supermadboy/boxbert/docs/cad/feather-window/electronics-photo.jpg

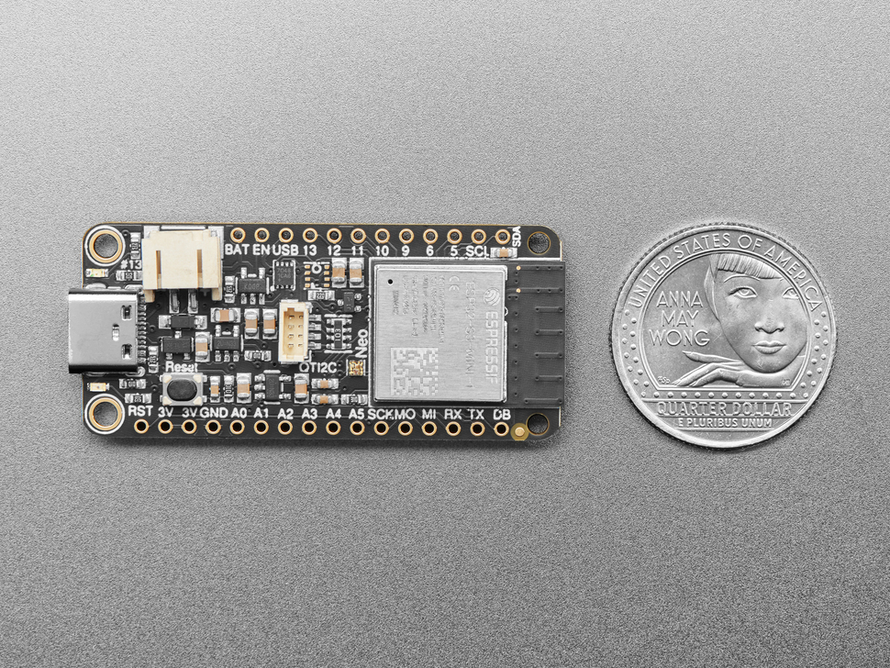
docs/cad/feather-window/electronics-photo.jpg
