supermadboy/boxbert/docs/cad/pn532/photo-correction-2026-11-10/desired-exterior-component-side.jpg

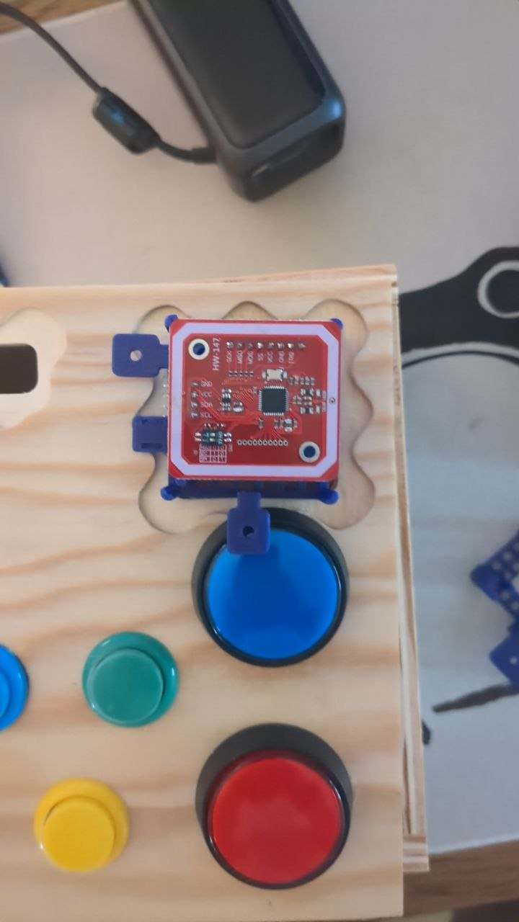
docs/cad/pn532/photo-correction-2026-11-10/desired-exterior-component-side.jpg
