supermadboy/boxbert/ideen/bluetooth-lautsprecher/README.md

# Bluetooth-Lautsprecher-Modus

## Beschreibung

Boxbert als Bluetooth-Lautsprecher für externe Geräte verwenden.

## Bisheriger Stand

BLE und klassische Bluetooth-Audioübertragung nicht gleichsetzen. Board-Kompatibilität noch gezielt zu prüfen.

## Noch zu besprechen / prüfen

Gewünschte Audioquelle und Profil klären; ESP32-S3-Fähigkeiten gegen Herstellerdoku prüfen.

## Entscheidungen und Nachweise

[Bestehende Projektdokumentation](../../hardware/BOM.md). Neue Entscheidungen und echte
Prüfergebnisse hier ergänzen und in die zuständige Fachdatei übernehmen.
