supermadboy/boxbert/hardware/noch-zu-besorgen.md

# Noch zu besorgen — Boxbert

Beschlossene Ergänzungen, nicht als bereits gekauft behandeln. Daddelbert
bestellt selbst. Mengen/Längen und konkrete Produkte sind noch offen.

## Kabel für den Endaufbau

- [ ] **AWG 20**, ca. **0,52 mm²**: Hauptversorgung (zusätzliche Akku–Boost-
  Leitungen und Boost–Verteiler) sowie zugehörige GND-Leitungen.
- [ ] **AWG 22**, ca. **0,33 mm²**: Versorgungsabzweige zu SD-Modul,
  Verstärker und NeoPixel-Stick, jeweils Versorgung und GND.
- [ ] **AWG 26**, ca. **0,13 mm²**: Signalleitungen und Taster.

Flexible **Kupferlitze**, kein starrer Draht und kein CCA. Für Versorgung
rot/schwarz, für Signale weitere Farben zur eindeutigen Zuordnung.
Querschnitte sind praktische Empfehlungen für kurze interne Leitungen,
keine gemessene Gesamtstrom-/Steckerfreigabe. Bestehendes Akkukabel nicht
ersetzen. Strombelastbarkeit der Verbindung Deckel–Boden separat prüfen;
Stromversorgung zunächst mit separaten Litzen statt beliebigem Flachbandkabel
planen. GND der Hauptversorgung trägt den gemeinsamen Rückstrom.
