supermadboy/boxbert/docs/pwa-uebergabe.md

# PWA-Übergabe nach UX-/Effekt-Ausbau

## Aktueller Einstieg

Live-Demo: https://habibi.supermittel.com/boxbert/?stand=ux-effects-4

Quelle ausschließlich `app/` in diesem Boxbert-Repo. In `ai-habibi/sites/boxbert/` liegen Hostingintegration und getracktes Deployment-Artefakt, keine zweite App-Quelle. `app/README.md` erklärt Nutzung, Adaptergrenzen und Bauen. Prüfungen: `app/docs/verification-ux.md` und `app/docs/verification-led-effects.md`.

## Vereinbarter Umfang ist umgesetzt

Drei Reiter Medienbibliothek/Zuordnung/LEDs, fixed Lautstärkebar, Medienkategorien Sounds/Musik (weiterhin nur MP3), System-Dark/Light, zehn grafische Demo-Buttons, umbenennbare RFID-Tags, unabhängiger Stick mit acht Pixeln und Onboard-Einzelpixel. Palette Einfarbig/Regenbogen ist unabhängig von Effekten. Stick: statisch, Atmen, links/rechts laufend, Mitte nach außen, sanfte Party. Onboard: zusätzlich langsamer Farbwechsel und Kerzen-Licht. Kein schnelles Stroboskop. Animation hält bei Reduced Motion an und pausiert im Hintergrund/bei Reiterwechsel.

Altdaten werden migriert; Dateien, Zuordnungen, Tag-Namen, Lautstärke und gültige LED-Einstellungen bleiben erhalten. Demo-Uploads speichern nur Metadaten; Namen, Kategorien, Button- und LED-Einstellungen liegen im Browser, nicht auf echter SD. Demo ist ausdrücklich Simulation.

42 Unit-/Vertrags-/Migration-/Engine-Tests bestanden. Parent hat Unit-Tests, echte HTTPS-Offlineprüfung, HTTPS-UX-Prüfung und HTTPS-Effektprüfung zusätzlich ausgeführt. Mobile/Desktop Hell/Dunkel und Lifecycle geprüft. Hintergrundereignis wurde im Headless-Browser kontrolliert simuliert. Kein echter ESP oder Android-Installationsdialog geprüft.

## Nicht Bestandteil dieser Umsetzung

Unabhängige Codeprüfung ohne blockierende Findings abgeschlossen.
Nichtblockierender UX-Hinweis für mögliche Folgearbeit: Bei Reiterwechsel
während eines Uploads läuft dieser weiter; Fortschritt/Abbrechen liegen derzeit
nur in der Medienbibliothek. Dort zurückwechseln, um den Transfer abzubrechen.
Eine zusätzliche HTTP-Moduswechsel-Regression mit LED-/Kategorie-Entwürfen
wurde angeregt, aber nicht zum Auftrag ergänzt.

Keine Firmware, TFT, BLE oder OTA geändert/geflasht. Etappe-5-HTTP-API bleibt `/files`, `/tags`, `/upload`; Gerätemodus zeigt fehlende Namens-/Kategorie-/Button-/Volume-/LED-APIs statt simulierten Geräteerfolg. Die Namensspeicherung auf SD ist als spätere Anforderung festgehalten. SD-Webhosting und die neuen APIs benötigen Firmwarearbeit und reale Hardwaretests, nicht nur Kopieren des SD-Webbuilds.

Der Release-Link mit Query umgeht online den bisherigen Service-Worker-Navigationscache; Offline ist die kanonische URL `/boxbert/` geprüft. Komfortables Update-Angebot ohne speziellen Link bleibt mögliche Folgearbeit, nicht ungefragt umgesetzt.

## Kurzer Folgeprompt bei Bedarf

> Wir machen bei Boxbert weiter. Lies `AGENTS.md`, `docs/pwa-uebergabe.md`, `app/README.md` und `To-Do.md` in `/home/habibi/projects/boxbert`. Der PWA-UX-/Effekt-Ausbau ist abgeschlossen und nur Demo; bestehende Firmware nicht ungefragt ändern. Meine nächste Aufgabe ist: …

Ein neuer Auftrag bestimmt den nächsten Schritt. Firmwareintegration nicht automatisch starten.
