supermadboy/boxbert/.hermes/plans/2026-10-16_151332-tft-v1-v2.md

# TFT V1/V2 Implementation Plan

**Aktueller Stand 18.10.2026:** V1 abgeschlossen; V2-Software mit optionalen
Boxbert-Frames abgeschlossen und online geprüft. Nachweise: `docs/tft-v2.md`
und `app/docs/verification-tft-v2.md`. Die ursprüngliche Recherche unten
bleibt als Herkunft erhalten; Hardwareintegration ist separat.

**Goal:** Eine verlässlich identische logische 240×135-Pixelanzeige im Browser und
auf dem ESP vorbereiten: zuerst V1 ohne Maskottchen, danach V2 mit optionalem
Boxbert-Sprite. Die Basis bleibt bei jedem Animationsfehler nutzbar.

**Architecture:** Ein kleiner gemeinsamer, deterministischer C++-Pixelrenderer
zeichnet UI und Bitmap-Schrift in RGB565. Auf dem ESP wird der Buffer über den
bestehenden ST7789-Treiber ausgegeben; im Browser läuft derselbe Renderer als
WebAssembly und wird ohne erneutes Textzeichnen auf Canvas dargestellt. V2
kopiert vorberechnete RGB565-Frames in denselben Buffer.

**Tech Stack:** vorhandener Arduino-/Adafruit-ST7789-Ausgabeweg, geplanter
plattformunabhängiger C++-Kern, Emscripten/WASM, React als Bedienhülle,
skriptgesteuertes Blender für optionale Assets. Dies ist ein recherchierter
Entwurf, keine bereits kompilierte oder auf Hardware geprüfte Integration.

## Auftrag und Freigabegrenze

16.10.2026: Daddelbert möchte einen sessionsübergreifenden Plan und Recherche,
noch keinen neuen Flash-/Firmwareauftrag. Aktuelle Vorschau gefällt; Schrift/
Typografie darf noch angepasst werden. Das Erscheinungsbild des Maskottchens
kann für eine zuverlässige Geräteumsetzung vereinfacht werden. Keine zwei
auseinanderlaufenden UI-Implementierungen. Firmware-Referenzen unverändert
lassen, keine neuen Pins/Partitionen/Funkfunktionen als Nebenauftrag.

Empfehlung: **diese Session mit Recherche/Plan abschließen, nächste Session nur
Phase 0/1**. Danach jede größere Phase mit eigenem klaren Startprompt. Dieser Plan
ist die persistente Checkliste; `To-Do.md` verweist darauf. Kein Wissen aus der
alten Chat-Historie als Voraussetzung.

## Umsetzung Phase 0/1 · 17.10.2026

Daddelbert bestätigte DejaVu Sans (Bold 16 px, Regular 12 px) und den Bau.
Gemeinsamer C++-Kern, echtes freistehendes WASM und die Canvas-Integration
sind gebaut. Native-/WASM-Pixelgleichheit, 51 App-Tests, TFT-/Lifecycle-/UX-
Browserprüfungen sowie echtes HTTPS und Offline-Neustart sind bestanden.
Nachweis: [TFT V1](../../app/docs/verification-tft-v1.md), Vertrag/Toolchain:
[TFT-Rendering](../../docs/tft-rendering.md).

Bewusste Toolchain-Konkretisierung: gepinntes LLVM/Clang + `wasm-ld` statt
Emscripten, da der Arduino-freie Kern weder libc noch JS-Glue benötigt.
Dasselbe C++ wird nativ und als WASM kompiliert. Der Browser expandiert nur
die RGB565-Kanäle zu RGBA; keine zweite Typografie-/Layoutimplementierung.
Ein statischer Framebuffer, keine zusätzliche Buffer-/DMA-/Task-Abstraktion.

**Aktueller Auftrag 18.10.2026:** Daddelbert bestätigt V1 als fertig und
beauftragt V2. V1 ist abgeschlossen. Die historische Phase 2 wird als spätere
ESP-Gesamtintegration separat verfolgt und sperrt V2 nicht. Kein neuer ESP-
Build-/Flash-/Hardware-Nachweis wird daraus abgeleitet. Referenzen bleiben
unverändert. Die folgenden Phasen/Startprompts sind die ursprüngliche Planung;
bei Abweichungen gilt diese aktuelle Freigabe.

## Befund aus dem Repo (historische Recherche)

- `firmware/tests/etappe7_gesamtmonitor/etappe7_gesamtmonitor.ino` verwendet
  Adafruit_GFX und Adafruit_ST7789. Initialisierung `init(135,240)` und
  `setRotation(1)`; SD und TFT teilen `SPI`, SD bei 4 MHz. Aktuelle
  Statusanzeige wird im Sketch einmal pro Sekunde erneuert. Diese Werte sind
  Quellbefunde, keine Messung der maximal möglichen Zeichenrate.
- Akkuwerte aus eigener Gauge-Task mit Wire-Mutex, Audio/NFC vorhanden.
  `currentSong` ist ein Name aus `TagMap`, Volume fest 6/21. WLAN wird im
  Referenzsketch nicht als vollständiger späterer UI-Zustandsvertrag geliefert.
- Die neue App-Vorschau ist bisher CSS/SVG/Systemschrift und hat feste Akku-/
  WLAN-/Volume-Beispiele plus simulierte Zeit. **Sie ist noch kein gleicher
  Pixelrenderer.** Quelle `app/src/TftPreview.jsx`, `tft.css` und
  `tft-status-icons.json`. Kein kompletter Geräte-Statusadapter vorhanden.
- `getAudioCurrentTime()` und `getAudioFileDuration()` existieren im dokumentierten
  Audio-Library-Stand 4.0.0.[7] Die Dauer kann dort bei fehlender Bitrate oder
  unbekannter Audio-Datengröße 0 zurückgeben; das muss als unbekannt behandelt
  werden, nicht mit einer Demo-Dauer kaschiert werden.[8]
- Gesamtintegration fehlt weiterhin: `docs/endinbetriebnahme.md`. Ein TFT-Build
  allein integriert nicht automatisch PWA/BLE/Upload/Intro oder Endaufbau.

## Format- und Werkzeugentscheidung (Empfehlung, noch kein Build)

### SVG, GIF und Sprites

- **Statussymbole:** keine SVG-Datei auf dem ESP voraussetzen. Die vorhandenen
  einfachen Symbolkoordinaten in gemeinsame konstante Zeichentabellen übernehmen.
  SVG bleibt optional ein Design-/Exportformat, nicht das Geräte-Laufzeitformat.
- **Schrift:** einmalige Bitmap-Glyphen mit festgelegten Metriken und Lizenz,
  identisch im gemeinsamen Renderer. Adafruit dokumentiert Bitmap-Fonts und
  `fontconvert` zur Konvertierung eigener TrueType-Schriften.[5] Nicht Browser-
  `fillText` gegen eine ähnliche TFT-Schrift testen und dann Gleichheit behaupten.
- **Boxbert:** Empfehlung **Blender-Python → PNG-Einzelbilder → RGB565-Framepaket**.
  Blender kann ohne GUI per Kommandozeile rendern; das ist ein geeigneter Weg
  für einen vollständig skriptbaren Asset-Build.[4] PNGs sind editierbare
  Master-/Zwischenbilder; der ESP bekommt zunächst feste RGB565-Pixeldaten mit
  Framegröße, Reihenfolge und Abspieldauer. Hintergrund zuerst deckend in der
  TFT-Hintergrundfarbe; keine transparente Mischpipeline als Zusatzkomplexität.
- Ein Sprite ist eine kleine Bildfolge, kein zwingend bestimmtes Dateiformat.
  Ein großes Sprite-Sheet muss nicht komplett ins RAM: Framepaket mit direktem
  Index und festen Größen ist der empfohlene erste Geräteentwurf.
- **GIF ist möglich**, aber für unseren ersten belastbaren Weg nicht empfohlen:
  AnimatedGIF kann von SD/Flash lesen; der Autor beschreibt Zusatzaufwand und
  Einschränkungen bei Transparenz, Paletten und Disposal-Modi.[3] Erst wählen,
  wenn ein gemessener Nutzen gegenüber einfachen Frames besteht. Kein GIF-Decoder
  allein für das Designpreview einführen.

### Warum gemeinsamer C++-Kern

Adafruit stellt 16-Bit-Canvasbuffer und RGB-Bitmap-Ausgabe bereit.[1][2]
Emscripten dokumentiert C-/C++-Funktionsaufrufe aus JavaScript und den Zugriff auf
WASM-Speicher.[6] Daraus ergibt sich unser Architekturvorschlag; der konkrete
Toolchain-/Rendererbau ist erst in Phase 1 nachzuweisen.

Nicht die gesamte Arduino-/GFX-Library ungeprüft nach WASM portieren: kleiner
Arduino-freier Kern mit injiziertem Zielbuffer, Bitmap-Schrift und nur benötigten
Primitiven. Bestehender Adafruit-Treiber bleibt Geräteausgabe. Schrift-Glyphen,
Layout, Farben, Spriteframe und Zeitauswahl werden **nicht** separat in JS neu
implementiert. React enthält nur Controls und die Darstellung des fertigen
Buffers.

**Identisch** bedeutet: bei identischem Zustands-Snapshot, Renderzeitpunkt und
Assetstand dieselben RGB565-Pixel. Physische Helligkeit/Farbwirkung des TFT und
des Handybildschirms können abweichen. Bildschirmfoto und Browser-Screenshot
sind kein Bit-für-Bit-Beweis. Upscaling im Browser nur ohne Interpolation.

### Rechenbeispiele, keine verfügbaren Speicherbudgets

Selbst berechnet: ein 240×135-RGB565-Frame benötigt **64.800 Bytes**; zwei
solche Buffer **129.600 Bytes**. Ein beispielhaftes Paket aus 24 Bildern mit
64×64 Pixeln braucht roh **196.608 Bytes (192 KiB)**. Ein solcher Sprite bei
12 Bildern/s erzeugt ohne Zusatzdaten **98.304 Bytes/s** Pixelnutzlast; ein
voller 240×135-Frame bei gleicher Rate **777.600 Bytes/s**. Das sind weder
SPI-Durchsatzmessungen noch Zusagen für Audio-/SD-Parallelbetrieb.

Die Boardangabe 2 MB PSRAM beweist nicht die freie Reserve der Gesamtfirmware.
Audio, Netzwerk, Uploads und BLE konkurrieren um Speicher. Zuerst ein Framebuffer,
keine pauschale Doppelbuffer-/DMA-/Framerateentscheidung. Flashgröße und reale
Heap-/PSRAM-Reserve pro Build/Lastfall protokollieren.

## Sessions und Abnahmetore

### Phase 0 — Anzeigevertrag und Typografie festlegen

- [x] Gegen aktuellen Quellstand und `hardware/pinout.md` prüfen, keine Referenzen ändern.
- [x] Eine Schrift mit guter kleiner Lesbarkeit vorschlagen; Lizenz, Größe,
      Glyphen/Zeichenumfang, Umlaute/ß und Ersatzzeichen dokumentieren.
      Daddelbert bestätigt genau diese noch offene Designentscheidung.
- [x] Snapshotvertrag entwerfen: Titel/Figur, Playbackstatus, verstrichene Zeit,
      bekannte/unbekannte Gesamtdauer, Volume 0–21/Mute, Akku gültig/ungültig/
      Ladezustand, Funk aus/Verbindung läuft/verbunden. Keine realen Endpunkte erfinden.
- [x] Fälle festlegen: langer Titel, UTF-8/Glyphen-Fallback, Boot/kein Tag,
      Pause/Ende, WLAN aus, fehlender Gauge, unbekannte Dauer, Dateifehler.
- [x] V1 (ohne Sprite) und V2 (mit Sprite) nutzen denselben Vertrag; Layoutflächen
      und Priorität lesbarer Information festlegen. V1 ist ein echtes Asset-freies Fallback.

Umgesetzte Dateien: `docs/tft-rendering.md`, `firmware/ui/TftState.h`,
`firmware/ui/fixtures/{states,golden-sha256}.json`, `assets/tft/fonts/`.
Zusätzliche Verhaltensprüfungen stehen unter `tools/tft/tests/`.
Abnahme: klare Zustandsdefinition und Schriftwahl, **keine** Hardware-Erfolgsbehauptung.

### Phase 1 — V1: gemeinsamer Renderer und ehrliche Browser-Vorschau

- [x] Toolchain zuerst klein nachweisen: C++-Framebuffer nativ und als WASM
      bauen, einen identischen Testframe exportieren. Toolversionen pinnen und
      Reproduktion ins Repo schreiben. Keine geratenen Nix-/Hermes-Felder.
- [x] Vertikales TDD: zunächst native/WASM-Pixelvergleich rot, erste primitive
      Funktion minimal umsetzen, Vergleich grün; dann Text/Status/Zeitleiste
      einzeln genauso ergänzen. Kein großer Mock-Renderer als Zwischenerfolg.
- [x] Neue Dateien: `firmware/ui/TftRenderer.{h,cpp}`,
      `tools/tft/build.mjs`, `tools/tft/tests/`, `app/src/TftCanvas.jsx`.
      Exakte Build-/Testbefehle beim Toolchain-Spike dokumentieren, nicht hier raten.
- [x] Font und Icon-Koordinaten aus einer Quelle in native und WASM-Build;
      keine CSS- oder Systemfont-Abhängigkeit innerhalb des TFT mehr.
- [x] Renderzeit explizit übergeben; Scrollen/Animation aus Zeit/Snapshot ableiten,
      nicht aus unkontrolliert getrennten Timern. RGB565-Kanalexpansion im Browser
      definieren; nativen Rohbuffer gegen WASM-Rohbuffer vergleichen.
- [x] `app/src/TftPreview.jsx` behält Control-/Demo-Hülle und klare Kennzeichnung;
      statt HTML-TFT ein pixelgenauer Canvasbuffer. Assetfreier Basic-Modus.
      Alte lokale Daten bleiben erhalten; bestehende Reiter unverändert.
- [x] Fixtures vollständig bytegleich testen; unbekannte Statuswerte sichtbar
      unbekannt, keine Demo-Fallbacks nach Gerätefehlern.
- [x] Regression: `npm test`, `node tests/tft-browser.mjs`,
      `node tests/ux-browser.mjs`, `node tests/tft-hosted-browser.mjs` mit einem
      funktionsfähigen `CHROMIUM_PATH`; Tests an neuen Renderer anpassen,
      bestehende Verhaltensprüfungen nicht entfernen. HTTPS und Offline neu prüfen.

Abnahme: V1 im Browser nutzt tatsächlich den gemeinsam kompilierbaren Kern;
alle Zustände/Tests grün. **Noch keine echte TFT-/Audio-/USB-Abnahme.**

### Separater späterer Integrationsblock — ESP-Geräteanbindung (ursprünglich Phase 2)

- [ ] Separaten TFT-Integrationssketch unter `firmware/tests/tft_ui_v1/` anlegen;
      bewährte Etappen 4/5/7 nicht überschreiben. Gepinnten Board-/Library-Stand
      und identischen getesteten Core verwenden.
- [ ] Bestehenden TFT-Init und Pin-/SPI-Vertrag übernehmen. Bufferzuordnung,
      PSRAM-Zugriff und Byte-Reihenfolge gegen Farbmuster prüfen.
- [ ] Echte Zustandsbeschaffung anbinden: Gauge/WLAN/Player/Lautstärke.
      Dauer-/Zeit-API mit realen MP3 inklusive VBR testen; 0/ungültig ≠ gültige Dauer.
- [ ] Anzeige bounded/nonblocking aktualisieren, Audio-Loop nicht mit Rendering
      verhungern lassen. SPI/SD-Zugriff nach tatsächlicher Taskstruktur schützen;
      keine neue konkurrierende SPI-Task ungeprüft hinzufügen.
- [ ] Erst real kompilieren, Flash-/RAM-Werte protokollieren. USB-Flash nur nach
      konkreter Freigabe und auf Daddelberts erreichbarem Rechner, nicht vom
      Hetzner-Server behaupten. `docs/dev-setup.md` beachten; genau getestetes
      Buildartefakt flashen. Kein aktueller Auftrag zum Flashen.
- [ ] Rohbuffer-Export/Fixturevergleich und Farbmuster, danach reale Bedienung:
      Tagwechsel, MP3-Ende, lange Titel, Pause, WLAN-Verlust, Gauge-Ausfall.
      Audio hören und Last/Frametimes/Restheap messen, Neustart prüfen.

Ziel dieses späteren Integrationsblocks: echte Geräte-/Lastprüfung.
V1 ist bereits abgeschlossen (Nutzerbestätigung 18.10.2026); dieser Block
ist keine noch offene V1-Abschlussbedingung.

### Phase 3 — Boxbert als reproduzierbares Asset bauen

- [x] `assets/tft/boxbert/scene.py` modelliert Box mit großen Augen und dezenter
      Persönlichkeit. Skriptgesteuerte Kamera/Licht/Bewegung, keine Handarbeit
      oder externen Designkonten nötig. Form darf dem Pixelraster angepasst werden.
- [x] Blender-Version und Rendereinstellungen pinnen; Quelldatei, Palette,
      Auflösung und Timing versionieren. PNG-Masterfolge rendern.
- [x] `tools/tft/convert-frames.py` erzeugt aus Masterframes ein definiertes
      RGB565-Paket plus Manifest: Größe, Byteorder, Frameanzahl/-dauer,
      Formatversion und Integritätsprüfung. Fehlerhafte/abweichende Maße ablehnen.
- [x] Erst kleine, langsame Loop erstellen. Assetgröße tatsächlich messen;
      nicht aus Beispielrechnung als fertige Dateigröße übernehmen.
- [x] Tests für Farbquantisierung, Byteorder, korrekte Framegrenzen, Timing und
      Loop-Naht. Browser muss die **fertigen Geräteframes** zeigen, nicht das
      Blender-Video oder ein separates CSS-Modell.

Abnahme: reproduzierbares Asset mit gemessener Größe und Pixelvorschau.
Hardware-Eignung/Framerate noch nicht daraus ableiten.

### Phase 4 — V2 optional integrieren, V1 niemals gefährden

Softwareumfang am 18.10.2026 abgeschlossen, siehe V2-Prüfbericht.
Die unten verbleibenden Budget-/Geräteprüfungen sind der separate spätere
ESP-Integrationsblock, keine offene Browser-/Software-V2-Aufgabe.

- [x] Spriteframe-Auswahl und Blit im gemeinsamen Renderer ergänzen; dieselben
      Native-/WASM-Golden-Vergleiche zu festen Zeitpunkten.
- [ ] Zunächst RAM-/Flashbudget messen; Speicherung kleiner Assets/SD-Streaming
      erst anhand echter Reserve und Audiolast entscheiden. Keine ganze Bildfolge
      blind ins RAM. Keinen separaten GIF-/PNG-/SVG-Decoder ohne neue Begründung.
- [x] Anzeige bleibt ohne Asset gültig. Fehlende/kaputte Datei, Formatfehler,
      SD-Lesefehler, geringer Speicher oder ausgelassene Frames dürfen weder Titel/
      Status noch Audio blockieren; klar auf V1 zurückfallen. Fehler nicht verstecken.
- [ ] Nur notwendige Displaybereiche übertragen, wenn Messungen dies erfordern;
      keine Performance-Optimierungen vor der funktionierenden Basis.
- [ ] Hardwarevergleich unter Audio/NFC/WLAN/Upload-Last; Frametimes, Aussetzer,
      SPI-Zugriffe, Heap-/PSRAM-Minimum und Boot/Sleep/Neustart prüfen.
      Animation muss aussetzbar sein; aktuelle Sleep-Entscheidungen nicht ändern.

Abnahme: V2 wirkt auf dem echten TFT gut, Daten/Audio bleiben stabil, V1-Fallback
getestet. Erst danach in die spätere Gesamtfirmware einplanen.

## Weiterarbeit in neuen Sessions

V1 ist abgeschlossen. V2-Software ist der aktuelle Auftrag vom 18.10.2026;
aktuelle Dateien und Prüfgrenzen stehen in [tft-v2.md](../../docs/tft-v2.md)
und im [V2-Prüfbericht](../../app/docs/verification-tft-v2.md).

Die alten V1-Phase-2-/V2-Startprompts sind aufgehoben. Späterer eigener Auftrag:

> Boxbert ESP-Gesamtintegration: Lies `docs/endinbetriebnahme.md` sowie die
> TFT-V1-/V2-Verträge. Bereite die gemeinsame Geräteanbindung samt realem Build
> und Speicherwerten vor; behalte V1 ohne Asset als Fallback. Referenz-Sketches
> unverändert lassen. Kein Flash ohne gesonderte Freigabe.

## Abschluss jeder Phase

- TDD-/Build-/Browser-/Hardwareprüfungen getrennt mit realen Ausgaben protokollieren.
- Diese Checkliste, `To-Do.md`, Ideenstatus und `docs/endinbetriebnahme.md` nur
  für den tatsächlich erledigten Umfang aktualisieren; letzte Tests nicht als
  vorweggenommene Gesamtprüfung ausgeben.
- Eigene Pfade explizit stagen, deutsch committen und fertig pushen.
- Quellen unterhalb sind Recherchequellen vom 16.10.2026. Beim Implementieren
  passende Versionen pinnen und gegen aktuelle Projektabhängigkeiten prüfen;
  Upstream `master/main` ist kein projektspezifischer Buildnachweis.

## Sources

[1] https://raw.githubusercontent.com/adafruit/Adafruit-GFX-Library/master/Adafruit_GFX.h — Adafruit GFX Header
[2] https://raw.githubusercontent.com/adafruit/Adafruit-GFX-Library/master/Adafruit_GFX.cpp — Adafruit RGB565
[3] https://raw.githubusercontent.com/bitbank2/AnimatedGIF/master/README.md — AnimatedGIF
[4] https://docs.blender.org/manual/en/latest/advanced/command_line/render.html — Blender CLI
[5] https://learn.adafruit.com/adafruit-gfx-graphics-library/using-fonts — Adafruit Bitmap Fonts
[6] https://raw.githubusercontent.com/emscripten-core/emscripten/main/site/source/docs/porting/connecting_cpp_and_javascript/Interacting-with-code.rst — Emscripten C++ und JavaScript
[7] https://raw.githubusercontent.com/schreibfaul1/ESP32-audioI2S/4.0.0/src/Audio.h — ESP32-audioI2S 4.0.0 Audio API
[8] https://raw.githubusercontent.com/schreibfaul1/ESP32-audioI2S/4.0.0/src/Audio.cpp — ESP32-audioI2S 4.0.0 Zeitanzeigen
