supermadboy/boxbert/docs/datenblaetter/EN2424-6T20.md

# EN2424-6T20 — Inkrementalgeber 24 Rastungen/Impulse, mit Taster, 6 x 20 mm

Quelle: BerryBase-Produktseite https://www.berrybase.de/inkrementalgeber-24-rastungen-24-impulse-taster-stehend-6-x-20mm-achse-printmontage
Stand: 27.09.2026 — Berry Base stellt zu diesem Produkt KEIN Datenblatt-PDF bereit,
nur die folgende Technische-Daten-Tabelle (Übernahme aus der Produktbeschreibung):

Encoder-Typ: inkremental
Montage: THT
Auflösung: 24 Impulse/Umdrehung
Anzahl Positionen: 24
Ausgangssignal: zwei Signale A und B
Mechanische Haltbarkeit: 30000 Zyklen
Betriebsspannung: 5 V DC
Betriebsstrom max.: 10 mA
Betriebstemperatur: -30...70 °C
Achsoberfläche: D-Schnitt
Achslänge: 20 mm
Achsendurchmesser: 6 mm
Kerben tiefe / Kerbentiefe: 1.5 mm
Tastenhub: 0.5 mm
Encodereigenschaften: mit Druckknopf
Gewicht Brutto: 0.002 kg
