supermadboy/boxbert/app/README.md

# Boxbert-Verwaltung · React-PWA

## Online: Upload-Verbesserung · 13.11.2026

Aktueller Link: **https://habibi.supermittel.com/boxbert/?stand=upload-wach-14**.
Nach expliziter Aktivierungsfreigabe veröffentlicht, öffentliche Artefakthashes
und HTTPS-/Offline-Browser geprüft. Echter Android-Wachhalte-/Introabschluss
noch offen. Alte Boxbert-Tabs schließen und neuen Link öffnen; keine Browserdaten
löschen, damit lokale Aufnahmen erhalten bleiben.

Prozentfortschritt und Abbrechen sind jetzt
auch beim Intro sichtbar. Echte Uploads fragen zusätzlich einen Screen Wake Lock
an, damit das Display nicht automatisch ausgeht. Nicht in der Demo oder bei
normalen Lese-/Steuerbefehlen. Freigabe bei Abschluss, Fehler, Abbruch und Verlassen
der App; erneute Anfrage bei Rückkehr zur sichtbaren Seite.

Das ist **best effort**, keine Hintergrund-BLE-Garantie: Browser/Energiesparmodus
können ablehnen oder die Sperre freigeben. Dann erscheint ein Hinweis. Chrome
weiter im Vordergrund lassen, nicht manuell sperren; gegebenenfalls Bildschirm-
Timeout verlängern. Unverschlüsseltes Geräte-HTTP hat normalerweise keine
Screen-Wake-Lock-API, der Upload bleibt mit manuellem Hinweis nutzbar. Keine
Upload-Wiederholung und keine verlängerten Firmware-/RPC-Timeouts eingebaut.

81 App-Tests, HTTP-Gerätefixture mit gemocktem Wake Lock, Demo- und HTTPS/offline-
Browserfälle sowie beide Builds bestanden. Echter Android-Display-/Uploadtest
bleibt offen. Details: [Protokoll](../docs/testprotokoll-app-funktionen-2026-11-13.md).
API-Grundlage: [MDN Screen Wake Lock](https://developer.mozilla.org/en-US/docs/Web/API/Screen_Wake_Lock_API).

## Gesamtfirmware V1 · 19.10.2026

Historischer Release vor Wachhalte-Ergänzung: **https://habibi.supermittel.com/boxbert/?stand=gesamtfirmware-13**.
Die Oberfläche besitzt jetzt echte **WLAN- und BLE-Geräteadapter** für
`firmware/boxbert/`. Demo-Daten bleiben separat im Browser; Verbindungsfehler
wechseln niemals still in eine Simulation. Keine Hardware-/Flashabnahme daraus.

- **HTTPS-PWA → BLE:** „Box über BLE“, Passwort eingeben und „BLE-Gerät
  auswählen und verbinden“. Ziel Android Chrome. Browser-Geräteauswahl muss
  aktiv bestätigt werden. HMAC-Zugriffsschutz ist keine zugesagte
  Verschlüsselung der BLE-Nutzdaten. Zugangsdaten werden nicht persistiert.
- **SD-Weboberfläche → HTTP:** relativen `dist-sd/`-Inhalt nach `/www/` auf
  SD übernehmen und direkt von der Box öffnen. Same Origin, HTTP Basic im
  vertrauten lokalen WLAN; die externe HTTPS-PWA spricht nicht beliebiges
  Geräte-HTTP an. Keine Service-Worker-Zusage für ungesichertes Geräte-HTTP.
- **Gerätefunktionen:** reale Medienliste/Kategorien, Player/Stop/Pause/Resume,
  Tag-Namen und Liedzuordnungen, zehn Button-Belegungen, Lautstärke und beide
  NeoPixel-Kanäle. Bestätigung erfolgt über die Firmware, nicht LocalStorage.
- **Intro:** weiter direkt pro Tag aufnehmen. Explizites „Intro auf Gerät
  übertragen“ konvertiert die erhaltene Browseraufnahme lokal zu MP3 und
  ordnet sie erst nach bestätigtem SD-Upload zu. Kein Konvertierungsserver,
  kein Löschen der Browseraufnahme bei Fehlern; Entfernen der Gerätezuordnung
  löscht keine Musik. Aufnahme verlangt Secure Context, daher auf Android die
  HTTPS-/BLE-Oberfläche nutzen. Kein nahtloser Audioübergang versprochen.
- Fehlende SD-Dateien bleiben als gespeicherte Zuordnungen korrigierbar;
  beschädigte Gerätekonfiguration wird ausdrücklich angezeigt. Chunk-Offsets,
  Commit, Abbruch und BLE-Trennung haben eigene Fehlerpfade.

[API](../docs/firmware-api-v1.md),
[Build und USB-Passworterholung](../docs/gesamtfirmware-build.md),
[noch auszuführende Geräteabnahme](../docs/gesamtgeraet-abnahme.md),
[Drittanbieter für MP3](../docs/third-party-mp3.md).
Aktuelle Tests: `npm test`, `tests/device-browser.mjs` (explizite
HTTP-Vertragsfixture mit nativem synthetischem Testmikrofon),
`../tools/firmware/verify-hosted.mjs` (echtes HTTPS/offline, kein Funkversuch).
Die älteren Etappe-5-HTTP-Browserfälle sind historische Übergabetests;
`HttpAdapter` bleibt separat als Legacy-Referenz, die neue Geräte-UI verwendet
`DeviceAdapter` und den V1-RPC-Vertrag.

**Die folgenden datierten Abschnitte dokumentieren frühere Zwischenstände.**
Damals fehlende Gerätefunktionen sind keine aktuelle Aufgabenliste; laufender
Abschluss-/Nachweisstand steht in `../To-Do.md`.

Live: **https://habibi.supermittel.com/boxbert/**
Aktueller Online-Release-Link: **https://habibi.supermittel.com/boxbert/?stand=tft-v2-cachefix-12**

### TFT V2 · optionaler animierter Boxbert

V1 ist abgeschlossen. V2 verwendet zwölf vorberechnete 64×64-Geräteframes
mit 160 ms pro Bild im selben C++-/WASM-Pixelrenderer. Boxbert wippt und
blinzelt bei Wiedergabe, Pause und Reduced Motion zeigen ein Standbild.
**Boxbert-Animation** lässt sich abschalten; dann bleibt die unveränderte
V1-Anzeige. Fehlende oder kaputte Frames melden einen Hinweis und lassen
V1 weiterlaufen. Derselbe Pixelstand wird mit der PWA offline gespeichert.

[Vertrag/Reproduktion](../docs/tft-v2.md),
[Prüfbericht](docs/verification-tft-v2.md). Spätere ESP-Gesamtintegration
bleibt separat; kein neuer Flash und keine Hardware-Lastabnahme.

### TFT V1 · gemeinsamer Pixelrenderer

Der TFT-Reiter verwendet jetzt den gleichen Arduino-freien C++-Kern wie die
native Gerätevorbereitung: RGB565, 240×135, DejaVu Sans Bold 16 px und Regular
12 px. Im Browser läuft dieser Kern als WebAssembly; Canvas zeigt ausschließlich
seine fertigen Pixel. Keine CSS-/SVG-/Systemschrift-Nachbildung im Display.
**V1 ist ohne Maskottchen abgeschlossen** (Nutzerbestätigung 18.10.2026).
V2 mit vorberechneten Boxbert-Frames ist ebenfalls als Software abgeschlossen. Die spätere
ESP-Gesamtintegration und deren reale Prüfungen bleiben separat.

Play/Pause, Titelwahl, Zeitleiste und manuelle Titelverschiebung bleiben reine
Beispiele. Zusätzliche Fälle zeigen Start, keine Figur, Dateifehler, unbekannte
Messwerte sowie Umlaute/ß und Ersatzzeichen. Reduced Motion hält die Laufschrift
an; alle Knöpfe und der vollständige Anzeigetext bleiben zugänglich. Der WASM-
Renderer wird mit der PWA offline gespeichert. Geräteadapter und gespeicherte
Demo-Konfiguration bleiben unabhängig.

Reproduktion und Anzeigevertrag: [TFT-Rendering](../docs/tft-rendering.md).
Abnahme und Grenzen: [TFT-V1-Prüfbericht](docs/verification-tft-v1.md).
Keine Gerätefirmware kompiliert/geflasht, kein echter TFT-/Audio-/Lasttest.

### Historischer Stand: Smartphone-Statusleiste

Akku, Lautstärke und WLAN erscheinen jetzt als kompakte Symbole oben rechts
im TFT, ohne ausgeschriebene Werte. Zugängliche Beschriftungen erhalten die
Beispielwerte. Die einfachen Symbolkoordinaten sind in `src/tft-status-icons.json`
für eine spätere C/C++-Übertragung gebündelt; keine Firmwareänderung.
48 Tests und echte HTTPS-/Offline-/UX-Prüfungen bestanden:
[aktueller Statusleisten-Prüfbericht](docs/verification-tft-statusbar.md).

## TFT-Vorschau · 16.10.2026

Neuer Reiter **TFT-Vorschau**: vollständige dunkle 240×135-Anzeige mit
3D-Boxbert, großen Augen, sanften Bewegungen, Akku, WLAN, Lautstärke, Figur,
Titel-Laufschrift und Fortschritt mit Spielzeit/Gesamtdauer. Play/Pause,
Zeitleiste und zwei Titel zum Ausprobieren. Alles ausdrücklich Beispieldaten,
kein Audio und keine ESP-/Firmware-Änderung. Bestehende Browserdaten bleiben
unverändert. Reduced Motion stoppt dekorative Animationen; Titel manuell scrollbar.

47 Tests und echte HTTPS-/Offline-/UX-Prüfungen bestanden;
[aktueller Prüfbericht und Screenshots](docs/verification-tft.md).

## Intro direkt je RFID aufnehmen · 11.10.2026

Unter **Zuordnung** direkt bei der Figur **Aufnehmen** drücken, Mikrofon
freigeben und **Stoppen und speichern** wählen. Keine Dateiauswahl aus der
Bibliothek. **Aufnahme löschen** entfernt nach Bestätigung nur die Aufnahme
dieser UID, nicht Tag oder Song. **Aufnahme abbrechen** und Reiterwechsel
verwerfen eine laufende Aufnahme; eine frühere gespeicherte Aufnahme bleibt
bis zum erfolgreichen Speichern der Neuaufnahme erhalten.
Die Sprachaufnahme-Karte zeigt Mikrofon-, Stop-, Abbruch- und Löschen-Icons.
Während der Aufnahme läuft ein Zähler in **mm:ss**; die gespeicherte Dauer
bleibt nach Reload und Offline-Neustart sichtbar. Neue Aufnahmen speichern
die gemessene Aufnahmezeit zusammen mit dem Blob. Ältere Aufnahmen bleiben
erhalten; ihre Audiodauer wird lokal dekodiert, soweit der Browser das Format
unterstützt. Sonst steht ausdrücklich **Dauer unbekannt**. Der Aufnahmeindikator
zeigt den Zustand, keine gemessene Wellenform; weiterhin kein Abspielen.
[Aktueller UI-Prüfbericht](docs/verification-recording-ux.md).

Audiodaten bleiben lokal in **IndexedDB**, übrige Demo-Einstellungen in
`localStorage`; keine Server-Speicherung, Synchronisierung oder Übertragung
auf SD. Browserdatenverlust verliert auch Aufnahmen.

Der Browser bestimmt das Aufnahmeformat; keine MP3-Konvertierung implementiert.
Aktuelle Firmware unterstützt diesen Intro-Weg noch nicht. HTTP-Modus bleibt
deaktiviert; Mikrofonzugriff verlangt HTTPS (bzw. localhost beim Entwickeln).
Eine normale lokale HTTP-WebUI auf dem ESP kann ihn nicht einfach übernehmen.
Kein automatisches Abspielen und keine Garantie für einen
nahtlosen Übergang am ESP. Der frühere Zuordnungs-Mock ist ein
[historischer Zwischenstand](docs/verification-intro.md).
Aktuelles Aufnahme-Prüfverfahren und Grenzen:
[Aufnahme-Prüfprotokoll](docs/verification-recording.md).

## UX-Erweiterung · drei Bereiche (11.10.2026)

- **Medienbibliothek**: ausschließlich eigene **MP3**, Kategorien **Sounds / Musik**
  beim Demo-Upload wählen, filtern und später pro Datei ändern. Kategorieänderungen
  speichern sofort. Altdaten erhalten **Musik**, Dateien bleiben am bisherigen Pfad.
  Kategorien sind Browser-Metadaten, **keine echte SD-Kategorisierung**.
- **Zuordnung**: zehn grafische Demo-Buttons sowie die zwei RFID-Tags mit frei
  umbenennbaren Namen und MP3-Zuordnung. Bestehende IDs/UIDs bleiben erhalten.
- **LEDs**: NeoPixel-Stick mit **8 Pixeln** (`pixel`, bisheriger kompatibler Zustand)
  und **ESP Onboard mit 1 NeoPixel** (`boardPixel`) getrennt steuern und speichern:
  **Palette Einfarbig / Regenbogen** unabhängig vom **Effekt** wählen; Farbe bleibt
  erhalten und ist bei Regenbogen deaktiviert. Stick: Aus, Statisch, Atmen,
  Lauflicht links → rechts / rechts → links, Mitte → außen, sanftes Party-Funkeln.
  Onboard: Aus, Statisch, Atmen, Party, langsamer Farbwechsel, Kerze.
  Beide Vorschauen verwenden dieselbe deterministische Effekt-Engine (8 + 1 Pixel).
  Onboard startet bei alten Daten ausgeschaltet. Reduced Motion hält eine feste
  Momentaufnahme; Hintergrund/Reiterwechsel stoppen die Animationsschleifen.
  Vorschau zeigt den Entwurf; erst der jeweilige Speichern-Knopf persistiert ihn.
  Speichern des anderen Kanals oder der Lautstärke verwirft keinen LED-Entwurf.
  Reiterwechsel und Reset verwerfen Entwürfe bewusst. Kein echtes Hardware-Licht.
- **Lautstärke**: auf allen Reitern eine wirklich **fixed** Bar am unteren Fensterrand,
  explizit **Lautstärke speichern**, Demo-Skala 0–21 ohne Sicherheitsfreigabe.
  Safe-Area und zusätzlicher Seitenabstand verhindern Überdeckung am Seitenende.
- **Systemtheme**: folgt automatisch `prefers-color-scheme`, kein Theme-Schalter.
  Dauerhafte Nutzerpräferenz für diese App: Daddelbert verwendet ein dunkles
  Systemtheme; Boxbert soll dessen Dark/Light-Einstellung übernehmen.
- Reiter sind per Tab sowie Pfeil links/rechts und Home/End bedienbar. Nur der
  aktive Inhalt ist gerendert, keine für Tests versteckten Vollseiten. Gespeicherte
  Daten bleiben erhalten; ungespeicherte LED-/Namens-/Upload-/Zuordnungsentwürfe
  werden beim Reiterwechsel ausdrücklich verworfen. Lautstärkeentwurf bleibt stehen.
- **Verbindung & Demo-Werkzeuge** bündelt die bisherigen Details, Fehlersimulation
  und Reset. Demo-Badge, Speichergrenzen und Online-/Offline-Status bleiben sichtbar.
  Im HTTP-Modus öffnen sich Verbindung/Zugang automatisch. Kategorie, beide LEDs,
  Lautstärke, Buttonbelegung und Namensänderung sind dort deaktiviert: APIs fehlen.

Nachweise und Cache-Hilfe: [UX-Prüfprotokoll](docs/verification-ux.md),
aktuelle Effekt-Integration: [LED-Prüfprotokoll](docs/verification-led-effects.md).

Eine schlichte gemeinsame Oberfläche für **eigene MP3** und taggebundene
**Browser-Introaufnahmen** (separat, browserabhängiges Audioformat).
Kein Online-Soundkatalog, keine Downloads, kein Backend, keine Firmware-,
TFT- oder OTA-Änderungen. Ohne ESP als **sichtbare Gerätesimulation**
bedienbar; Introaufnahmen sind echte lokale Mikrofonaufnahmen. Der Quellcode liegt nur hier in `boxbert/app/`.

## Jetzt benutzen — Demo

1. HTTPS-Link öffnen. Oben steht immer **Demo · Simulation**.
2. Eigene `.mp3` auswählen → **MP3 hochladen**. In der Demo werden **nur
   Dateinamen** gespeichert; keine Audiodaten kopiert oder abgespielt.
3. Für einen der zwei bekannten Tags eine Datei wählen → Zuordnung speichern.
4. Unten Lautstärke wählen → **Lautstärke speichern**; unter **LEDs** jeden Kanal separat einstellen und speichern.
   Das ist nur Browser-Vorschau, keine echte Box-Steuerung und kein Sicherheitslimit.
5. Optional Musik aktiv / SD-Fehler / Verbindung verloren simulieren. Während
   des simulierten Transfers kann abgebrochen werden. Fehler erzeugen keinen
   erfolgreichen Eintrag. **Demo zurücksetzen** mit Bestätigung stellt alle
   Ausgangsdaten wieder her; reale SD-Dateien bleiben unberührt.

Demo-Modus, Dateimetadaten, Zuordnungen und Einstellungen bleiben in diesem
Browser (localStorage); eigene Introaufnahmen separat in IndexedDB.
Browserdaten können gelöscht werden; kein Backup und
keine Synchronisierung. Fehler bei beschädigtem/vollem Speicher werden sichtbar.
Reset löscht nach Bestätigung auch die lokalen Introaufnahmen. Scheitert der
Metadatenreset, bleiben Aufnahmen erhalten; ist nur der Aufnahmespeicher nicht
verfügbar, wird der Metadatenreset ausdrücklich als Teilreset gemeldet.
Es gibt keinen heimlichen Demo-Fallback
nach einer gescheiterten Geräteanfrage.

## Grafische Demo-Button-Belegung & Regenbogen (11.10.2026)

- In **Demo-Soundbelegung** einen der zehn nummerierten Buttons anklicken:
  **1–4 links (30 mm), 5–8 in der Mitte (24 mm), 9–10 rechts (44 mm)**.
  Die Darstellung ist schematisch; kleine Displays stapeln die vier linken
  und mittleren Buttons jeweils senkrecht. Kein maßhaltiges Bohrbild.
- Die Auswahl zeigt die gespeicherte MP3. Vorhandene Demo-Datei oder
  **Unbelegt** wählen → **Button-Belegung speichern**. Auswahl allein
  speichert nichts. Beim Wechsel des Buttons werden ungespeicherte Entwürfe
  verworfen. Die Belegungen bleiben nach Reload; Demo-Reset leert alle zehn.
- Alle zehn sind ausdrücklich **nur in der Demo** belegbar. Das entscheidet
  weder Verkabelung noch echte Hardwarefunktionen. Eigenständige Soundbelegung,
  kein Ersatz für Play/Pause/Lautstärke. **RFID-Soundboard-Aktivierung ist
  weiterhin nicht gebaut**, ebenso wenig echtes Demo-Audio/Playback.
- **Regenbogen** ist jetzt eine separate Palette, kombinierbar mit jedem Effekt.
  Statisch zeigt am Stick acht feste Farben; der einzelne Onboard-Pixel zeigt
  eine Farbe, **Farbwechsel** durchläuft die Palette langsam. Einfarbiges Grau
  bleibt bei Farbwechsel grau; Kerze moduliert die Helligkeit der gewählten Farbe.
  0 % bleibt dunkel. Legacy `effect: regenbogen` ohne Palette migriert verlustfrei
  zu `palette: rainbow, effect: statisch`, sonst ergänzt fehlende Palette `solid`.
  Migration überschreibt keine ungültigen Rohdaten, sondern zeigt die Speicherwarnung;
  gültige Daten werden beim nächsten erfolgreichen Demo-Write kanonisch persistiert.
  `DemoAdapter.settings` akzeptiert auch den alten Schema-Eingang. Keine Hardware-API.
- Im lokalen HTTP-Gerätemodus sind Button-Auswahl, MP3-Belegung und Speichern
  ausgegraut: **Button-API fehlt**. Es gibt keinen erfundenen `/buttons`-Request,
  keinen Speichererfolg und keine Übernahme der Demo-Belegung als Gerätedaten.
- Vorhandene gültige `boxbert-demo-v1`-Daten werden beim Lesen um zehn leere
  Buttons ergänzt; Dateien, Tags, Lautstärke und Pixel bleiben erhalten. Die
  nächste erfolgreiche Demo-Änderung persistiert den ergänzten Zustand.
  Beschädigte Daten melden weiterhin eine sichtbare Warnung statt stiller Migration.

Nachweise: [Prüfprotokoll Button-/Regenbogen-Erweiterung](docs/verification-buttons-rainbow.md).

## Tags umbenennen

In der RFID-Zuordnung einen Namen eingeben und **Name speichern** wählen.
Namen wie **Schleichstegosaurus** oder **Dino 🦕** bleiben nach Reload erhalten;
UID und MP3-Zuordnung ändern sich dabei nicht. Leer stellt Tag 1/2 wieder her.
Unicode ist erlaubt, UI-Grenze 80 Codepoints. Alte Demodaten erhalten Defaultnamen,
Dateien und bisherige Einstellungen bleiben erhalten.

**Aktuell nur Browser-Demo**, keine Speicherung auf SD. Im HTTP-Gerätemodus
sind Namensfelder deaktiviert, da der Firmware die Namens-/SD-API fehlt.
SD-Speicherung ist als spätere Anforderung im
[Erweiterungsprotokoll](docs/verification-buttons-rainbow.md) dokumentiert.

## Installation & Offline

HTTPS-PWA mit Manifest, eigenen 192/512-PNG-Icons und Service Worker. Nach
**Offline-Cache bereit** und erfolgreichem ersten Laden funktioniert die Demo
auch ohne Host/Internet. Browsermenü „App installieren“ / „Zum Startbildschirm“;
ein eigener Installieren-Knopf erscheint, wenn Chrome den Installationsdialog
anbietet. Browser-/Android-Menüinstallation nicht automatisiert auf einem echten
Handy getestet. Cache-Verlust/Erstbesuch erfordern Internet.

Nur statische Shell-Dateien werden gecacht, niemals Geräte-API, MP3-Uploads oder
Passwörter. Cache-Version aus Buildinhalten; ein neuer Worker wartet regulär auf
das Schließen alter App-Fenster, aktiviert danach den neuen Shell-Cache und
entfernt alte **Boxbert**-Shell-Caches. Andere Apps bleiben unberührt. Vor einem
Update Transfers beenden und alle Boxbert-Fenster schließen; neu online öffnen.
Normales lokales **HTTP auf dem ESP ist keine zugesagte Offline-PWA**.

## Bauen / testen

Node aus dem ai-habibi-Flake (`--no-update-lock-file`), vorhandener Node funktioniert.
Für TFT V1 zusätzlich Nix: `build.mjs` baut vor Vite den gepinnten C++-/WASM-Kern
und kopiert das WASM nach `public/` (generiert/ignoriert). Nach frischem Checkout
vor einem Vite-Entwicklungsserver einmal `npm run build` ausführen.
Fontquellen und generierte Glyphen sind versioniert; kein Fontdownload zur Laufzeit.

```sh
cd /home/habibi/projects/boxbert/app
npm ci --no-audit --no-fund
npm test                     # Unit + API-Adapter + beide Build-Verträge
npm run build                # gemeinsamer TFT-Kern, dist/ und dist-sd/
(cd .. && node tools/tft/tests/fixtures.mjs && tools/tft/build/tft-native --selftest) # 80 Pixelvergleiche + UTF-8-Grenzen
CHROMIUM_PATH=/pfad/zu/chromium node tests/tft-browser.mjs
CHROMIUM_PATH=/pfad/zu/chromium node tests/tft-lifecycle-browser.mjs
CHROMIUM_PATH=/pfad/zu/chromium node tests/tft-hosted-browser.mjs
npx playwright install chromium
npm run test:browser          # Browser-Demo
node tests/local-browser.mjs # SD-Build gegen lokalen HTTP-Contract-Server
node tests/tag-names-browser.mjs # Namens-/80-Codepoint-Regression
node tests/ux-browser.mjs    # 3 Reiter, Kategorien, 2 LEDs, fixed Bar, Systemtheme
node tests/led-browser.mjs   # Animation/Richtungen, Palette+Effekt, RAF-Cleanup/Reduced Motion
BOXBERT_URL='https://habibi.supermittel.com/boxbert/?stand=ux-effects-4' node tests/ux-browser.mjs # echte HTTPS-UX + Offline
npm run test:https            # echte HTTPS-URL, PWA/Offline/Interaktionen
```

Tests verwenden Playwright. Bei vorhandenem System-/Nix-Browser:
`CHROMIUM_PATH=/absoluter/pfad/zu/chrome npm run test:browser` (auch `test:https`).
Dieser Testserver lauscht nur an 127.0.0.1 mit temporärem Port und wird geschlossen;
kein dauerhaft laufender Dienst. Der HTTP-Contract-Server ist ausdrücklich eine
**Testfixture**, kein ESP-Nachweis. Alle Ergebnisse: [Prüfprotokoll](docs/verification.md).

- `dist/`: Hosted Build mit Basis **/boxbert/**, PWA/SW.
- `dist-sd/`: SD-ready Build, **relative Assets**, vorgesehen unter **/**,
  ohne Manifest/SW. Initial **Lokale Box · HTTP / Nicht verbunden**;
  Demo wird nur ausdrücklich gewählt, und diese Wahl bleibt im Browser.
- `dist*` sind hier generierte/ignorierte Dateien. Das getrackte HTTPS-Artefakt
  liegt ausschließlich in `ai-habibi/sites/boxbert/dist`.
- Deployment: `/srv/ai-habibi/build.sh boxbert` baut diese Quelle und kopiert
  nur das Hostingartefakt. Kein zweiter App-Quellbaum.

## SD später integrieren — noch nicht auf dem ESP implementiert

Inhalt von `dist-sd/` später unter `/www/` auf die **gemountete** SD kopieren;
nicht `dist-sd` als zusätzlicher Pfad und nicht die Node-/React-Quellen kopieren.
Firmware muss `/` auf `/www/index.html` abbilden, Webassets mit richtigen MIME-
Typen aus dem Webordner streamen, `/files`, `/tags`, `/upload` getrennt bedienen
und beliebige SD-Pfade/Secrets/Traversal sperren. Musikdateien bleiben im
Kartenwurzelverzeichnis. Kein root-/SD-Mount wurde hier durchgeführt.

Die aktuelle Etappe-5-Firmware liefert ihr eingebettetes altes HTML und **nicht**
diesen SD-Webbuild. Einfach auf SD kopieren reicht daher noch nicht. Relative
Assets ermöglichen dieselbe Oberfläche unter der Box-Herkunft; API-Anfragen
bleiben absolut same-origin (`/files` etc.). Nach Firmware-Integration dort
öffnen, **Lokale Box (HTTP)** wählen, Box-Passwort eingeben und verbinden.

## API-Anbindung / ehrliche Grenzen

Quelle des existierenden Vertrags:
`firmware/tests/etappe5_web_upload/etappe5_web_upload.ino` (unverändert).

| Funktion | HTTP Etappe 5 | Demo |
|---|---|---|
| Dateiübersicht | `GET /files` → String-Pfade[] (keine Größen, max. 128 im Sketch) | simulierte Pfade |
| Zuordnung lesen | `GET /tags` → `{uid,path}[]`, zwei bekannte UIDs | dieselben zwei UIDs |
| Zuordnung ändern | `POST /tags`, URLSearchParams `uid,path` → `{ok:true}` | Browser-Persistenz |
| Upload | `POST /upload`, Multipart Feld `file` → `{ok:true}` | zeitgesteuerter Metadaten-Transfer |
| Tag umbenennen | **nicht verfügbar**, Namens-/SD-API fehlt | wiederholt änderbare Namen, UID stabil, Browser-Persistenz |
| Intro aufnehmen/löschen | **nicht verfügbar**, Intro-/Format-/SD-Weg fehlt | echter Mikrofonzugriff mit Berechtigung, UID-Blob in IndexedDB, kein ESP |
| Button-Soundbelegung | **nicht verfügbar**, kein Request/kein Erfolg | zehn stabile IDs, MP3 oder leer, Browser-Persistenz |
| Lautstärke/NeoPixel | **nicht verfügbar**, kein Request/kein Erfolg | persistente Simulation |
| Funk-/SD-/Audio-Status | **unbekannt**, keine Status-API | sichtbar simuliert |
| Löschen / Play / neue UID / Playlist / BLE | **nicht verfügbar** | nicht als Gerätefeature erfunden |

`HttpAdapter` in `src/adapters.mjs` validiert Antwortschemas, erwartet bestätigtes
`ok:true` bei Writes, kennt nur diese Routen. Spätere Adapter müssen denselben
Vertrag erfüllen (`read`, `assign`, `upload`, `settings`) und Fähigkeiten/Versionen
mit der künftigen Firmware abstimmen; **keine BLE-UUIDs erfunden**.

HTTP Basic: Benutzer **boxbert**, Passwort nur im App-Arbeitsspeicher für die
aktuelle Verbindung (nie localStorage, Cache, Repo). **Trennen** oder Reload
entfernt es aus der App. HTTP Basic über HTTP ist unverschlüsselt: nur im
vertrauten lokalen WLAN, keine Internetfreigabe. Firmware-Writes verlangen
exaktes `Origin: http://<Host>`; der Browser setzt Origin bei same-origin POST.
Keine externe Zieladresse eintragbar, kein CORS-/HTTPS→HTTP-Umgehungsversuch.
Extern zunächst Demo, BLE klar noch nicht implementiert.

Uploadgrenzen entsprechen dem Sketch: **max. 16 MiB**, nicht leer, Name 5–64
ASCII-Zeichen (A–Z/a–z/0–9/`-_.`), nicht mit Punkt beginnend, flach, **`.mp3`
kleingeschrieben**, kein Überschreiben. Name/Größe beweisen keine MP3-Decodierbarkeit.
Bei Musik aktiv, bestehender Datei oder blockierendem Temp-Upload kann **409**
kommen. Musik vorher an der echten Box stoppen (keine Stop-API vorhanden).
Fetch liefert keinen bestätigten Zwischenfortschritt; reales HTTP zeigt daher
unbestimmten Fortschritt bis Firmware-Bestätigung statt erfundener Prozentwerte.
Demo-Prozentwerte ausdrücklich simuliert.

401/403/409/413/500, Netzwerk, falsches JSON/Schema, Abbruch und 30-s-Zeitlimit
werden angezeigt. Nach einem echten Schreibabbruch/-fehler kann die Box schon
Daten geschrieben haben: **Gerätestand unklar**, Liste neu laden und SD/Temp-Datei
prüfen, nicht blind erneut senden. Keine Wiederaufnahme-/Rollback-/Integritäts-
oder Hardware-Erfolgsgarantie. Stale Daten nach Fehler sind keine aktuelle
Statusbestätigung; Verbindungsbadge wechselt auf Nicht verbunden.

Noch separat erforderlich: Firmware-SD-Hosting/MIME/Recovery, Fähigkeits-/Status-
und Lautstärke/NeoPixel-APIs samt Firmware-Limits, neue Tag-Erfassung/Playlists,
BLE-Protokoll/Autorisierung/Transferabbruch, Android-/ESP-Speicher-/Audio-/Last-
und Sicherheitsprüfung. Keine Firmware geflasht, kein TFT oder OTA gebaut.
