supermadboy/boxbert/ideen/hoer-memory/README.md

# Hör-Memory mit RFID-Karten

## Beschreibung

Zwei unterschiedliche RFID-Karten spielen dasselbe Geräusch. Das Kind legt
Karten nacheinander auf, hört zu und findet die zusammengehörenden Paare.

## Bisheriger Stand

Daddelbert hat am 10.10.2026 die Aufnahme in die Ideendatenbank freigegeben.
Die konkrete Spielgestaltung und Umsetzung sind noch offen; kein Bauauftrag.
Vorbild: [TonUINO-TNG](https://github.com/tonuino/TonUINO-TNG), das bereits
einen Memory-Modus enthält. Keine ungeprüfte Übernahme auf unsere Firmware.

## Noch zu besprechen / prüfen

- Anzahl der Paare, Geräusche und Rückmeldung bei richtigen/falschen Paaren.
- Zwei verschiedene Karten pro Paar; dieselbe Karte zweimal zählt nicht als Paar.
- Spielstart, Spielende und Rückkehr zur normalen Wiedergabe.
- Vorhandene Tags prüfen; zusätzliche Tags bei Bedarf separat einplanen.
- Große, robuste Karten statt verschluckbarer kleiner Spielsteine.

## Entscheidungen und Nachweise

Nur die Aufnahme als offene Idee ist freigegeben. Keine Implementierung oder
Hardwareprüfung erfolgt.
