supermadboy/boxbert/ideen/soundboard/README.md

# Soundboard für die Arcade-Knöpfe

## Beschreibung

Eine „Krachmacher“-RFID-Figur schaltet die funktionalen Arcade-Knöpfe
vorübergehend auf kurze Geräusche um, etwa Bagger, Hupe, Hund, Trommel oder
selbst aufgenommene Quatschsätze. Eine andere Figur bringt die normale
Musikbedienung zurück.

## Bisheriger Stand

Daddelbert hat am 10.10.2026 die Aufnahme in die Ideendatenbank freigegeben.
Eigener Ergänzungsvorschlag zum Busyboard-Charakter von Boxbert.
Konkrete Gestaltung und Umsetzung sind offen; kein Bauauftrag.

## Noch zu besprechen / prüfen

- Welche bereits funktional angeschlossenen Knöpfe welche Geräusche auslösen.
- Unterbrechen, nacheinander abspielen oder ignorieren bei schnellen Tastendrücken.
- Verhalten laufender Musik beim Wechsel in den Soundboard-Modus.
- Aufnahme-/Uploadweg für eigene Geräusche und Zuordnung in der App.
- Rückkehr zur normalen Bedienung und Verhalten nach Neustart.
- Deko-Knöpfe müssen dafür nicht alle elektrisch angeschlossen werden.
- Lautstärkebegrenzung und akustische Bewertung weiterhin berücksichtigen.

## Entscheidungen und Nachweise

Nur die Aufnahme als offene Idee ist freigegeben. Keine Implementierung oder
Hardwareprüfung erfolgt. Dieser Modus ist nicht das bestehende
[Intro je RFID](../rfid-intro/README.md).
