supermadboy/boxbert/ideen/autoplay/README.md

# Auto-Play-Modus

## Beschreibung

Musik automatisch starten lassen.

## Bisheriger Stand

Keine konkreten Startbedingungen beschlossen.

## Noch zu besprechen / prüfen

Start beim Einschalten, ohne Tag oder nach Trackende; Auswahl und Unterbrechung klären.

## Entscheidungen und Nachweise

[Bestehende Projektdokumentation](../../To-Do.md). Neue Entscheidungen und echte
Prüfergebnisse hier ergänzen und in die zuständige Fachdatei übernehmen.
