supermadboy/boxbert/ideen/bilderbibliothek/README.md

# Bilderbibliothek in der App

## Beschreibung

Bilder für die Gestaltung auswählen und zuordnen können.

## Bisheriger Stand

Anzeigeort noch nicht festgelegt.

## Noch zu besprechen / prüfen

App, TFT oder beides; Upload/Quelle, Bildzuordnung und Speicherbedarf klären.

## Entscheidungen und Nachweise

[Bestehende Projektdokumentation](../../app/). Neue Entscheidungen und echte
Prüfergebnisse hier ergänzen und in die zuständige Fachdatei übernehmen.
