supermadboy/boxbert/ideen/deep-sleep/README.md

# Deep Sleep und Wiederaufnahme

## Beschreibung

Beschlossenen Schlafplan umsetzen und am vollständigen Aufbau prüfen.

## Bisheriger Stand

Prinzip besprochen: Display/Audio/Licht aus, Boost abschalten, Amp-Shutdown; PN532 bleibt laut früherer Entscheidung versorgt. Kein gemessener Gesamtsleep-Strom.

## Noch zu besprechen / prüfen

Abschaltung, Rückspeisung, Ruhestrom, Wake-Taster und Wiederaufnahme prüfen; RFID-Wake ist eine spätere ungeprüfte Erweiterung.

## Entscheidungen und Nachweise

[Bestehende Projektdokumentation](../../docs/power-plan.md). Neue Entscheidungen und echte
Prüfergebnisse hier ergänzen und in die zuständige Fachdatei übernehmen.
