supermadboy/boxbert/ideen/kabellaengen/README.md

# Kabellängen und Einkaufsmengen

## Beschreibung

Nach der Anordnung benötigte Kabellängen und Mengen bestimmen.

## Bisheriger Stand

AWG 20/22/26 als Kupferlitze stehen bereits auf der Einkaufsliste. Kabelführung und Verdrillen sind dokumentiert.

## Noch zu besprechen / prüfen

Konkrete Wege messen, Deckelspiel vorsehen und Einkaufsmengen ergänzen.

## Entscheidungen und Nachweise

[Bestehende Projektdokumentation](../../hardware/noch-zu-besorgen.md). Neue Entscheidungen und echte
Prüfergebnisse hier ergänzen und in die zuständige Fachdatei übernehmen.
