supermadboy/boxbert/ideen/lautsprecher-einbau/README.md

# Lautsprecher-Einbau konkretisieren

## Beschreibung

Beschlossene rückseitige Montage mit 2-mm-Lochraster und innerer Ausfräsung ausarbeiten.

## Bisheriger Stand

Grundprinzip vom Nutzer akzeptiert und im Gehäusekonzept dokumentiert. Keine physische Abnahme.

## Noch zu besprechen / prüfen

Raster, Restwandstärke, Befestigung und Hörvergleich am Reststück festlegen.

## Entscheidungen und Nachweise

[Bestehende Projektdokumentation](../../hardware/gehaeuse-konzept.md). Neue Entscheidungen und echte
Prüfergebnisse hier ergänzen und in die zuständige Fachdatei übernehmen.
