supermadboy/boxbert/ideen/mini-heisskleber/README.md

# Mini-Heißklebepistole

## Beschreibung

Kleine temperaturgeregelte Heißklebepistole als Montagehilfe.

## Bisheriger Stand

Empfehlung besprochen und positiv aufgenommen; noch nicht gekauft oder auf die Einkaufsliste übernommen.

## Noch zu besprechen / prüfen

Nur ergänzende Kabel-/Teilefixierung. Keine alleinige Akku-/Platinen-/Lautsprecherbefestigung; elektrische Isolation mit Schrumpfschlauch. Einkauf bei Bedarf separat freigeben.

## Entscheidungen und Nachweise

[Bestehende Projektdokumentation](../../hardware/noch-zu-besorgen.md). Neue Entscheidungen und echte
Prüfergebnisse hier ergänzen und in die zuständige Fachdatei übernehmen.
