supermadboy/boxbert/ideen/spotify/README.md

# Spotify-Verbindung

## Beschreibung

Boxbert mit Spotify verbinden.

## Bisheriger Stand

Noch keine technische Machbarkeitsprüfung oder Implementierungszusage.

## Noch zu besprechen / prüfen

Steuerung vs. direkte Wiedergabe, Konto, Internetbedarf und Plattformgrenzen prüfen.

## Entscheidungen und Nachweise

[Bestehende Projektdokumentation](../../docs/entscheidungen.md). Neue Entscheidungen und echte
Prüfergebnisse hier ergänzen und in die zuständige Fachdatei übernehmen.
