supermadboy/boxbert/ideen/tft-knopfbelegung/README.md

# Belegung der kleinen TFT-Knöpfe

## Beschreibung

Praktische Funktionen für die mit einem Zahnstocher erreichbaren Onboard-Knöpfe bestimmen.

## Bisheriger Stand

Mögliche Betriebsmodi stehen als separate Ideen in der Übersicht. Keine Belegung beschlossen.

## Noch zu besprechen / prüfen

Kurzer/langer Druck, Elternfunktionen, versehentliche Betätigung und Boot-Taster berücksichtigen.

## Entscheidungen und Nachweise

[Bestehende Projektdokumentation](../../hardware/pinout.md). Neue Entscheidungen und echte
Prüfergebnisse hier ergänzen und in die zuständige Fachdatei übernehmen.
