supermadboy/boxbert/firmware/archive/etappe4_tag_music/README.md

# Verworfener kombinierter Sketch

Am 04.10.2026 auf Nutzerwunsch aus den aktiven Tests entfernt. Die Datei
`etappe4_tag_music.ino.txt` dient ausschliesslich als historische Ablage,
nicht als Vorlage oder flashbarer Test.

Der Nutzer bestaetigt nur funktionierendes Tag-Lesen ueber I2C. Arbeiten
und vermeintliche Testergebnisse des vorherigen Agenten am kombinierten
Sketch sind nicht vom Nutzer bestaetigt und werden nicht als
Hardware-Nachweis uebernommen.

Neuer Einstieg: `firmware/tests/etappe4_inventory/` — ohne Audio, nur
SD-Dateiliste und getrennte Erfassung der beiden Tag-UIDs. Eine neue
Musik-Firmware entsteht erst anhand tatsaechlich gelesener Dateipfade und
UIDs.
