supermadboy/boxbert/3d-print/concepts/feather-window/concept.png

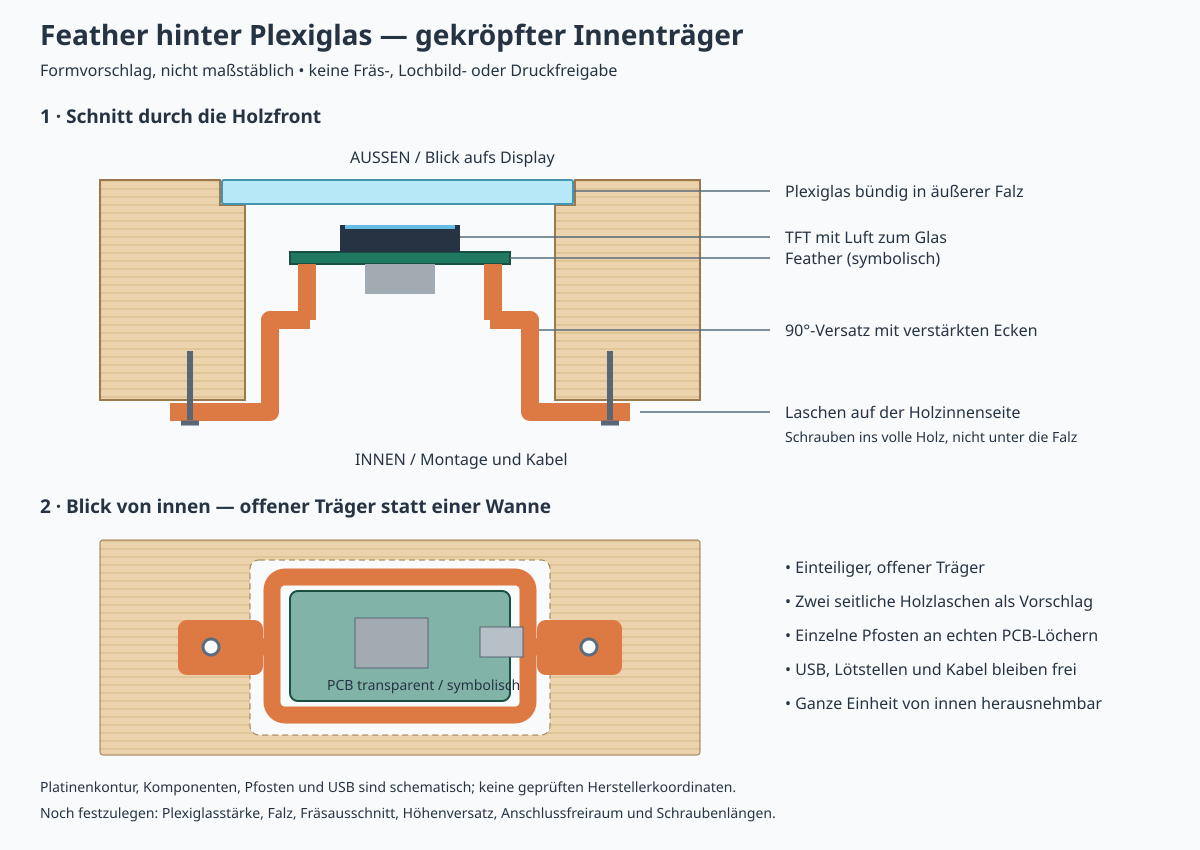
3d-print/concepts/feather-window/concept.png
