supermadboy/boxbert/3d-print/mounts/neopixel-stick-mount/overview.png

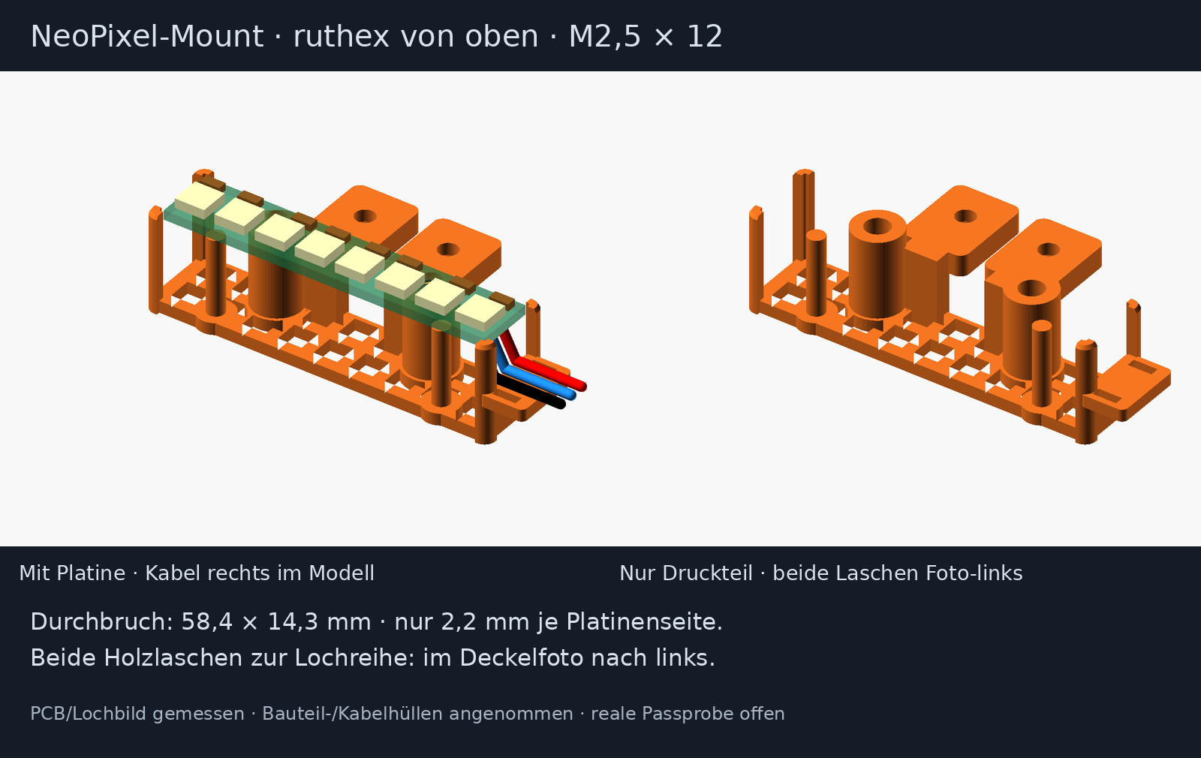
3d-print/mounts/neopixel-stick-mount/overview.png
