supermadboy/boxbert/3d-print/mounts/pn532-mount/overview.png

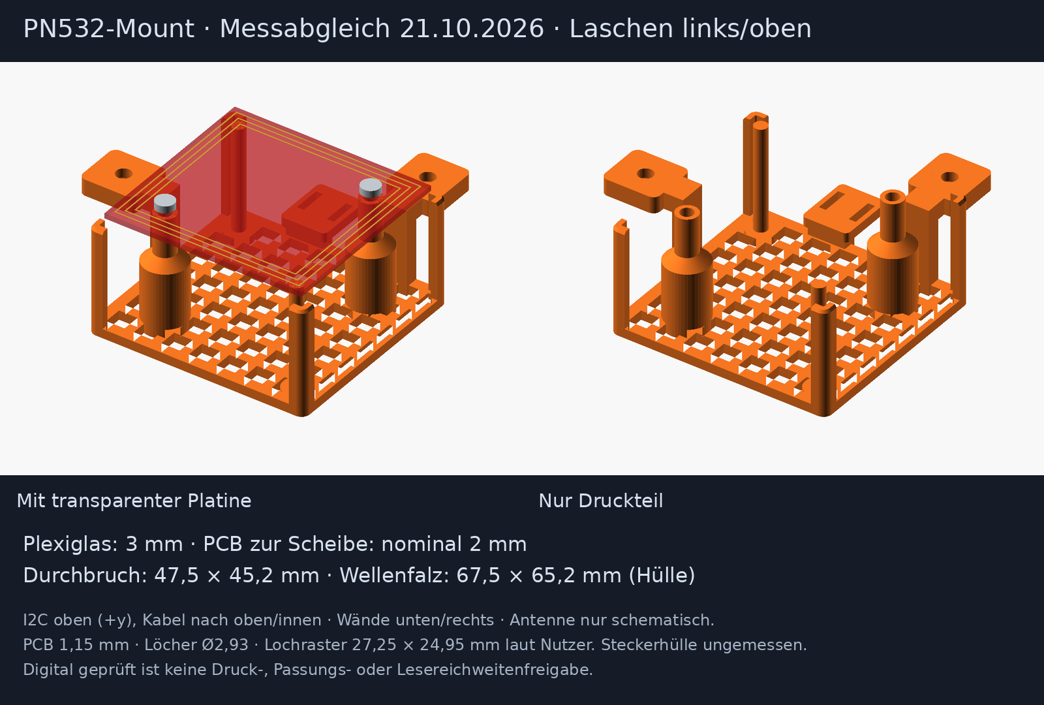
3d-print/mounts/pn532-mount/overview.png
