supermadboy/boxbert/3d-print/mounts/sd-mount/overview.png

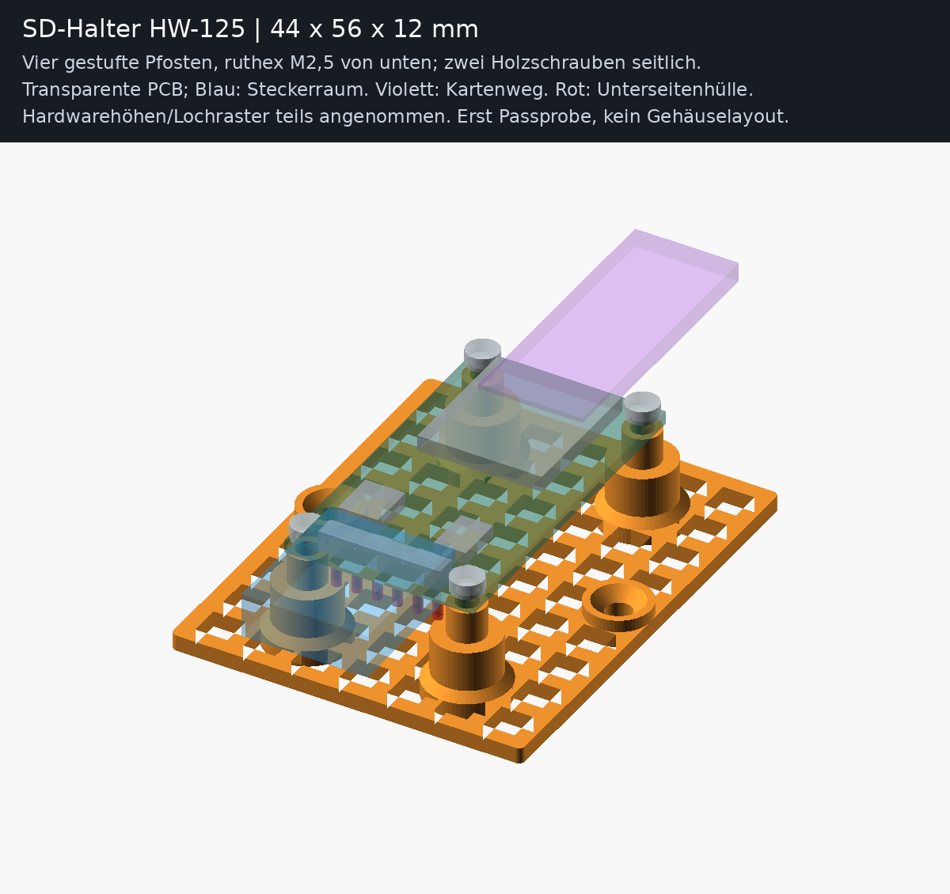
3d-print/mounts/sd-mount/overview.png
