supermadboy/boxbert/app/docs/recording-ui/recording-mobile.png

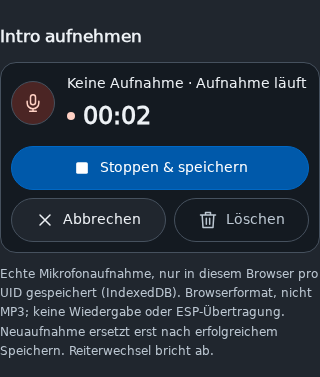
app/docs/recording-ui/recording-mobile.png
