supermadboy/boxbert/app/docs/recording-ui/saved-mobile.png

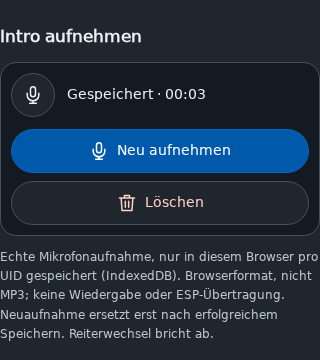
app/docs/recording-ui/saved-mobile.png
