supermadboy/boxbert/app/docs/tft-v2-ui/display-dark.png

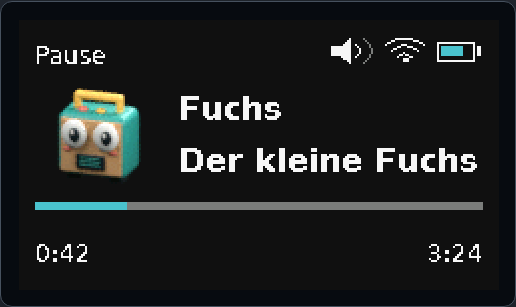
app/docs/tft-v2-ui/display-dark.png
