supermadboy/boxbert/app/docs/tft-v2-ui/display-umlauts.png

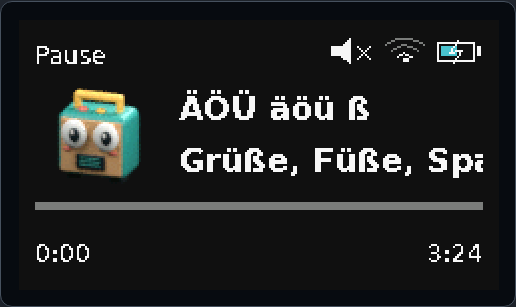
app/docs/tft-v2-ui/display-umlauts.png
