supermadboy/boxbert/app/docs/tft-v2-ui/display-unknown.png

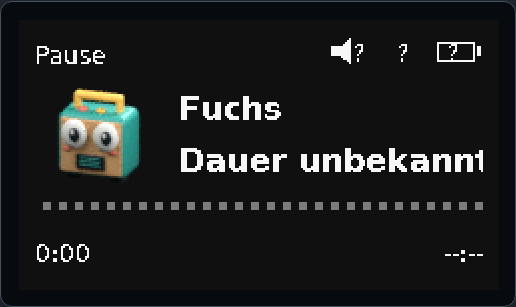
app/docs/tft-v2-ui/display-unknown.png
