supermadboy/boxbert/app/docs/tft-v2-ui/preview-desktop-dark.png

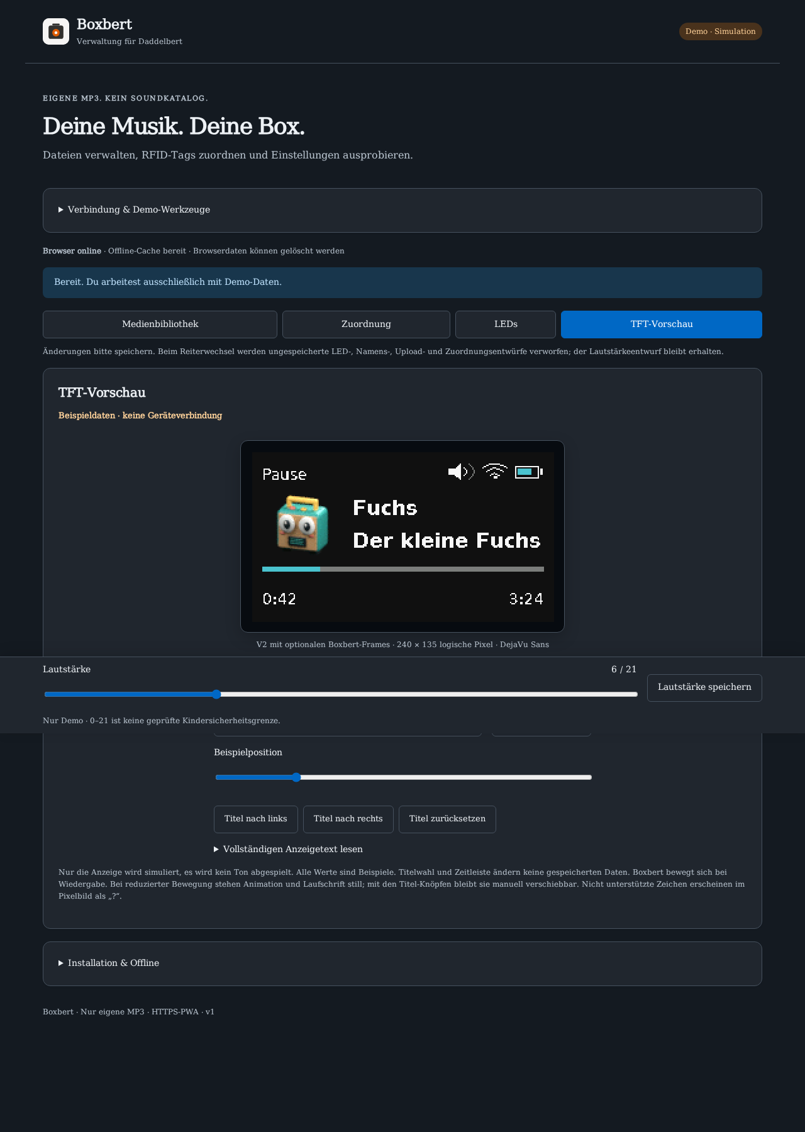
app/docs/tft-v2-ui/preview-desktop-dark.png
