supermadboy/boxbert/app/docs/tft-v2-ui/preview-mobile-dark.png

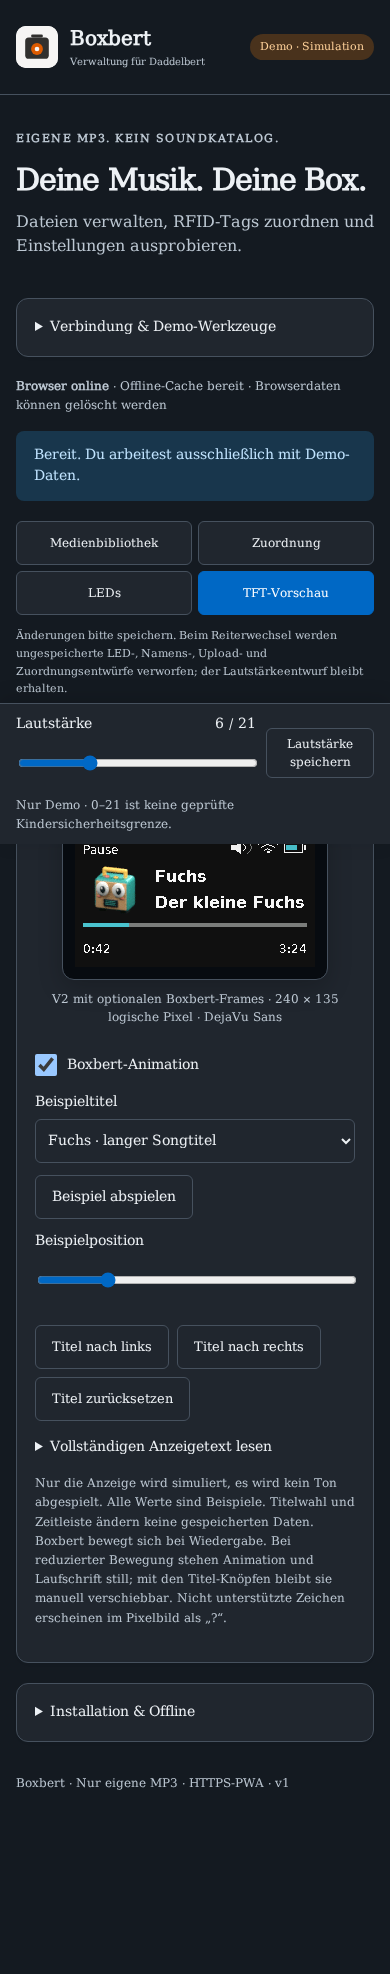
app/docs/tft-v2-ui/preview-mobile-dark.png
