supermadboy/boxbert/app/docs/tft-v2-ui/preview-mobile.png

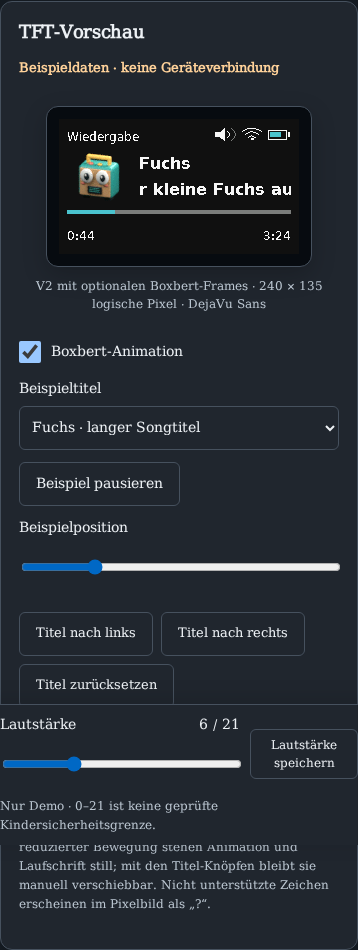
app/docs/tft-v2-ui/preview-mobile.png
