supermadboy/boxbert/assets/tft/boxbert/contact-sheet.png

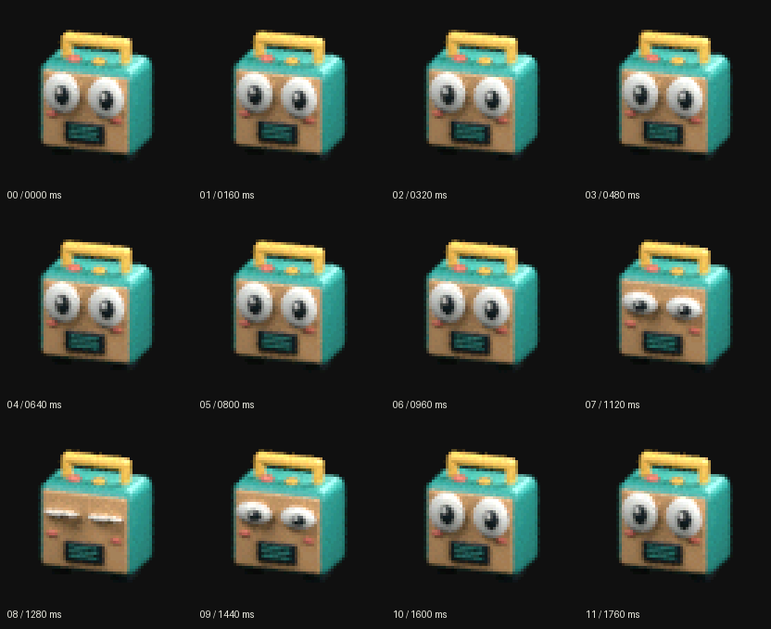
assets/tft/boxbert/contact-sheet.png
