supermadboy/boxbert/docs/cad/2026-10-09-aw9523-redesign/sources/4886-underside.jpg

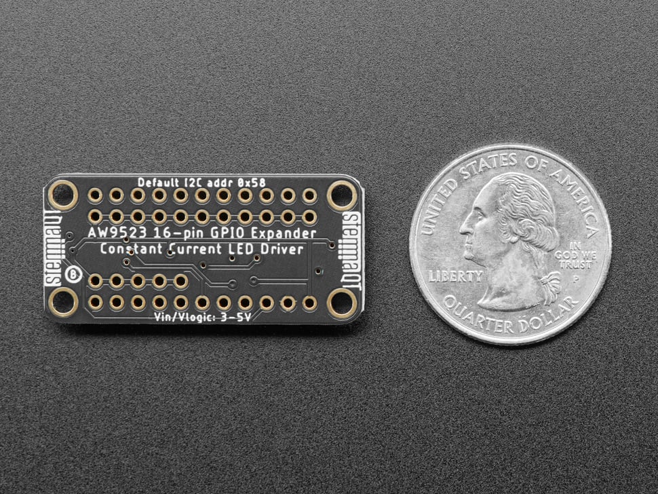
docs/cad/2026-10-09-aw9523-redesign/sources/4886-underside.jpg
