supermadboy/boxbert/docs/cad/2026-10-09-max98357-mount/sources/user-bottom.jpg

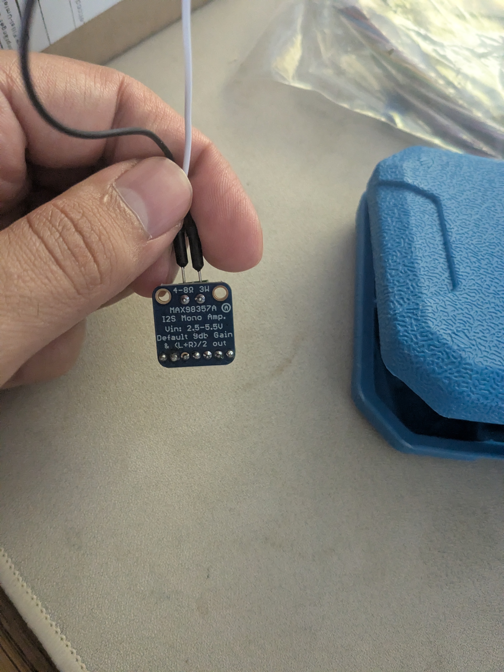
docs/cad/2026-10-09-max98357-mount/sources/user-bottom.jpg
