supermadboy/boxbert/docs/cad/2026-10-09-max98357-mount/sources/user-top.jpg

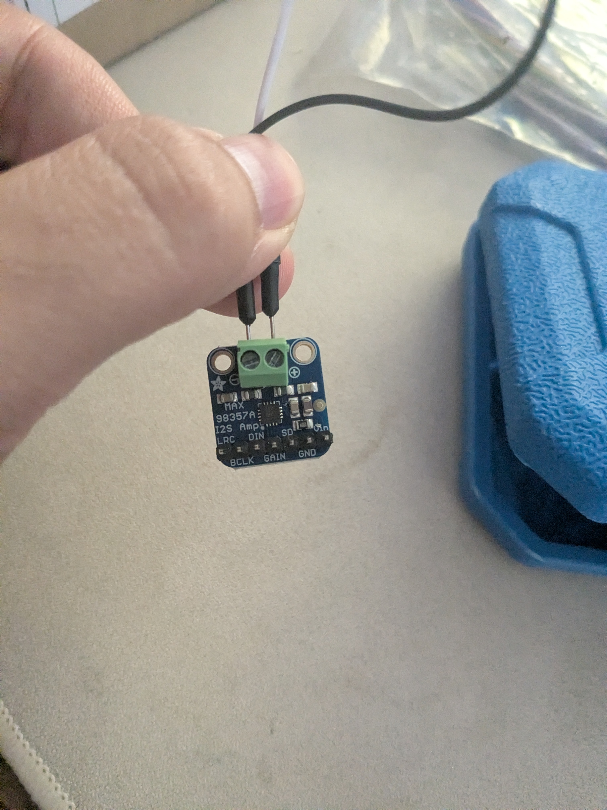
docs/cad/2026-10-09-max98357-mount/sources/user-top.jpg
