supermadboy/boxbert/docs/cad/2026-10-09-sd/user-sd-top.jpg

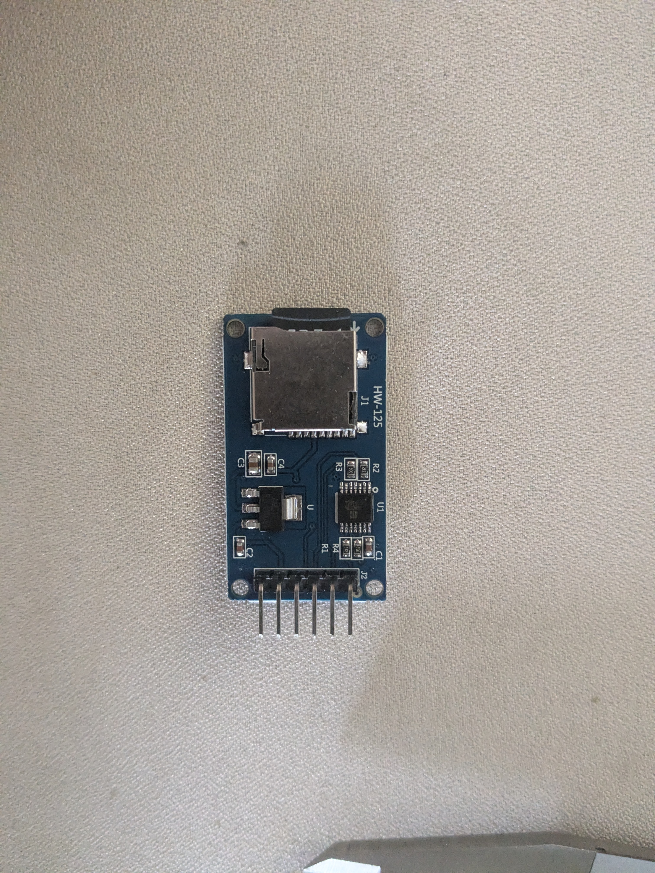
docs/cad/2026-10-09-sd/user-sd-top.jpg
