supermadboy/boxbert/docs/cad/neopixel-stick/shop-back.webp

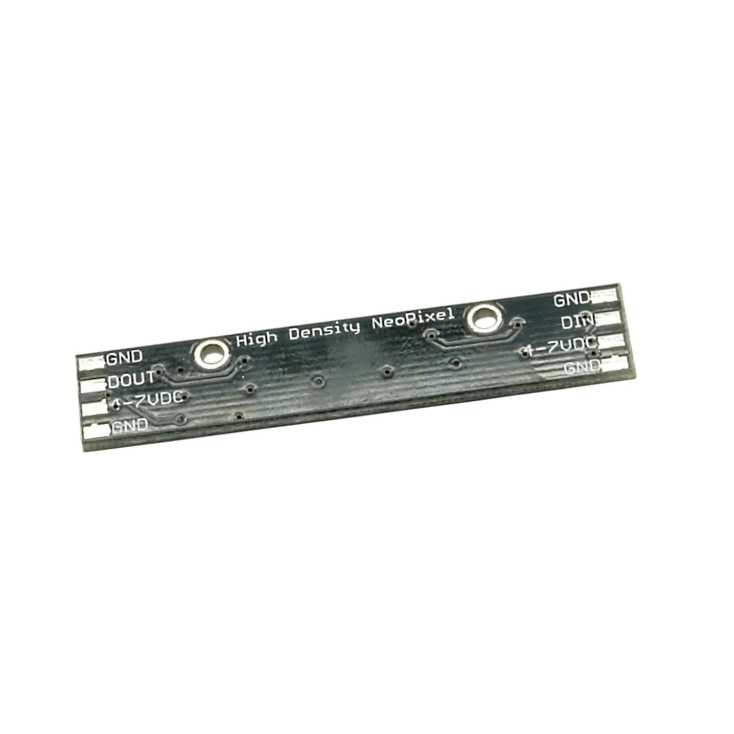
docs/cad/neopixel-stick/shop-back.webp
