supermadboy/boxbert/docs/cad/neopixel-stick/shop-lit.webp

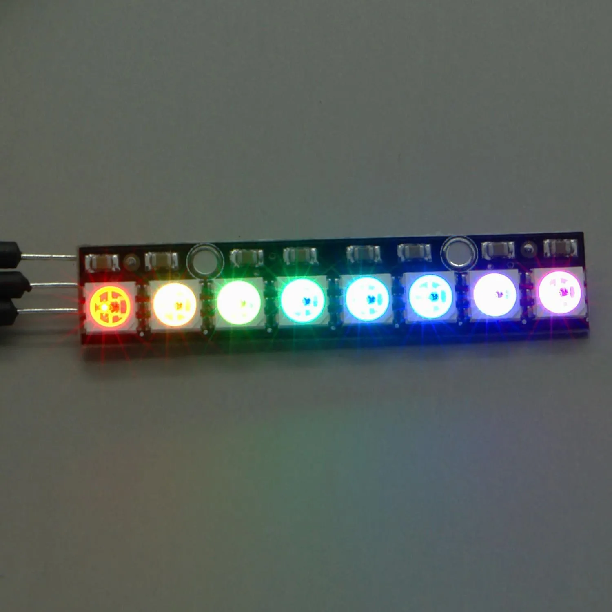
docs/cad/neopixel-stick/shop-lit.webp
