supermadboy/boxbert/docs/cad/pn532/drawing-page2.png

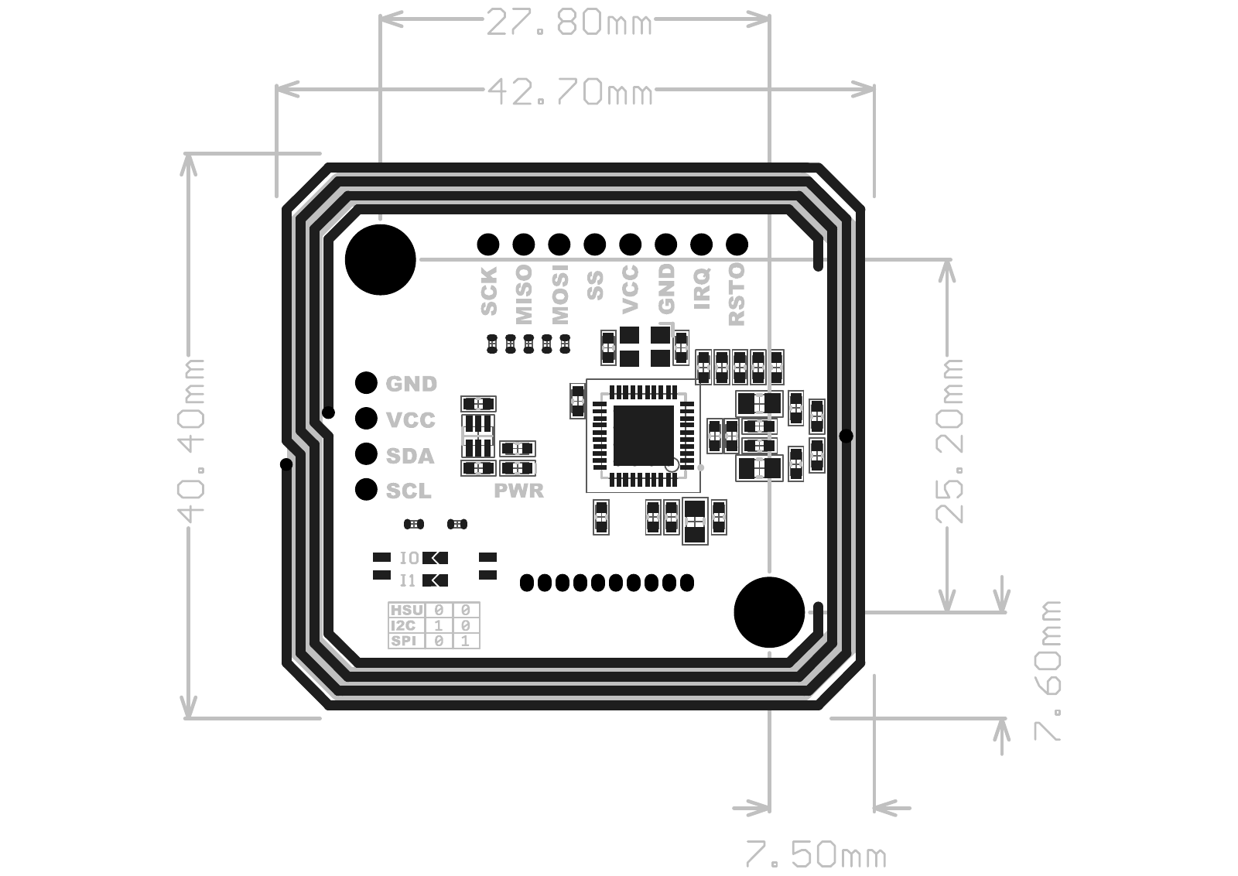
docs/cad/pn532/drawing-page2.png
