supermadboy/boxbert/docs/cad/pn532/photo-correction-2026-11-10/wrong-pcb-orientation.jpg

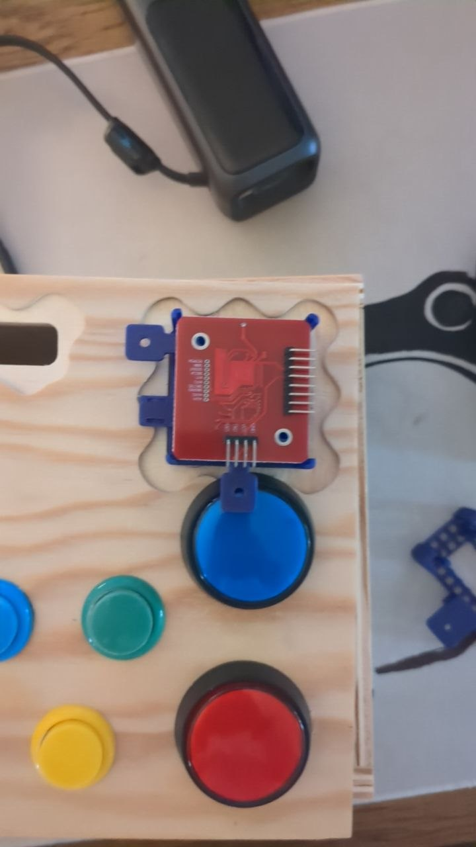
docs/cad/pn532/photo-correction-2026-11-10/wrong-pcb-orientation.jpg
