supermadboy/boxbert/3d-print/mounts/pn532-mount/logs/photo-exterior/collision_assembly.stl

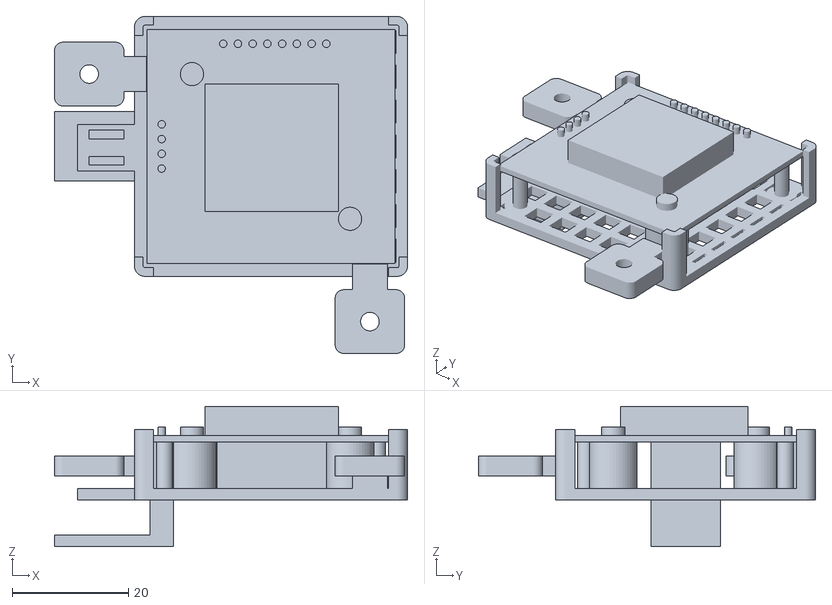
[picture p24: CAD file, 2026-11-10]
3d-print/mounts/pn532-mount/logs/photo-exterior/collision_assembly.stl
60.9 x 58.1 x 24.1
