supermadboy/boxbert/3d-print/mounts/akku-mount/akku_base.stl

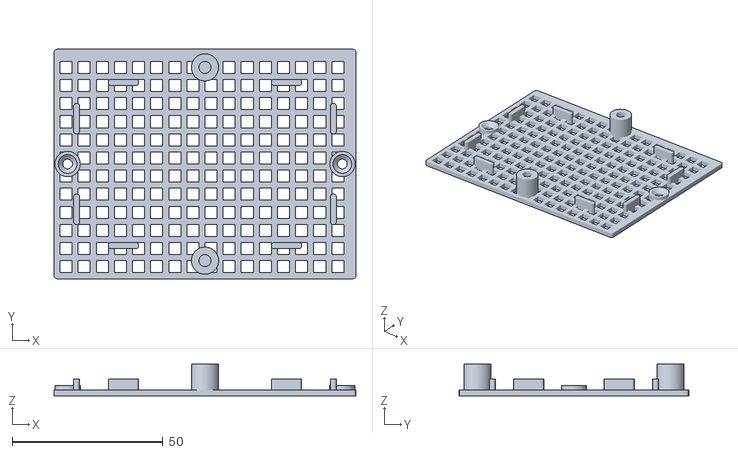
[picture p25: CAD file, 2026-10-10]
3d-print/mounts/akku-mount/akku_base.stl
100.0 x 76.0 x 10.5
