supermadboy/boxbert/3d-print/mounts/aw9523-mount/aw9523_mount.stl

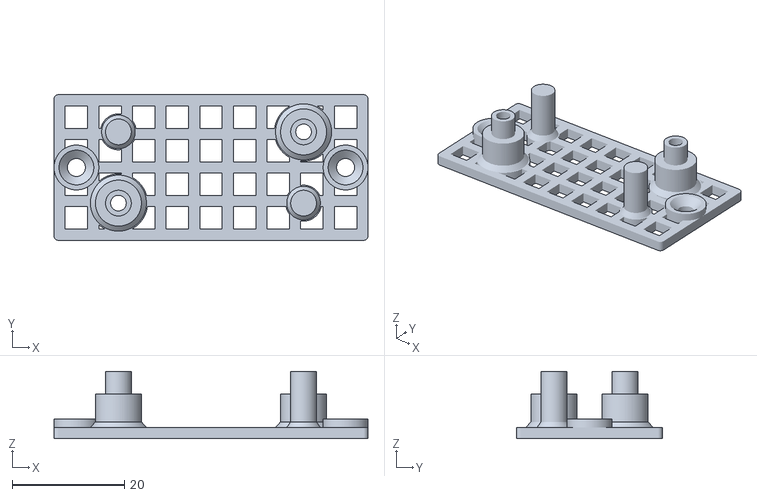
[picture p26: CAD file, 2026-10-10]
3d-print/mounts/aw9523-mount/aw9523_mount.stl
56.0 x 26.0 x 12.0
