supermadboy/boxbert/3d-print/mounts/feather-window-mount/front_cnc.stl

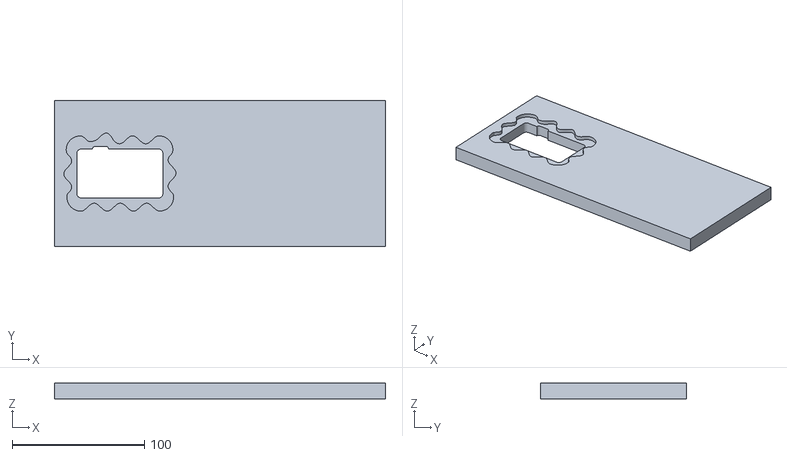
[picture p27: CAD file, 2026-10-21]
3d-print/mounts/feather-window-mount/front_cnc.stl
250.0 x 110.0 x 12.0
