supermadboy/boxbert/3d-print/mounts/neopixel-stick-mount/neopixel_mount.stl

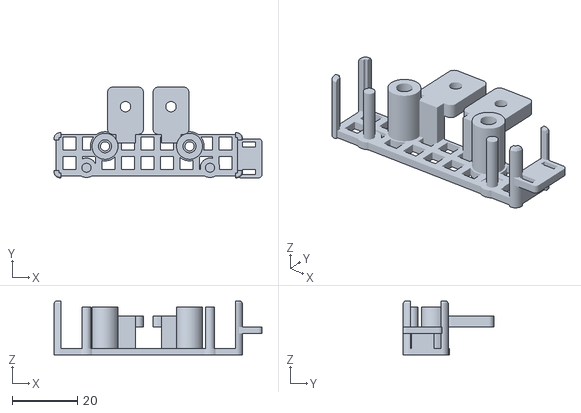
[picture p28: CAD file, 2026-11-07]
3d-print/mounts/neopixel-stick-mount/neopixel_mount.stl
64.0 x 27.9 x 16.5
