supermadboy/boxbert/3d-print/mounts/pn532-mount/logs/photo-exterior/heads_components_control.stl

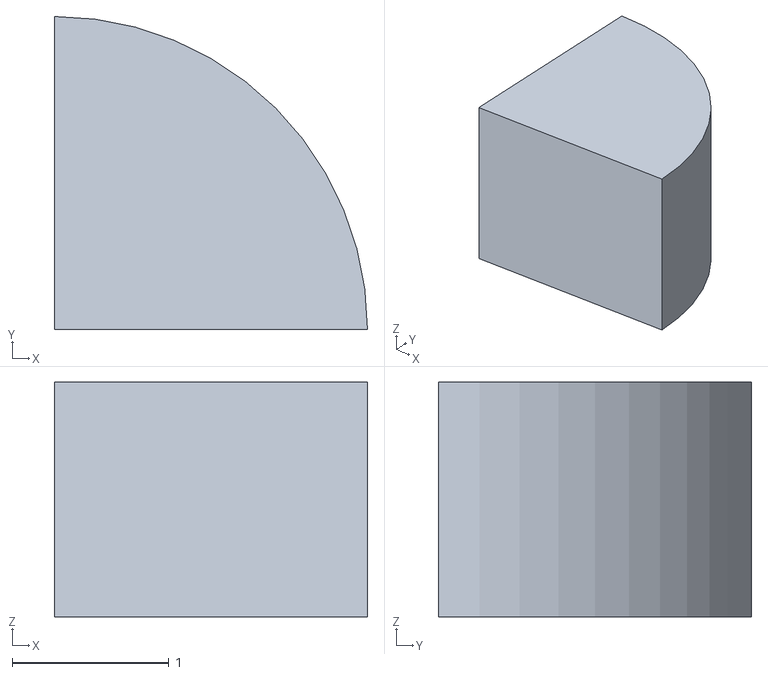
[picture p29: CAD file, 2026-11-10]
3d-print/mounts/pn532-mount/logs/photo-exterior/heads_components_control.stl
2.00 x 2.00 x 1.50
