supermadboy/boxbert/3d-print/mounts/pn532-mount/pn532_mount.stl

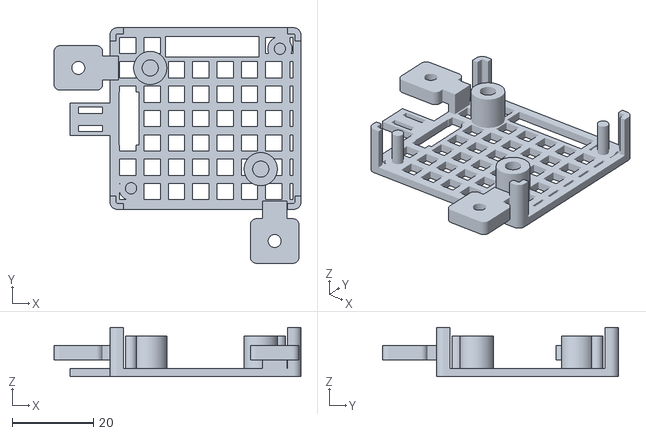
[picture p30: CAD file, 2026-11-10]
3d-print/mounts/pn532-mount/pn532_mount.stl
60.9 x 58.1 x 12.1
