supermadboy/boxbert/3d-print/mounts/sd-mount/sd_mount.stl

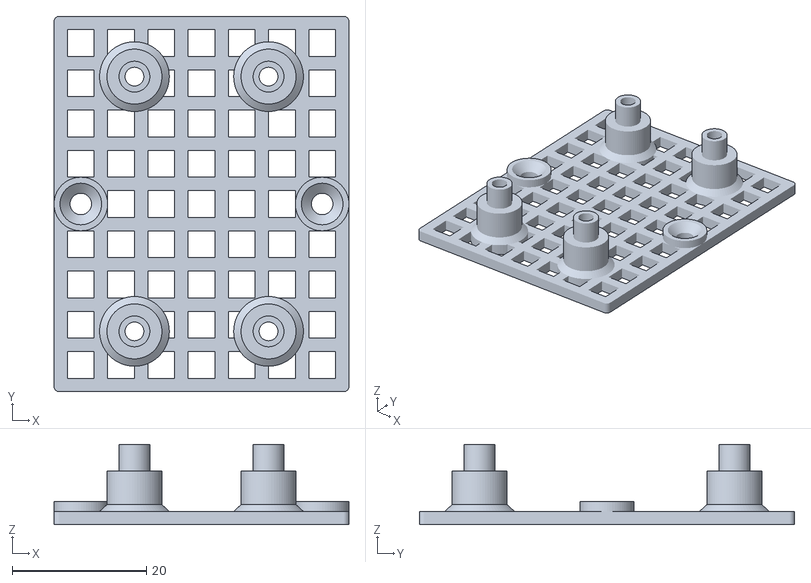
[picture p31: CAD file, 2026-10-16]
3d-print/mounts/sd-mount/sd_mount.stl
44.0 x 56.0 x 12.0
