supermadboy/boxbert/3d-print/mounts/stepup-mount/stepup_mount.stl

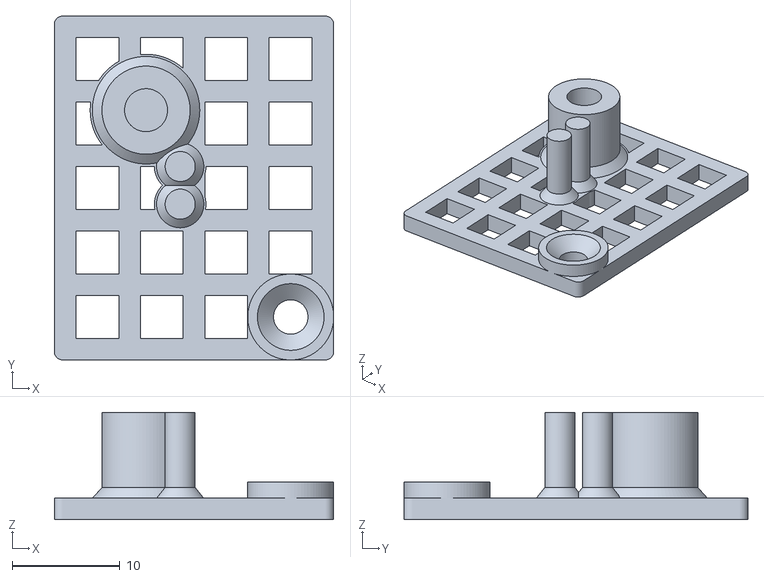
[picture p32: CAD file, 2026-10-10]
3d-print/mounts/stepup-mount/stepup_mount.stl
26.0 x 32.0 x 10.0
