supermadboy/boxbert/3d-print/mounts/akku-mount/akku_bridge.stl

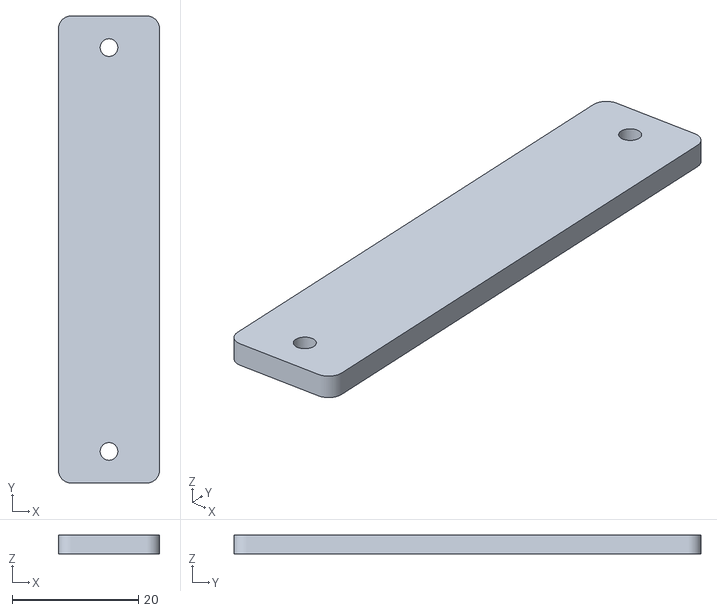
[picture p33: CAD file, 2026-10-10]
3d-print/mounts/akku-mount/akku_bridge.stl
16.0 x 74.0 x 3.00
