supermadboy/boxbert/3d-print/mounts/feather-window-mount/cnc-glass.dxf

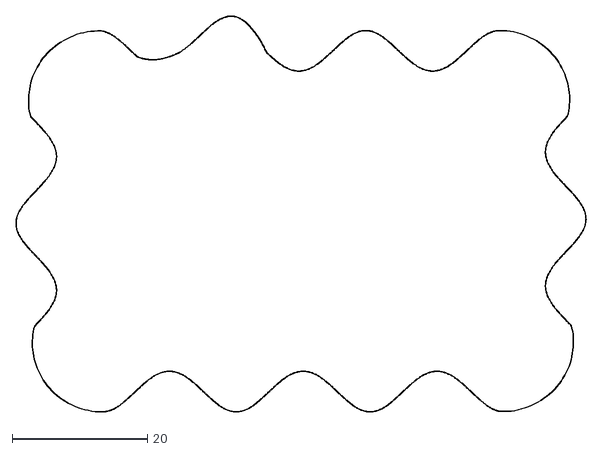
[picture p34: CAD file, 2026-10-21]
3d-print/mounts/feather-window-mount/cnc-glass.dxf
84.4 x 58.6
