supermadboy/boxbert/3d-print/mounts/neopixel-stick-mount/cnc-rebate.dxf

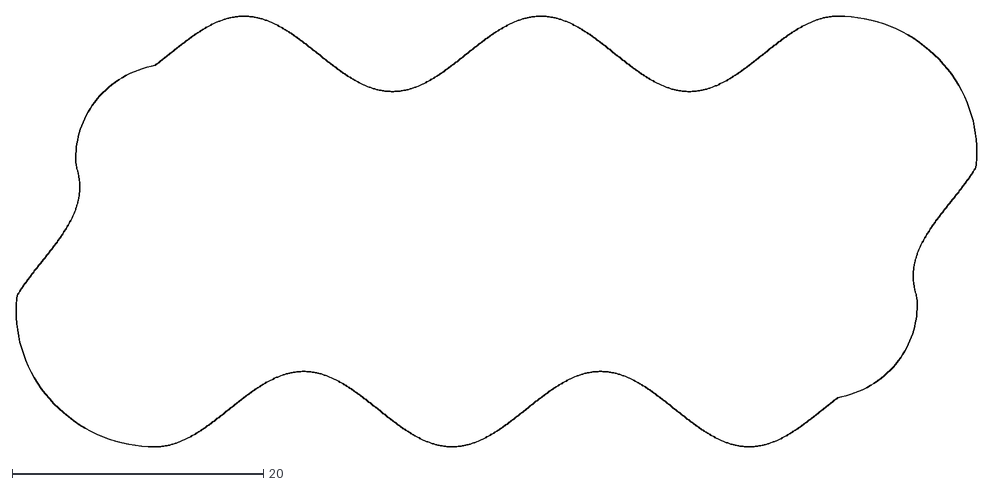
[picture p35: CAD file, 2026-10-21]
3d-print/mounts/neopixel-stick-mount/cnc-rebate.dxf
76.5 x 34.3
