supermadboy/boxbert/3d-print/mounts/pn532-mount/cnc-glass.dxf

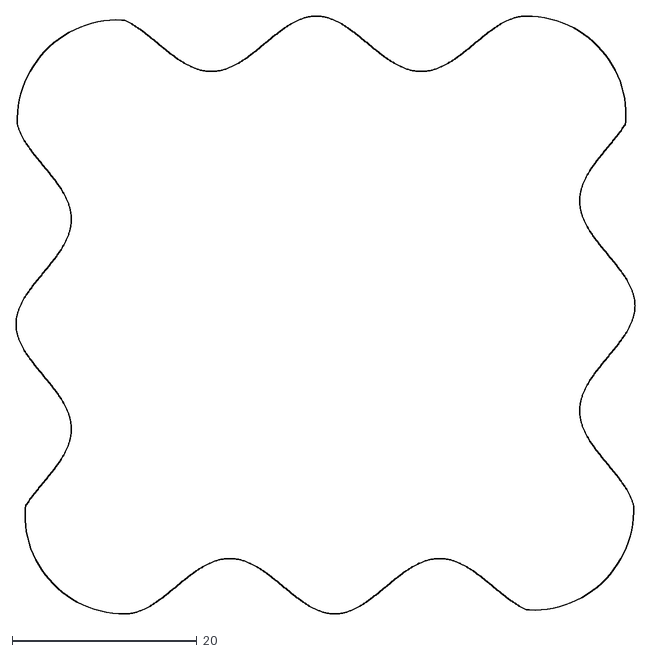
[picture p36: CAD file, 2026-10-21]
3d-print/mounts/pn532-mount/cnc-glass.dxf
67.1 x 64.8
