supermadboy/boxbert/3d-print/mounts/pn532-mount/logs/photo-exterior/bottom_control.stl

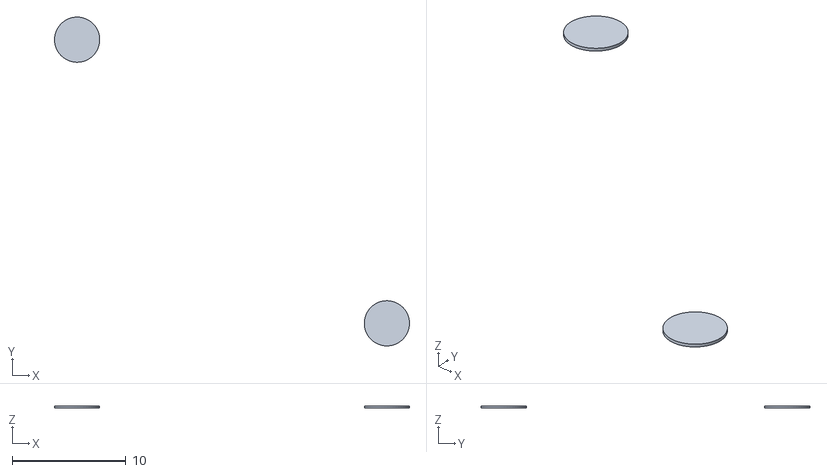
[picture p37: CAD file, 2026-11-10]
3d-print/mounts/pn532-mount/logs/photo-exterior/bottom_control.stl
31.2 x 28.9 x 0.2
