supermadboy/boxbert/3d-print/mounts/sd-mount/hole_template.stl

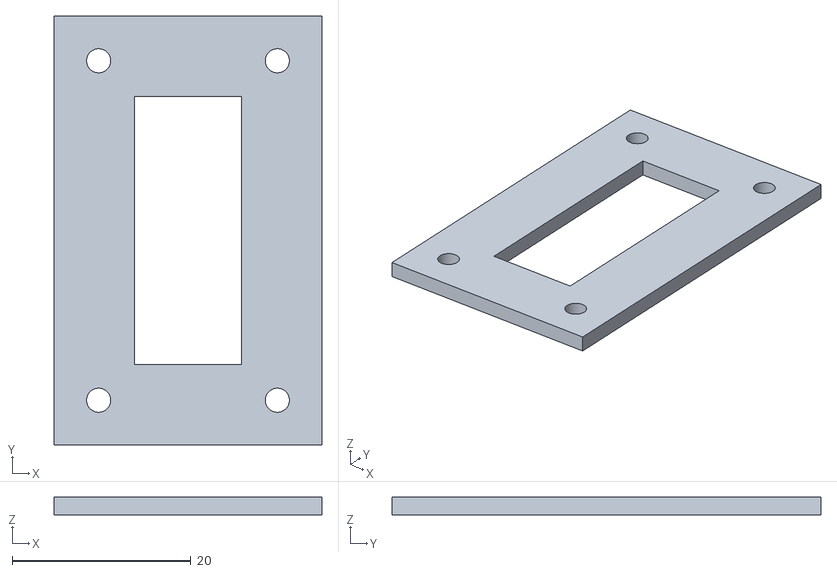
[picture p38: CAD file, 2026-10-10]
3d-print/mounts/sd-mount/hole_template.stl
30.0 x 48.0 x 2.00
