supermadboy/boxbert/3d-print/mounts/feather-window-mount/cnc-rebate.dxf

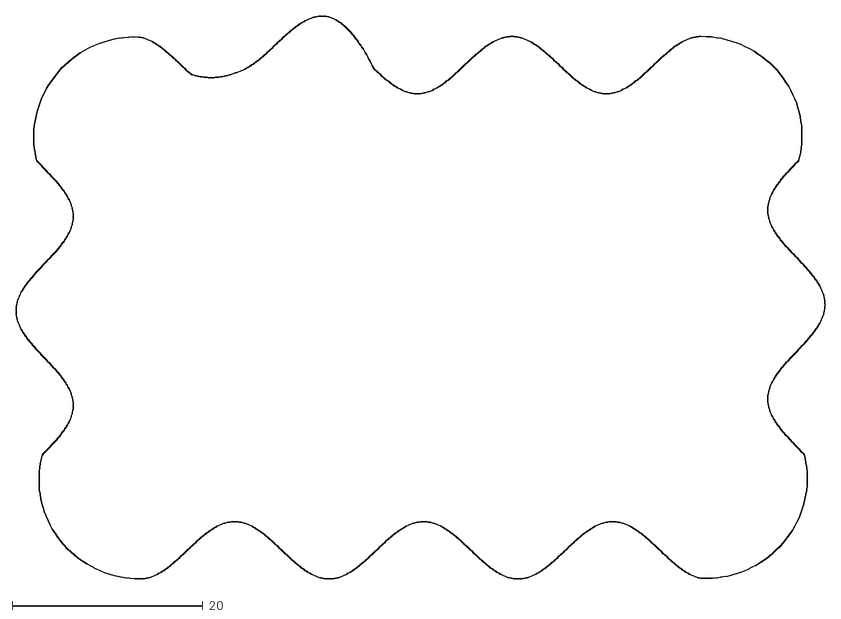
[picture p39: CAD file, 2026-10-21]
3d-print/mounts/feather-window-mount/cnc-rebate.dxf
84.8 x 59.0
