supermadboy/boxbert/3d-print/mounts/neopixel-stick-mount/panel_cnc.stl

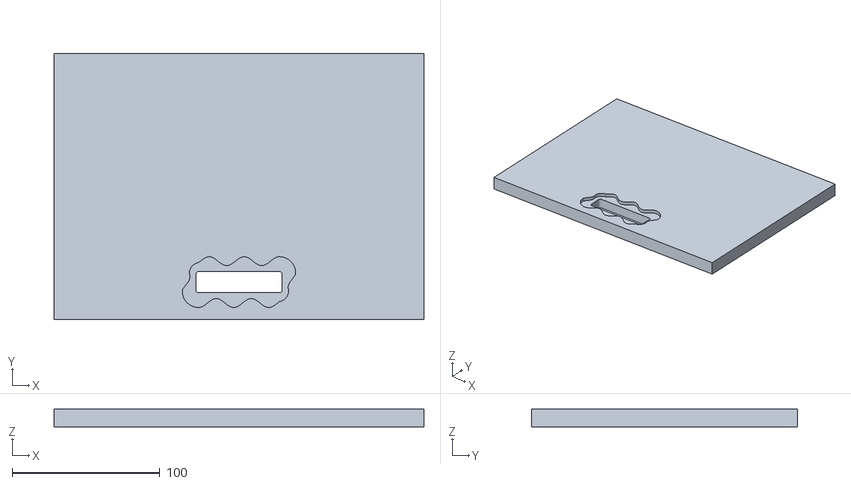
[picture p40: CAD file, 2026-10-21]
3d-print/mounts/neopixel-stick-mount/panel_cnc.stl
250.0 x 180.0 x 12.0
