supermadboy/boxbert/3d-print/mounts/pn532-mount/logs/photo-exterior/electronics_control.stl

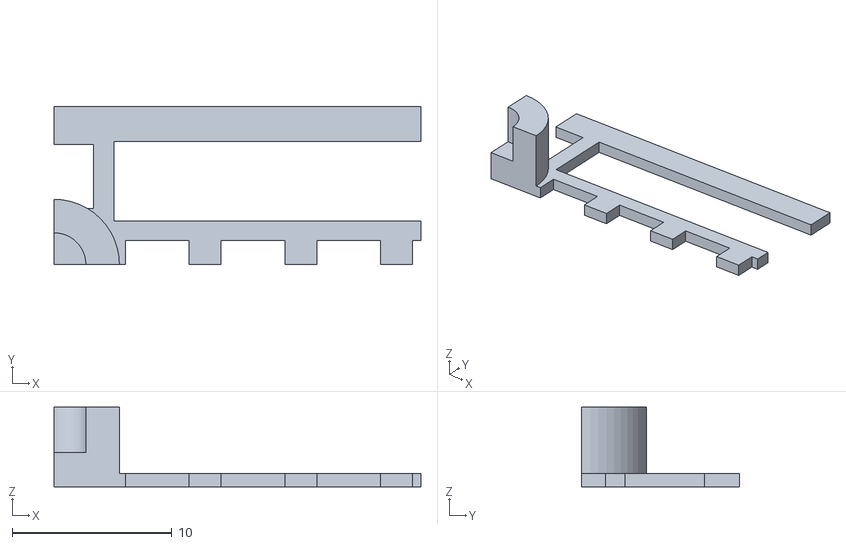
[picture p41: CAD file, 2026-11-10]
3d-print/mounts/pn532-mount/logs/photo-exterior/electronics_control.stl
23.0 x 9.92 x 5.00
