supermadboy/boxbert/3d-print/mounts/pn532-mount/panel_cnc.stl

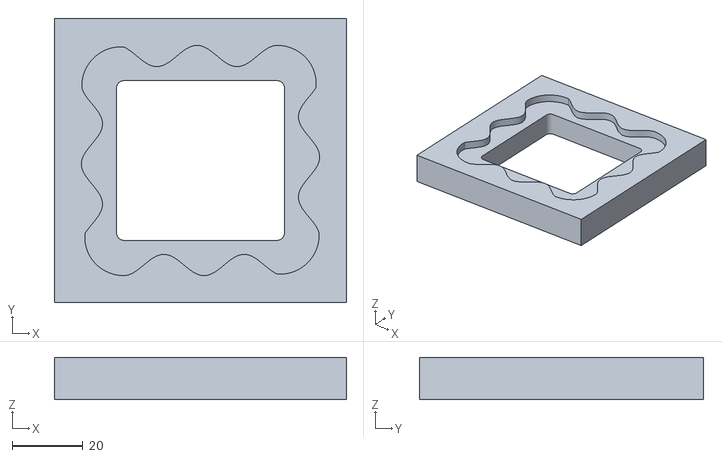
[picture p42: CAD file, 2026-10-21]
3d-print/mounts/pn532-mount/panel_cnc.stl
82.7 x 80.4 x 12.0
