supermadboy/boxbert/3d-print/mounts/feather-window-mount/cnc-opening.dxf

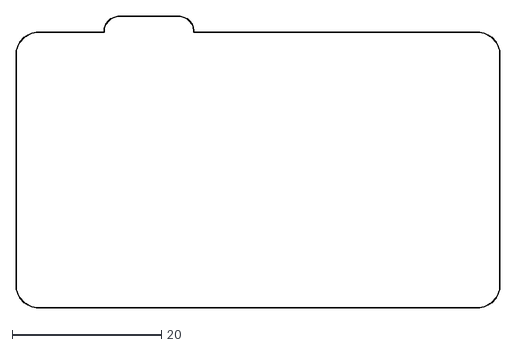
[picture p43: CAD file, 2026-10-15]
3d-print/mounts/feather-window-mount/cnc-opening.dxf
64.8 x 39.0
