supermadboy/boxbert/3d-print/mounts/neopixel-stick-mount/cnc-glass.dxf

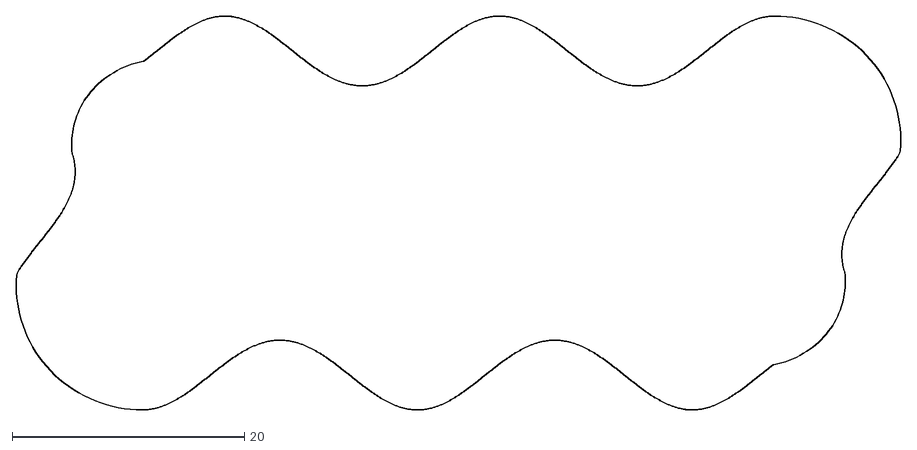
[picture p44: CAD file, 2026-10-21]
3d-print/mounts/neopixel-stick-mount/cnc-glass.dxf
76.1 x 33.9
