supermadboy/boxbert/3d-print/mounts/pn532-mount/cnc-rebate.dxf

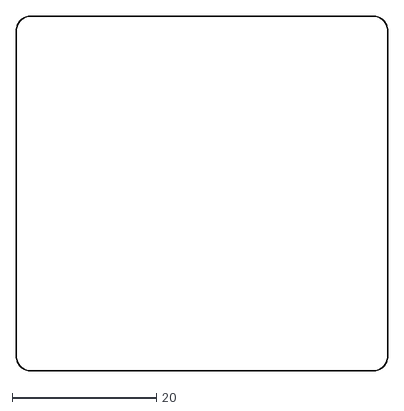
[picture p45: CAD file, 2026-10-15]
3d-print/mounts/pn532-mount/cnc-rebate.dxf
51.5 x 49.2
