supermadboy/boxbert/3d-print/mounts/pn532-mount/logs/photo-exterior/front_occlusion_control.stl

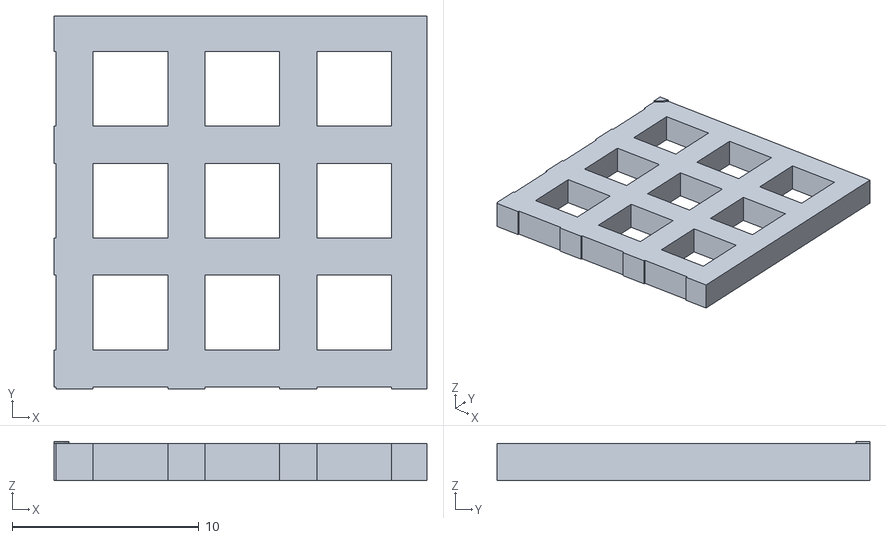
[picture p46: CAD file, 2026-11-10]
3d-print/mounts/pn532-mount/logs/photo-exterior/front_occlusion_control.stl
20.0 x 20.0 x 2.10
