supermadboy/boxbert/3d-print/mounts/feather-window-mount/feather_window_mount.stl

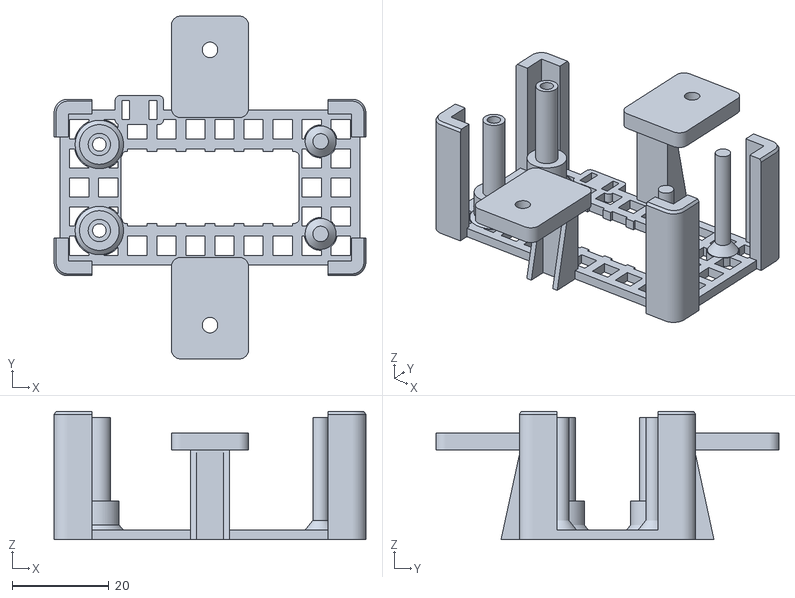
[picture p47: CAD file, 2026-10-15]
3d-print/mounts/feather-window-mount/feather_window_mount.stl
64.4 x 70.9 x 26.5
