supermadboy/boxbert/3d-print/mounts/neopixel-stick-mount/cnc-opening.dxf

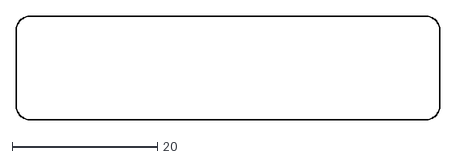
[picture p48: CAD file, 2026-10-21]
3d-print/mounts/neopixel-stick-mount/cnc-opening.dxf
58.4 x 14.3
