supermadboy/boxbert/3d-print/mounts/pn532-mount/logs/photo-exterior/collision_panel.stl

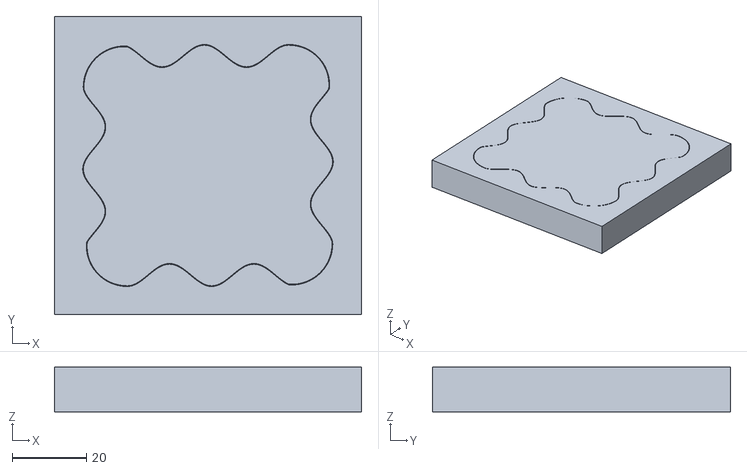
[picture p49: CAD file, 2026-11-10]
3d-print/mounts/pn532-mount/logs/photo-exterior/collision_panel.stl
82.7 x 80.4 x 12.0
