supermadboy/boxbert/3d-print/mounts/pn532-mount/logs/photo-exterior/cnc-opening.dxf

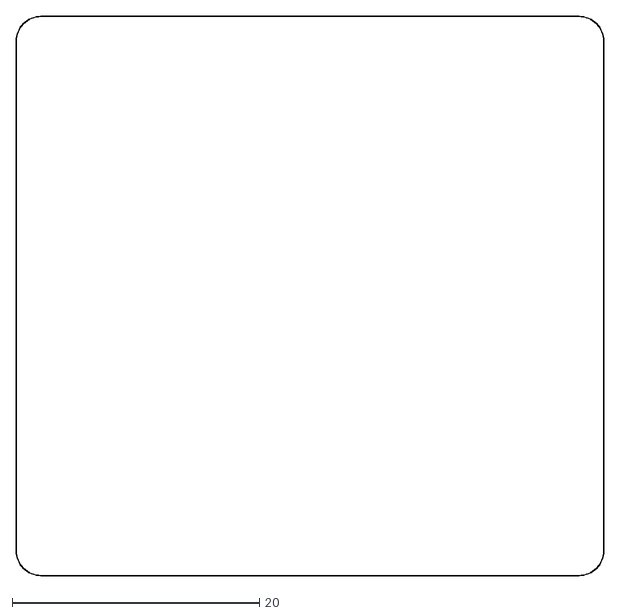
[picture p50: CAD file, 2026-11-10]
3d-print/mounts/pn532-mount/logs/photo-exterior/cnc-opening.dxf
47.5 x 45.2
