supermadboy/boxbert/3d-print/mounts/pn532-mount/logs/photo-exterior/original_gap_control.stl

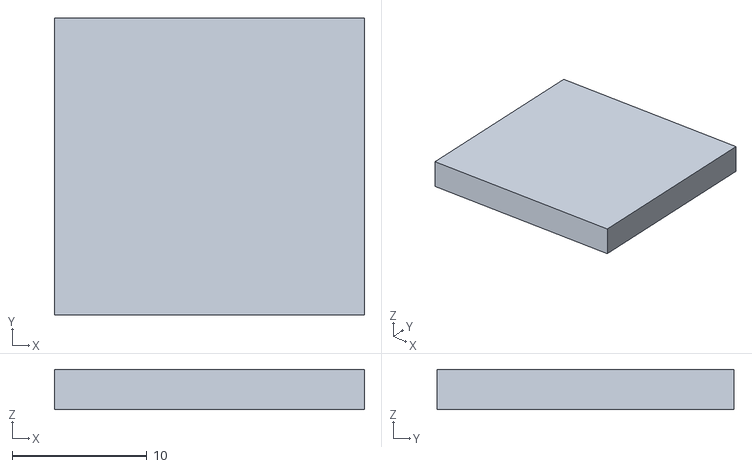
[picture p51: CAD file, 2026-11-10]
3d-print/mounts/pn532-mount/logs/photo-exterior/original_gap_control.stl
23.0 x 22.0 x 3.00
