supermadboy/boxbert/3d-print/mounts/pn532-mount/logs/photo-exterior/cnc-rebate.dxf

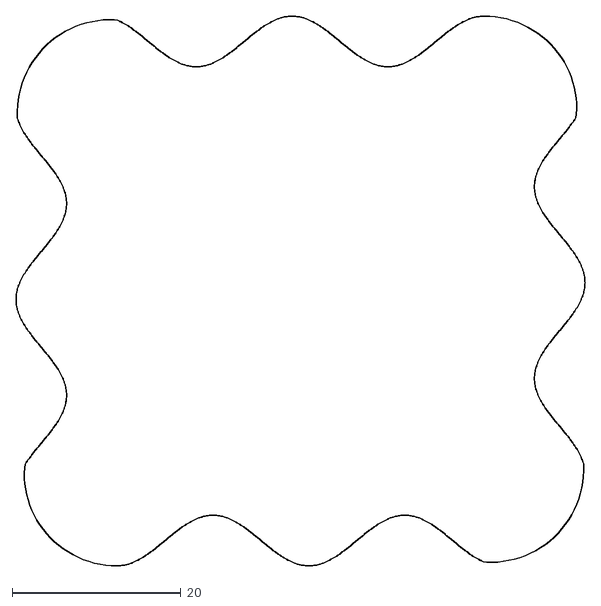
[picture p52: CAD file, 2026-11-10]
3d-print/mounts/pn532-mount/logs/photo-exterior/cnc-rebate.dxf
67.5 x 65.2
