supermadboy/boxbert/3d-print/mounts/pn532-mount/logs/photo-exterior/shift_control.stl

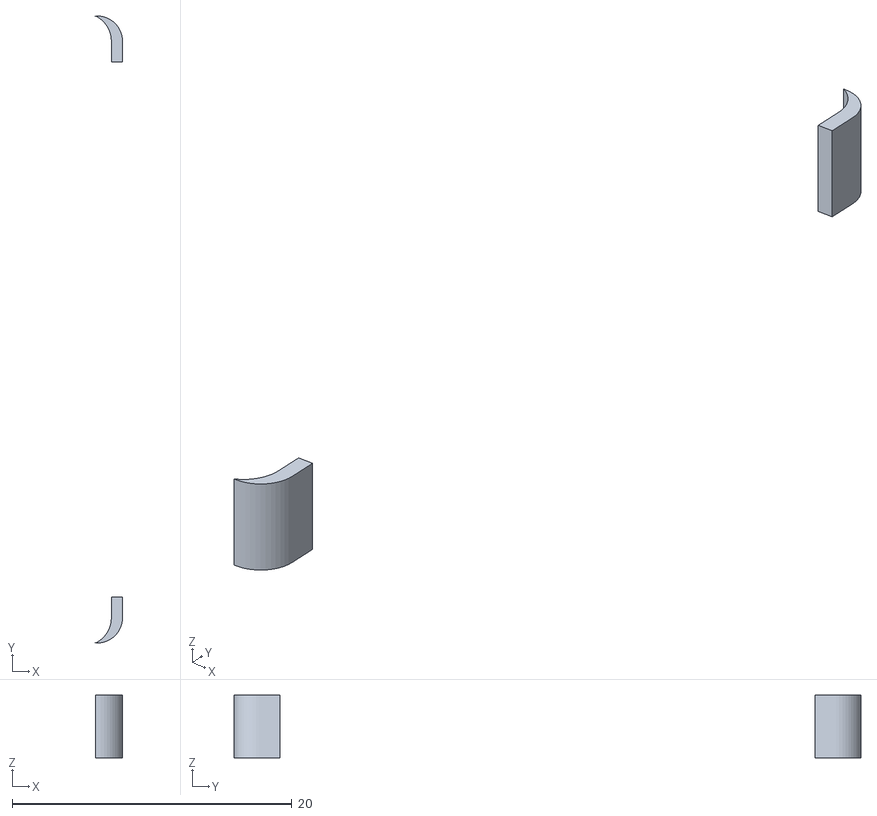
[picture p53: CAD file, 2026-11-10]
3d-print/mounts/pn532-mount/logs/photo-exterior/shift_control.stl
1.93 x 44.8 x 4.50
