supermadboy/boxbert/3d-print/mounts/pn532-mount/logs/photo-exterior/depth_control.stl

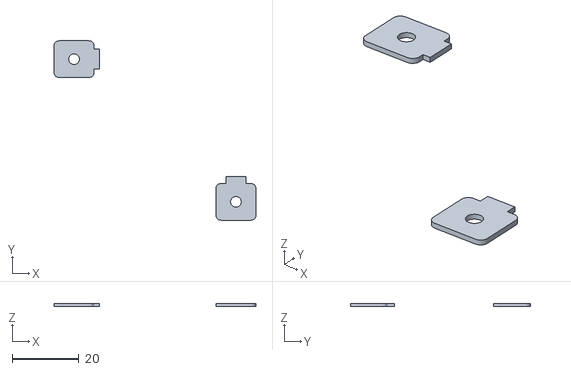
[picture p54: CAD file, 2026-11-10]
3d-print/mounts/pn532-mount/logs/photo-exterior/depth_control.stl
60.4 x 53.7 x 0.999
