supermadboy/boxbert/3d-print/mounts/pn532-mount/logs/photo-exterior/heads_tolerance.stl

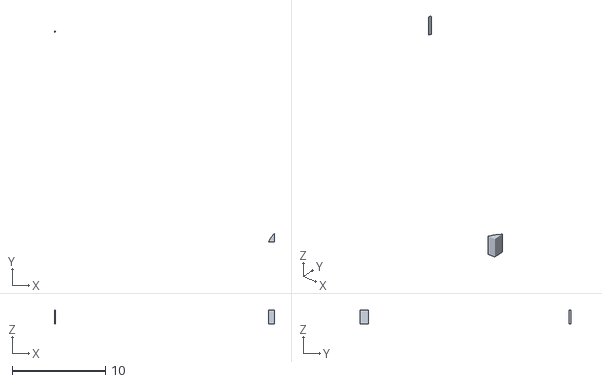
[picture p55: CAD file, 2026-11-10]
3d-print/mounts/pn532-mount/logs/photo-exterior/heads_tolerance.stl
23.6 x 22.6 x 1.50
