supermadboy/boxbert/3d-print/mounts/pn532-mount/logs/photo-exterior/wall_control.stl

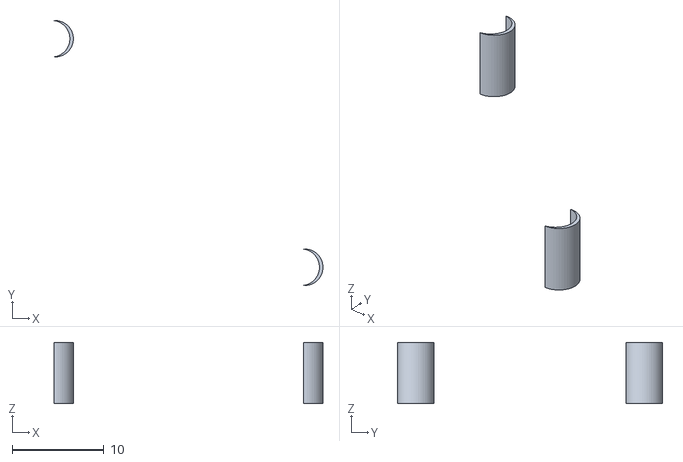
[picture p56: CAD file, 2026-11-10]
3d-print/mounts/pn532-mount/logs/photo-exterior/wall_control.stl
29.4 x 28.9 x 6.69
