supermadboy/boxbert/3d-print/mounts/pn532-mount/logs/photo-exterior/connector_wood_control.stl

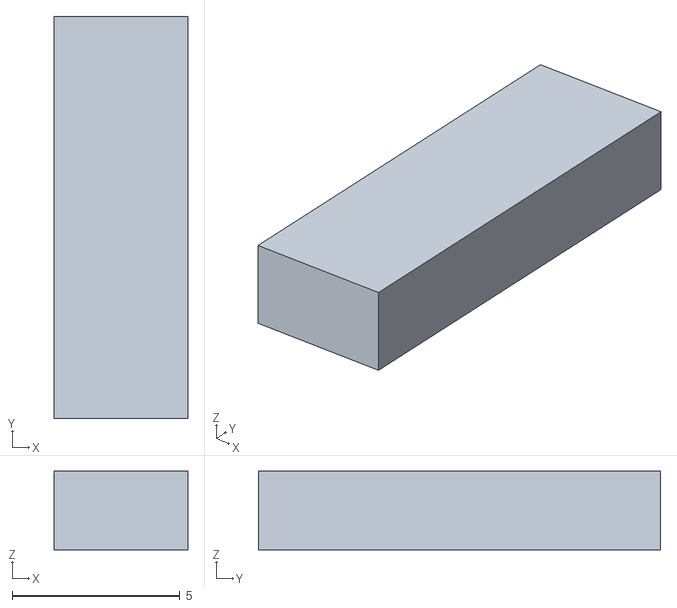
[picture p57: CAD file, 2026-11-10]
3d-print/mounts/pn532-mount/logs/photo-exterior/connector_wood_control.stl
4.00 x 12.0 x 2.35
