supermadboy/boxbert/3d-print/mounts/neopixel-stick-mount/neopixel_mount.scad

include <geometry.scad>
$fn=64;
eps=0.02;
show_board=true;
module grid(){
    linear_extrude(base_h) difference(){
        profile([-1.4,-1.4,pcb_w+2.8,pcb_d+2.8],1.0);
        for(i=[0:8],j=[0:1]) translate([0.8+6*i,0.6+6*j]) square([4,4]); // avoid tangent cell/post edges
    }
}
module guides(){
    intersection(){
        difference(){
            union(){
                linear_extrude(wood_z+guide_h-lead_h) opening_profile(fit);
                hull(){
                    translate([0,0,wood_z+guide_h-lead_h-eps]) linear_extrude(eps) opening_profile(fit);
                    translate([0,0,wood_z+guide_h-eps]) linear_extrude(eps) opening_profile(fit+lead_in);
                }
            }
            translate([0,0,-eps]) linear_extrude(wood_z+guide_h+2*eps) opening_profile(fit+guide_wall);
        }
        for(x=[opening[0],opening[0]+opening[2]-guide_clip])
            for(y=[opening[1],opening[1]+opening[3]-guide_clip]) translate([x,y,0]) cube([guide_clip,guide_clip,wood_z+guide_h]);
    }
}
module screw_post(){
    cylinder(d=9,h=base_h);
    // Full wall up to unchanged PCB underside, required for top-installed inserts.
    cylinder(d=post_d,h=board_z);
}
module support_post(){
    cylinder(d=6,h=base_h);
    cylinder(d=2.8,h=board_z);
}
module mount(){
    difference(){
        union(){
            grid(); guides();
            for(h=board_holes) translate(h) screw_post();
            for(x=[8,46]) translate([x,1.1,0]) support_post();
            for(w=wood_points){
                translate([w[0]-3,pcb_d-1.2,0]) cube([6,3,wood_z]);
                translate([0,0,wood_z-tab_h]) profile_tab(w[0]);
            }
            // User correction: tie pad at opposite short end, local +x.
            translate([pcb_w+0.4,0.5,0]) cube([1,7,8.5]);
            translate([0,0,6.5]) linear_extrude(2) profile([pcb_w+0.4,-2,7.6,12],1);
        }
        for(h=board_holes) translate(h){
            translate([0,0,-eps]) cylinder(d=screw_clear,h=board_z+2*eps);
            // Insert from +z BEFORE PCB mounting, flush at PCB underside.
            translate([0,0,board_z-insert_depth]) cylinder(d=insert_d,h=insert_depth+eps);
        }
        for(w=wood_points) translate([w[0],w[1],wood_z-tab_h-eps]){
            cylinder(d=wood_d,h=tab_h+2*eps);
            cylinder(d1=head_d+2*eps,d2=wood_d,h=(head_d-wood_d)/2+eps);
        }
        for(y=[-1,7.5]) translate([pcb_w+2,y,6.5-eps]) cube([4,1.5,2+2*eps]);
    }
}
module profile_tab(x){linear_extrude(tab_h) profile([x-5.5,pcb_d+1.5,11,14.5],1.5);}
module pcb(){
    translate([0,0,board_z]) linear_extrude(pcb_t) difference(){
        square([pcb_w,pcb_d]);
        for(h=board_holes) translate(h) circle(d=board_hole_d);
    }
}
module leds(){for(p=led_xy) translate([p[0]-2.5,p[1]-2.5,board_z+pcb_t]) cube([5,5,led_h]);}
module caps(){for(p=cap_xy) translate([p[0]-1.65,p[1]-0.8,board_z+pcb_t]) cube([3.3,1.6,1.2]);}
// Head dimensions unmeasured; real user pass test accepted, no fictitious heads.
module screw_heads(){}
module insert_visual(){
    for(h=board_holes) translate([h[0],h[1],board_z-insert_l])
        color([0.85,0.65,0.2]) difference(){
            // Installed knurl envelope: heat displaces plastic, not a cold-fit solid test.
            cylinder(d=insert_max_d,h=insert_l);
            translate([0,0,-eps]) cylinder(d=2.5,h=insert_l+2*eps);
        }
}
module wire_path(y,r=0.95,box=false){
    // Mechanical envelope only: user requests opposite short end (+x).
    // No verified pad/net ordering; check actual DIN and supply labels before soldering.
    // Short outward/down transition, then under wood; actual bend/lot remain unmeasured.
    points=[[pcb_w-1.397,y,board_z-0.85],[pcb_w+0.9,y,9.5],[pcb_w+12,y,9.5]];
    for(i=[0:1]) hull(){
        translate(points[i]) if(box) cube([2*r,2*r,2*r],center=true); else sphere(r=r,$fn=24);
        translate(points[i+1]) if(box) cube([2*r,2*r,2*r],center=true); else sphere(r=r,$fn=24);
    }
}
// Conservative square swept envelopes enclose the visual round wires and are
// dramatically cheaper for CGAL insertion unions; no collision test is skipped.
module cables(){for(y=[1.27,3.81,6.35]) wire_path(y,0.95,true);}
module cable_visual(){
    for(y=[1.27,3.81,6.35]) color(y<2?"black":y<5?"dodgerblue":"red") wire_path(y,0.75);
}
module visible_pcb(){
    color([0.1,0.5,0.3,0.45]) translate([0,0,0.03]) pcb();
    color([1,1,0.75]) leds();
    color([0.55,0.35,0.12]) caps();
    insert_visual();
    cable_visual();
}
color([0.96,0.46,0.13]) mount();
if($preview && show_board) visible_pcb();
echo("Measured PCB/hole geometry 21.10.2026; component XY and cable envelopes assumed; top-entry RX-M2.5x5.7, M2.5x12; PCB bottom",board_z,"LED/glass gap",optical_gap);
