supermadboy/boxbert/3d-print/mounts/pn532-mount/wave-preview/wave-points.scad

// Generated by generate.py; dimensions in mm.
wave_points=[
[-0.400000,-12.400000],
[-0.286271,-12.398520],
[-0.172542,-12.394080],
[-0.058813,-12.386686],
[0.054916,-12.376344],
[0.168645,-12.363065],
[0.282374,-12.346862],
[0.396103,-12.327750],
[0.509832,-12.305749],
[0.623561,-12.280881],
[0.737290,-12.253170],
[0.851019,-12.222642],
[0.964748,-12.189329],
[1.078477,-12.153264],
[1.192206,-12.114481],
[1.305935,-12.073020],
[1.419664,-12.028920],
[1.533393,-11.982226],
[1.647122,-11.932984],
[1.760851,-11.881242],
[1.874580,-11.827051],
[1.988309,-11.770465],
[2.102038,-11.711540],
[2.215767,-11.650333],
[2.329496,-11.586906],
[2.443225,-11.521320],
[2.556954,-11.453641],
[2.670683,-11.383936],
[2.784411,-11.312272],
[2.898140,-11.238721],
[3.011869,-11.163356],
[3.125598,-11.086250],
[3.239327,-11.007480],
[3.353056,-10.927124],
[3.466785,-10.845261],
[3.580514,-10.761971],
[3.694243,-10.677338],
[3.807972,-10.591444],
[3.921701,-10.504374],
[4.035430,-10.416214],
[4.149159,-10.327051],
[4.262888,-10.236973],
[4.376617,-10.146070],
[4.490346,-10.054430],
[4.604075,-9.962144],
[4.717804,-9.869303],
[4.831533,-9.776000],
[4.945262,-9.682325],
[5.058991,-9.588372],
[5.172720,-9.494232],
[5.286449,-9.400000],
[5.400178,-9.305768],
[5.513907,-9.211628],
[5.627636,-9.117675],
[5.741365,-9.024000],
[5.855094,-8.930697],
[5.968823,-8.837856],
[6.082552,-8.745570],
[6.196281,-8.653930],
[6.310010,-8.563027],
[6.423739,-8.472949],
[6.537468,-8.383786],
[6.651197,-8.295626],
[6.764926,-8.208556],
[6.878655,-8.122662],
[6.992384,-8.038029],
[7.106113,-7.954739],
[7.219842,-7.872876],
[7.333571,-7.792520],
[7.447300,-7.713750],
[7.561029,-7.636644],
[7.674758,-7.561279],
[7.788487,-7.487728],
[7.902216,-7.416064],
[8.015945,-7.346359],
[8.129674,-7.278680],
[8.243403,-7.213094],
[8.357132,-7.149667],
[8.470861,-7.088460],
[8.584590,-7.029535],
[8.698319,-6.972949],
[8.812048,-6.918758],
[8.925776,-6.867016],
[9.039505,-6.817774],
[9.153234,-6.771080],
[9.266963,-6.726980],
[9.380692,-6.685519],
[9.494421,-6.646736],
[9.608150,-6.610671],
[9.721879,-6.577358],
[9.835608,-6.546830],
[9.949337,-6.519119],
[10.063066,-6.494251],
[10.176795,-6.472250],
[10.290524,-6.453138],
[10.404253,-6.436935],
[10.517982,-6.423656],
[10.631711,-6.413314],
[10.745440,-6.405920],
[10.859169,-6.401480],
[10.972898,-6.400000],
[11.086627,-6.401480],
[11.200356,-6.405920],
[11.314085,-6.413314],
[11.427814,-6.423656],
[11.541543,-6.436935],
[11.655272,-6.453138],
[11.769001,-6.472250],
[11.882730,-6.494251],
[11.996459,-6.519119],
[12.110188,-6.546830],
[12.223917,-6.577358],
[12.337646,-6.610671],
[12.451375,-6.646736],
[12.565104,-6.685519],
[12.678833,-6.726980],
[12.792562,-6.771080],
[12.906291,-6.817774],
[13.020020,-6.867016],
[13.133749,-6.918758],
[13.247478,-6.972949],
[13.361207,-7.029535],
[13.474936,-7.088460],
[13.588665,-7.149667],
[13.702394,-7.213094],
[13.816123,-7.278680],
[13.929852,-7.346359],
[14.043581,-7.416064],
[14.157310,-7.487728],
[14.271039,-7.561279],
[14.384768,-7.636644],
[14.498497,-7.713750],
[14.612226,-7.792520],
[14.725955,-7.872876],
[14.839684,-7.954739],
[14.953413,-8.038029],
[15.067142,-8.122662],
[15.180870,-8.208556],
[15.294599,-8.295626],
[15.408328,-8.383786],
[15.522057,-8.472949],
[15.635786,-8.563027],
[15.749515,-8.653930],
[15.863244,-8.745570],
[15.976973,-8.837856],
[16.090702,-8.930697],
[16.204431,-9.024000],
[16.318160,-9.117675],
[16.431889,-9.211628],
[16.545618,-9.305768],
[16.659347,-9.400000],
[16.773076,-9.494232],
[16.886805,-9.588372],
[17.000534,-9.682325],
[17.114263,-9.776000],
[17.227992,-9.869303],
[17.341721,-9.962144],
[17.455450,-10.054430],
[17.569179,-10.146070],
[17.682908,-10.236973],
[17.796637,-10.327051],
[17.910366,-10.416214],
[18.024095,-10.504374],
[18.137824,-10.591444],
[18.251553,-10.677338],
[18.365282,-10.761971],
[18.479011,-10.845261],
[18.592740,-10.927124],
[18.706469,-11.007480],
[18.820198,-11.086250],
[18.933927,-11.163356],
[19.047656,-11.238721],
[19.161385,-11.312272],
[19.275114,-11.383936],
[19.388843,-11.453641],
[19.502572,-11.521320],
[19.616301,-11.586906],
[19.730030,-11.650333],
[19.843759,-11.711540],
[19.957488,-11.770465],
[20.071217,-11.827051],
[20.184946,-11.881242],
[20.298675,-11.932984],
[20.412404,-11.982226],
[20.526133,-12.028920],
[20.639862,-12.073020],
[20.753591,-12.114481],
[20.867320,-12.153264],
[20.981049,-12.189329],
[21.094778,-12.222642],
[21.208507,-12.253170],
[21.322235,-12.280881],
[21.435964,-12.305749],
[21.549693,-12.327750],
[21.663422,-12.346862],
[21.777151,-12.363065],
[21.890880,-12.376344],
[22.004609,-12.386686],
[22.118338,-12.394080],
[22.232067,-12.398520],
[22.345796,-12.400000],
[22.459525,-12.398520],
[22.573254,-12.394080],
[22.686983,-12.386686],
[22.800712,-12.376344],
[22.914441,-12.363065],
[23.028170,-12.346862],
[23.141899,-12.327750],
[23.255628,-12.305749],
[23.369357,-12.280881],
[23.483086,-12.253170],
[23.596815,-12.222642],
[23.710544,-12.189329],
[23.824273,-12.153264],
[23.938002,-12.114481],
[24.051731,-12.073020],
[24.165460,-12.028920],
[24.279189,-11.982226],
[24.392918,-11.932984],
[24.506647,-11.881242],
[24.620376,-11.827051],
[24.734105,-11.770465],
[24.847834,-11.711540],
[24.961563,-11.650333],
[25.075292,-11.586906],
[25.189021,-11.521320],
[25.302750,-11.453641],
[25.416479,-11.383936],
[25.530208,-11.312272],
[25.643937,-11.238721],
[25.757666,-11.163356],
[25.871395,-11.086250],
[25.985124,-11.007480],
[26.098853,-10.927124],
[26.212582,-10.845261],
[26.326311,-10.761971],
[26.440040,-10.677338],
[26.553769,-10.591444],
[26.667498,-10.504374],
[26.781227,-10.416214],
[26.894956,-10.327051],
[27.008685,-10.236973],
[27.122414,-10.146070],
[27.236143,-10.054430],
[27.349872,-9.962144],
[27.463601,-9.869303],
[27.577329,-9.776000],
[27.691058,-9.682325],
[27.804787,-9.588372],
[27.918516,-9.494232],
[28.032245,-9.400000],
[28.145974,-9.305768],
[28.259703,-9.211628],
[28.373432,-9.117675],
[28.487161,-9.024000],
[28.600890,-8.930697],
[28.714619,-8.837856],
[28.828348,-8.745570],
[28.942077,-8.653930],
[29.055806,-8.563027],
[29.169535,-8.472949],
[29.283264,-8.383786],
[29.396993,-8.295626],
[29.510722,-8.208556],
[29.624451,-8.122662],
[29.738180,-8.038029],
[29.851909,-7.954739],
[29.965638,-7.872876],
[30.079367,-7.792520],
[30.193096,-7.713750],
[30.306825,-7.636644],
[30.420554,-7.561279],
[30.534283,-7.487728],
[30.648012,-7.416064],
[30.761741,-7.346359],
[30.875470,-7.278680],
[30.989199,-7.213094],
[31.102928,-7.149667],
[31.216657,-7.088460],
[31.330386,-7.029535],
[31.444115,-6.972949],
[31.557844,-6.918758],
[31.671573,-6.867016],
[31.785302,-6.817774],
[31.899031,-6.771080],
[32.012760,-6.726980],
[32.126489,-6.685519],
[32.240218,-6.646736],
[32.353947,-6.610671],
[32.467676,-6.577358],
[32.581405,-6.546830],
[32.695134,-6.519119],
[32.808863,-6.494251],
[32.922592,-6.472250],
[33.036321,-6.453138],
[33.150050,-6.436935],
[33.263779,-6.423656],
[33.377508,-6.413314],
[33.491237,-6.405920],
[33.604966,-6.401480],
[33.718694,-6.400000],
[33.832423,-6.401480],
[33.946152,-6.405920],
[34.059881,-6.413314],
[34.173610,-6.423656],
[34.287339,-6.436935],
[34.401068,-6.453138],
[34.514797,-6.472250],
[34.628526,-6.494251],
[34.742255,-6.519119],
[34.855984,-6.546830],
[34.969713,-6.577358],
[35.083442,-6.610671],
[35.197171,-6.646736],
[35.310900,-6.685519],
[35.424629,-6.726980],
[35.538358,-6.771080],
[35.652087,-6.817774],
[35.765816,-6.867016],
[35.879545,-6.918758],
[35.993274,-6.972949],
[36.107003,-7.029535],
[36.220732,-7.088460],
[36.334461,-7.149667],
[36.448190,-7.213094],
[36.561919,-7.278680],
[36.675648,-7.346359],
[36.789377,-7.416064],
[36.903106,-7.487728],
[37.016835,-7.561279],
[37.130564,-7.636644],
[37.244293,-7.713750],
[37.358022,-7.792520],
[37.471751,-7.872876],
[37.585480,-7.954739],
[37.699209,-8.038029],
[37.812938,-8.122662],
[37.926667,-8.208556],
[38.040396,-8.295626],
[38.154125,-8.383786],
[38.267854,-8.472949],
[38.381583,-8.563027],
[38.495312,-8.653930],
[38.609041,-8.745570],
[38.722770,-8.837856],
[38.836499,-8.930697],
[38.950228,-9.024000],
[39.063957,-9.117675],
[39.177686,-9.211628],
[39.291415,-9.305768],
[39.405144,-9.400000],
[39.518873,-9.494232],
[39.632602,-9.588372],
[39.746331,-9.682325],
[39.860059,-9.776000],
[39.973788,-9.869303],
[40.087517,-9.962144],
[40.201246,-10.054430],
[40.314975,-10.146070],
[40.428704,-10.236973],
[40.542433,-10.327051],
[40.656162,-10.416214],
[40.769891,-10.504374],
[40.883620,-10.591444],
[40.997349,-10.677338],
[41.111078,-10.761971],
[41.224807,-10.845261],
[41.338536,-10.927124],
[41.452265,-11.007480],
[41.565994,-11.086250],
[41.679723,-11.163356],
[41.793452,-11.238721],
[41.907181,-11.312272],
[42.020910,-11.383936],
[42.134639,-11.453641],
[42.248368,-11.521320],
[42.362097,-11.586906],
[42.475826,-11.650333],
[42.589555,-11.711540],
[42.703284,-11.770465],
[42.817013,-11.827051],
[42.930742,-11.881242],
[43.044471,-11.932984],
[43.436995,-11.977322],
[44.098443,-11.985978],
[44.761582,-11.954156],
[45.423789,-11.881684],
[46.082422,-11.768569],
[46.734841,-11.615000],
[47.378412,-11.421346],
[48.010529,-11.188157],
[48.628620,-10.916164],
[49.230162,-10.606272],
[49.812697,-10.259560],
[50.373840,-9.877276],
[50.911293,-9.460829],
[51.422857,-9.011787],
[51.906443,-8.531863],
[52.360083,-8.022914],
[52.781937,-7.486929],
[53.170308,-6.926017],
[53.523643,-6.342402],
[53.840549,-5.738405],
[54.119793,-5.116440],
[54.360311,-4.478997],
[54.561213,-3.828631],
[54.721788,-3.167950],
[54.841503,-2.499601],
[54.920011,-1.826257],
[54.957147,-1.150604],
[54.952930,-0.475327],
[54.922642,-0.298981],
[54.889329,-0.185252],
[54.853264,-0.071523],
[54.814481,0.042206],
[54.773020,0.155935],
[54.728920,0.269664],
[54.682226,0.383393],
[54.632984,0.497122],
[54.581242,0.610851],
[54.527051,0.724580],
[54.470465,0.838309],
[54.411540,0.952038],
[54.350333,1.065767],
[54.286906,1.179496],
[54.221320,1.293225],
[54.153641,1.406954],
[54.083936,1.520683],
[54.012272,1.634411],
[53.938721,1.748140],
[53.863356,1.861869],
[53.786250,1.975598],
[53.707480,2.089327],
[53.627124,2.203056],
[53.545261,2.316785],
[53.461971,2.430514],
[53.377338,2.544243],
[53.291444,2.657972],
[53.204374,2.771701],
[53.116214,2.885430],
[53.027051,2.999159],
[52.936973,3.112888],
[52.846070,3.226617],
[52.754430,3.340346],
[52.662144,3.454075],
[52.569303,3.567804],
[52.476000,3.681533],
[52.382325,3.795262],
[52.288372,3.908991],
[52.194232,4.022720],
[52.100000,4.136449],
[52.005768,4.250178],
[51.911628,4.363907],
[51.817675,4.477636],
[51.724000,4.591365],
[51.630697,4.705094],
[51.537856,4.818823],
[51.445570,4.932552],
[51.353930,5.046281],
[51.263027,5.160010],
[51.172949,5.273739],
[51.083786,5.387468],
[50.995626,5.501197],
[50.908556,5.614926],
[50.822662,5.728655],
[50.738029,5.842384],
[50.654739,5.956113],
[50.572876,6.069842],
[50.492520,6.183571],
[50.413750,6.297300],
[50.336644,6.411029],
[50.261279,6.524758],
[50.187728,6.638487],
[50.116064,6.752216],
[50.046359,6.865945],
[49.978680,6.979674],
[49.913094,7.093403],
[49.849667,7.207132],
[49.788460,7.320861],
[49.729535,7.434590],
[49.672949,7.548319],
[49.618758,7.662048],
[49.567016,7.775776],
[49.517774,7.889505],
[49.471080,8.003234],
[49.426980,8.116963],
[49.385519,8.230692],
[49.346736,8.344421],
[49.310671,8.458150],
[49.277358,8.571879],
[49.246830,8.685608],
[49.219119,8.799337],
[49.194251,8.913066],
[49.172250,9.026795],
[49.153138,9.140524],
[49.136935,9.254253],
[49.123656,9.367982],
[49.113314,9.481711],
[49.105920,9.595440],
[49.101480,9.709169],
[49.100000,9.822898],
[49.101480,9.936627],
[49.105920,10.050356],
[49.113314,10.164085],
[49.123656,10.277814],
[49.136935,10.391543],
[49.153138,10.505272],
[49.172250,10.619001],
[49.194251,10.732730],
[49.219119,10.846459],
[49.246830,10.960188],
[49.277358,11.073917],
[49.310671,11.187646],
[49.346736,11.301375],
[49.385519,11.415104],
[49.426980,11.528833],
[49.471080,11.642562],
[49.517774,11.756291],
[49.567016,11.870020],
[49.618758,11.983749],
[49.672949,12.097478],
[49.729535,12.211207],
[49.788460,12.324936],
[49.849667,12.438665],
[49.913094,12.552394],
[49.978680,12.666123],
[50.046359,12.779852],
[50.116064,12.893581],
[50.187728,13.007310],
[50.261279,13.121039],
[50.336644,13.234768],
[50.413750,13.348497],
[50.492520,13.462226],
[50.572876,13.575955],
[50.654739,13.689684],
[50.738029,13.803413],
[50.822662,13.917142],
[50.908556,14.030870],
[50.995626,14.144599],
[51.083786,14.258328],
[51.172949,14.372057],
[51.263027,14.485786],
[51.353930,14.599515],
[51.445570,14.713244],
[51.537856,14.826973],
[51.630697,14.940702],
[51.724000,15.054431],
[51.817675,15.168160],
[51.911628,15.281889],
[52.005768,15.395618],
[52.100000,15.509347],
[52.194232,15.623076],
[52.288372,15.736805],
[52.382325,15.850534],
[52.476000,15.964263],
[52.569303,16.077992],
[52.662144,16.191721],
[52.754430,16.305450],
[52.846070,16.419179],
[52.936973,16.532908],
[53.027051,16.646637],
[53.116214,16.760366],
[53.204374,16.874095],
[53.291444,16.987824],
[53.377338,17.101553],
[53.461971,17.215282],
[53.545261,17.329011],
[53.627124,17.442740],
[53.707480,17.556469],
[53.786250,17.670198],
[53.863356,17.783927],
[53.938721,17.897656],
[54.012272,18.011385],
[54.083936,18.125114],
[54.153641,18.238843],
[54.221320,18.352572],
[54.286906,18.466301],
[54.350333,18.580030],
[54.411540,18.693759],
[54.470465,18.807488],
[54.527051,18.921217],
[54.581242,19.034946],
[54.632984,19.148675],
[54.682226,19.262404],
[54.728920,19.376133],
[54.773020,19.489862],
[54.814481,19.603591],
[54.853264,19.717320],
[54.889329,19.831049],
[54.922642,19.944778],
[54.953170,20.058507],
[54.980881,20.172235],
[55.005749,20.285964],
[55.027750,20.399693],
[55.046862,20.513422],
[55.063065,20.627151],
[55.076344,20.740880],
[55.086686,20.854609],
[55.094080,20.968338],
[55.098520,21.082067],
[55.100000,21.195796],
[55.098520,21.309525],
[55.094080,21.423254],
[55.086686,21.536983],
[55.076344,21.650712],
[55.063065,21.764441],
[55.046862,21.878170],
[55.027750,21.991899],
[55.005749,22.105628],
[54.980881,22.219357],
[54.953170,22.333086],
[54.922642,22.446815],
[54.889329,22.560544],
[54.853264,22.674273],
[54.814481,22.788002],
[54.773020,22.901731],
[54.728920,23.015460],
[54.682226,23.129189],
[54.632984,23.242918],
[54.581242,23.356647],
[54.527051,23.470376],
[54.470465,23.584105],
[54.411540,23.697834],
[54.350333,23.811563],
[54.286906,23.925292],
[54.221320,24.039021],
[54.153641,24.152750],
[54.083936,24.266479],
[54.012272,24.380208],
[53.938721,24.493937],
[53.863356,24.607666],
[53.786250,24.721395],
[53.707480,24.835124],
[53.627124,24.948853],
[53.545261,25.062582],
[53.461971,25.176311],
[53.377338,25.290040],
[53.291444,25.403769],
[53.204374,25.517498],
[53.116214,25.631227],
[53.027051,25.744956],
[52.936973,25.858685],
[52.846070,25.972414],
[52.754430,26.086143],
[52.662144,26.199872],
[52.569303,26.313601],
[52.476000,26.427329],
[52.382325,26.541058],
[52.288372,26.654787],
[52.194232,26.768516],
[52.100000,26.882245],
[52.005768,26.995974],
[51.911628,27.109703],
[51.817675,27.223432],
[51.724000,27.337161],
[51.630697,27.450890],
[51.537856,27.564619],
[51.445570,27.678348],
[51.353930,27.792077],
[51.263027,27.905806],
[51.172949,28.019535],
[51.083786,28.133264],
[50.995626,28.246993],
[50.908556,28.360722],
[50.822662,28.474451],
[50.738029,28.588180],
[50.654739,28.701909],
[50.572876,28.815638],
[50.492520,28.929367],
[50.413750,29.043096],
[50.336644,29.156825],
[50.261279,29.270554],
[50.187728,29.384283],
[50.116064,29.498012],
[50.046359,29.611741],
[49.978680,29.725470],
[49.913094,29.839199],
[49.849667,29.952928],
[49.788460,30.066657],
[49.729535,30.180386],
[49.672949,30.294115],
[49.618758,30.407844],
[49.567016,30.521573],
[49.517774,30.635302],
[49.471080,30.749031],
[49.426980,30.862760],
[49.385519,30.976489],
[49.346736,31.090218],
[49.310671,31.203947],
[49.277358,31.317676],
[49.246830,31.431405],
[49.219119,31.545134],
[49.194251,31.658863],
[49.172250,31.772592],
[49.153138,31.886321],
[49.136935,32.000050],
[49.123656,32.113779],
[49.113314,32.227508],
[49.105920,32.341237],
[49.101480,32.454966],
[49.100000,32.568694],
[49.101480,32.682423],
[49.105920,32.796152],
[49.113314,32.909881],
[49.123656,33.023610],
[49.136935,33.137339],
[49.153138,33.251068],
[49.172250,33.364797],
[49.194251,33.478526],
[49.219119,33.592255],
[49.246830,33.705984],
[49.277358,33.819713],
[49.310671,33.933442],
[49.346736,34.047171],
[49.385519,34.160900],
[49.426980,34.274629],
[49.471080,34.388358],
[49.517774,34.502087],
[49.567016,34.615816],
[49.618758,34.729545],
[49.672949,34.843274],
[49.729535,34.957003],
[49.788460,35.070732],
[49.849667,35.184461],
[49.913094,35.298190],
[49.978680,35.411919],
[50.046359,35.525648],
[50.116064,35.639377],
[50.187728,35.753106],
[50.261279,35.866835],
[50.336644,35.980564],
[50.413750,36.094293],
[50.492520,36.208022],
[50.572876,36.321751],
[50.654739,36.435480],
[50.738029,36.549209],
[50.822662,36.662938],
[50.908556,36.776667],
[50.995626,36.890396],
[51.083786,37.004125],
[51.172949,37.117854],
[51.263027,37.231583],
[51.353930,37.345312],
[51.445570,37.459041],
[51.537856,37.572770],
[51.630697,37.686499],
[51.724000,37.800228],
[51.817675,37.913957],
[51.911628,38.027686],
[52.005768,38.141415],
[52.100000,38.255144],
[52.194232,38.368873],
[52.288372,38.482602],
[52.382325,38.596331],
[52.476000,38.710059],
[52.569303,38.823788],
[52.662144,38.937517],
[52.754430,39.051246],
[52.846070,39.164975],
[52.936973,39.278704],
[53.027051,39.392433],
[53.116214,39.506162],
[53.204374,39.619891],
[53.291444,39.733620],
[53.377338,39.847349],
[53.461971,39.961078],
[53.545261,40.074807],
[53.627124,40.188536],
[53.707480,40.302265],
[53.786250,40.415994],
[53.863356,40.529723],
[53.938721,40.643452],
[54.012272,40.757181],
[54.077033,41.189355],
[54.106570,41.819018],
[54.097792,42.452976],
[54.050269,43.088770],
[53.963738,43.723901],
[53.838105,44.355843],
[53.673452,44.982056],
[53.470031,45.599996],
[53.228271,46.207128],
[52.948779,46.800939],
[52.632330,47.378954],
[52.279876,47.938744],
[51.892533,48.477939],
[51.471584,48.994245],
[51.018471,49.485449],
[50.534789,49.949437],
[50.022279,50.384202],
[49.482822,50.787853],
[48.918428,51.158631],
[48.331229,51.494911],
[47.723469,51.795216],
[47.097490,52.058223],
[46.455726,52.282771],
[45.800686,52.467867],
[45.134947,52.612689],
[44.461136,52.716596],
[43.781922,52.779126],
[43.100000,52.800000],
[42.986271,52.798520],
[42.872542,52.794080],
[42.758813,52.786686],
[42.645084,52.776344],
[42.531355,52.763065],
[42.417626,52.746862],
[42.303897,52.727750],
[42.190168,52.705749],
[42.076439,52.680881],
[41.962710,52.653170],
[41.848981,52.622642],
[41.735252,52.589329],
[41.621523,52.553264],
[41.507794,52.514481],
[41.394065,52.473020],
[41.280336,52.428920],
[41.166607,52.382226],
[41.052878,52.332984],
[40.939149,52.281242],
[40.825420,52.227051],
[40.711691,52.170465],
[40.597962,52.111540],
[40.484233,52.050333],
[40.370504,51.986906],
[40.256775,51.921320],
[40.143046,51.853641],
[40.029317,51.783936],
[39.915589,51.712272],
[39.801860,51.638721],
[39.688131,51.563356],
[39.574402,51.486250],
[39.460673,51.407480],
[39.346944,51.327124],
[39.233215,51.245261],
[39.119486,51.161971],
[39.005757,51.077338],
[38.892028,50.991444],
[38.778299,50.904374],
[38.664570,50.816214],
[38.550841,50.727051],
[38.437112,50.636973],
[38.323383,50.546070],
[38.209654,50.454430],
[38.095925,50.362144],
[37.982196,50.269303],
[37.868467,50.176000],
[37.754738,50.082325],
[37.641009,49.988372],
[37.527280,49.894232],
[37.413551,49.800000],
[37.299822,49.705768],
[37.186093,49.611628],
[37.072364,49.517675],
[36.958635,49.424000],
[36.844906,49.330697],
[36.731177,49.237856],
[36.617448,49.145570],
[36.503719,49.053930],
[36.389990,48.963027],
[36.276261,48.872949],
[36.162532,48.783786],
[36.048803,48.695626],
[35.935074,48.608556],
[35.821345,48.522662],
[35.707616,48.438029],
[35.593887,48.354739],
[35.480158,48.272876],
[35.366429,48.192520],
[35.252700,48.113750],
[35.138971,48.036644],
[35.025242,47.961279],
[34.911513,47.887728],
[34.797784,47.816064],
[34.684055,47.746359],
[34.570326,47.678680],
[34.456597,47.613094],
[34.342868,47.549667],
[34.229139,47.488460],
[34.115410,47.429535],
[34.001681,47.372949],
[33.887952,47.318758],
[33.774224,47.267016],
[33.660495,47.217774],
[33.546766,47.171080],
[33.433037,47.126980],
[33.319308,47.085519],
[33.205579,47.046736],
[33.091850,47.010671],
[32.978121,46.977358],
[32.864392,46.946830],
[32.750663,46.919119],
[32.636934,46.894251],
[32.523205,46.872250],
[32.409476,46.853138],
[32.295747,46.836935],
[32.182018,46.823656],
[32.068289,46.813314],
[31.954560,46.805920],
[31.840831,46.801480],
[31.727102,46.800000],
[31.613373,46.801480],
[31.499644,46.805920],
[31.385915,46.813314],
[31.272186,46.823656],
[31.158457,46.836935],
[31.044728,46.853138],
[30.930999,46.872250],
[30.817270,46.894251],
[30.703541,46.919119],
[30.589812,46.946830],
[30.476083,46.977358],
[30.362354,47.010671],
[30.248625,47.046736],
[30.134896,47.085519],
[30.021167,47.126980],
[29.907438,47.171080],
[29.793709,47.217774],
[29.679980,47.267016],
[29.566251,47.318758],
[29.452522,47.372949],
[29.338793,47.429535],
[29.225064,47.488460],
[29.111335,47.549667],
[28.997606,47.613094],
[28.883877,47.678680],
[28.770148,47.746359],
[28.656419,47.816064],
[28.542690,47.887728],
[28.428961,47.961279],
[28.315232,48.036644],
[28.201503,48.113750],
[28.087774,48.192520],
[27.974045,48.272876],
[27.860316,48.354739],
[27.746587,48.438029],
[27.632858,48.522662],
[27.519130,48.608556],
[27.405401,48.695626],
[27.291672,48.783786],
[27.177943,48.872949],
[27.064214,48.963027],
[26.950485,49.053930],
[26.836756,49.145570],
[26.723027,49.237856],
[26.609298,49.330697],
[26.495569,49.424000],
[26.381840,49.517675],
[26.268111,49.611628],
[26.154382,49.705768],
[26.040653,49.800000],
[25.926924,49.894232],
[25.813195,49.988372],
[25.699466,50.082325],
[25.585737,50.176000],
[25.472008,50.269303],
[25.358279,50.362144],
[25.244550,50.454430],
[25.130821,50.546070],
[25.017092,50.636973],
[24.903363,50.727051],
[24.789634,50.816214],
[24.675905,50.904374],
[24.562176,50.991444],
[24.448447,51.077338],
[24.334718,51.161971],
[24.220989,51.245261],
[24.107260,51.327124],
[23.993531,51.407480],
[23.879802,51.486250],
[23.766073,51.563356],
[23.652344,51.638721],
[23.538615,51.712272],
[23.424886,51.783936],
[23.311157,51.853641],
[23.197428,51.921320],
[23.083699,51.986906],
[22.969970,52.050333],
[22.856241,52.111540],
[22.742512,52.170465],
[22.628783,52.227051],
[22.515054,52.281242],
[22.401325,52.332984],
[22.287596,52.382226],
[22.173867,52.428920],
[22.060138,52.473020],
[21.946409,52.514481],
[21.832680,52.553264],
[21.718951,52.589329],
[21.605222,52.622642],
[21.491493,52.653170],
[21.377765,52.680881],
[21.264036,52.705749],
[21.150307,52.727750],
[21.036578,52.746862],
[20.922849,52.763065],
[20.809120,52.776344],
[20.695391,52.786686],
[20.581662,52.794080],
[20.467933,52.798520],
[20.354204,52.800000],
[20.240475,52.798520],
[20.126746,52.794080],
[20.013017,52.786686],
[19.899288,52.776344],
[19.785559,52.763065],
[19.671830,52.746862],
[19.558101,52.727750],
[19.444372,52.705749],
[19.330643,52.680881],
[19.216914,52.653170],
[19.103185,52.622642],
[18.989456,52.589329],
[18.875727,52.553264],
[18.761998,52.514481],
[18.648269,52.473020],
[18.534540,52.428920],
[18.420811,52.382226],
[18.307082,52.332984],
[18.193353,52.281242],
[18.079624,52.227051],
[17.965895,52.170465],
[17.852166,52.111540],
[17.738437,52.050333],
[17.624708,51.986906],
[17.510979,51.921320],
[17.397250,51.853641],
[17.283521,51.783936],
[17.169792,51.712272],
[17.056063,51.638721],
[16.942334,51.563356],
[16.828605,51.486250],
[16.714876,51.407480],
[16.601147,51.327124],
[16.487418,51.245261],
[16.373689,51.161971],
[16.259960,51.077338],
[16.146231,50.991444],
[16.032502,50.904374],
[15.918773,50.816214],
[15.805044,50.727051],
[15.691315,50.636973],
[15.577586,50.546070],
[15.463857,50.454430],
[15.350128,50.362144],
[15.236399,50.269303],
[15.122671,50.176000],
[15.008942,50.082325],
[14.895213,49.988372],
[14.781484,49.894232],
[14.667755,49.800000],
[14.554026,49.705768],
[14.440297,49.611628],
[14.326568,49.517675],
[14.212839,49.424000],
[14.099110,49.330697],
[13.985381,49.237856],
[13.871652,49.145570],
[13.757923,49.053930],
[13.644194,48.963027],
[13.530465,48.872949],
[13.416736,48.783786],
[13.303007,48.695626],
[13.189278,48.608556],
[13.075549,48.522662],
[12.961820,48.438029],
[12.848091,48.354739],
[12.734362,48.272876],
[12.620633,48.192520],
[12.506904,48.113750],
[12.393175,48.036644],
[12.279446,47.961279],
[12.165717,47.887728],
[12.051988,47.816064],
[11.938259,47.746359],
[11.824530,47.678680],
[11.710801,47.613094],
[11.597072,47.549667],
[11.483343,47.488460],
[11.369614,47.429535],
[11.255885,47.372949],
[11.142156,47.318758],
[11.028427,47.267016],
[10.914698,47.217774],
[10.800969,47.171080],
[10.687240,47.126980],
[10.573511,47.085519],
[10.459782,47.046736],
[10.346053,47.010671],
[10.232324,46.977358],
[10.118595,46.946830],
[10.004866,46.919119],
[9.891137,46.894251],
[9.777408,46.872250],
[9.663679,46.853138],
[9.549950,46.836935],
[9.436221,46.823656],
[9.322492,46.813314],
[9.208763,46.805920],
[9.095034,46.801480],
[8.981306,46.800000],
[8.867577,46.801480],
[8.753848,46.805920],
[8.640119,46.813314],
[8.526390,46.823656],
[8.412661,46.836935],
[8.298932,46.853138],
[8.185203,46.872250],
[8.071474,46.894251],
[7.957745,46.919119],
[7.844016,46.946830],
[7.730287,46.977358],
[7.616558,47.010671],
[7.502829,47.046736],
[7.389100,47.085519],
[7.275371,47.126980],
[7.161642,47.171080],
[7.047913,47.217774],
[6.934184,47.267016],
[6.820455,47.318758],
[6.706726,47.372949],
[6.592997,47.429535],
[6.479268,47.488460],
[6.365539,47.549667],
[6.251810,47.613094],
[6.138081,47.678680],
[6.024352,47.746359],
[5.910623,47.816064],
[5.796894,47.887728],
[5.683165,47.961279],
[5.569436,48.036644],
[5.455707,48.113750],
[5.341978,48.192520],
[5.228249,48.272876],
[5.114520,48.354739],
[5.000791,48.438029],
[4.887062,48.522662],
[4.773333,48.608556],
[4.659604,48.695626],
[4.545875,48.783786],
[4.432146,48.872949],
[4.318417,48.963027],
[4.204688,49.053930],
[4.090959,49.145570],
[3.977230,49.237856],
[3.863501,49.330697],
[3.749772,49.424000],
[3.636043,49.517675],
[3.522314,49.611628],
[3.408585,49.705768],
[3.294856,49.800000],
[3.181127,49.894232],
[3.067398,49.988372],
[2.953669,50.082325],
[2.839941,50.176000],
[2.726212,50.269303],
[2.612483,50.362144],
[2.498754,50.454430],
[2.385025,50.546070],
[2.271296,50.636973],
[2.157567,50.727051],
[2.043838,50.816214],
[1.930109,50.904374],
[1.816380,50.991444],
[1.702651,51.077338],
[1.588922,51.161971],
[1.475193,51.245261],
[1.361464,51.327124],
[1.247735,51.407480],
[1.134006,51.486250],
[1.020277,51.563356],
[0.906548,51.638721],
[0.792819,51.712272],
[0.679090,51.783936],
[0.565361,51.853641],
[0.451632,51.921320],
[0.337903,51.986906],
[0.224174,52.050333],
[0.110445,52.111540],
[-0.003284,52.170465],
[-0.117013,52.227051],
[-0.230742,52.281242],
[-0.344471,52.332984],
[-0.736995,52.377322],
[-1.398443,52.385978],
[-2.061582,52.354156],
[-2.723789,52.281684],
[-3.382422,52.168569],
[-4.034841,52.015000],
[-4.678412,51.821346],
[-5.310529,51.588157],
[-5.928620,51.316164],
[-6.530162,51.006272],
[-7.112697,50.659560],
[-7.673840,50.277276],
[-8.211293,49.860829],
[-8.722857,49.411787],
[-9.206443,48.931863],
[-9.660083,48.422914],
[-10.081937,47.886929],
[-10.470308,47.326017],
[-10.823643,46.742402],
[-11.140549,46.138405],
[-11.419793,45.516440],
[-11.660311,44.878997],
[-11.861213,44.228631],
[-12.021788,43.567950],
[-12.141503,42.899601],
[-12.220011,42.226257],
[-12.257147,41.550604],
[-12.252930,40.875327],
[-12.222642,40.698981],
[-12.189329,40.585252],
[-12.153264,40.471523],
[-12.114481,40.357794],
[-12.073020,40.244065],
[-12.028920,40.130336],
[-11.982226,40.016607],
[-11.932984,39.902878],
[-11.881242,39.789149],
[-11.827051,39.675420],
[-11.770465,39.561691],
[-11.711540,39.447962],
[-11.650333,39.334233],
[-11.586906,39.220504],
[-11.521320,39.106775],
[-11.453641,38.993046],
[-11.383936,38.879317],
[-11.312272,38.765589],
[-11.238721,38.651860],
[-11.163356,38.538131],
[-11.086250,38.424402],
[-11.007480,38.310673],
[-10.927124,38.196944],
[-10.845261,38.083215],
[-10.761971,37.969486],
[-10.677338,37.855757],
[-10.591444,37.742028],
[-10.504374,37.628299],
[-10.416214,37.514570],
[-10.327051,37.400841],
[-10.236973,37.287112],
[-10.146070,37.173383],
[-10.054430,37.059654],
[-9.962144,36.945925],
[-9.869303,36.832196],
[-9.776000,36.718467],
[-9.682325,36.604738],
[-9.588372,36.491009],
[-9.494232,36.377280],
[-9.400000,36.263551],
[-9.305768,36.149822],
[-9.211628,36.036093],
[-9.117675,35.922364],
[-9.024000,35.808635],
[-8.930697,35.694906],
[-8.837856,35.581177],
[-8.745570,35.467448],
[-8.653930,35.353719],
[-8.563027,35.239990],
[-8.472949,35.126261],
[-8.383786,35.012532],
[-8.295626,34.898803],
[-8.208556,34.785074],
[-8.122662,34.671345],
[-8.038029,34.557616],
[-7.954739,34.443887],
[-7.872876,34.330158],
[-7.792520,34.216429],
[-7.713750,34.102700],
[-7.636644,33.988971],
[-7.561279,33.875242],
[-7.487728,33.761513],
[-7.416064,33.647784],
[-7.346359,33.534055],
[-7.278680,33.420326],
[-7.213094,33.306597],
[-7.149667,33.192868],
[-7.088460,33.079139],
[-7.029535,32.965410],
[-6.972949,32.851681],
[-6.918758,32.737952],
[-6.867016,32.624224],
[-6.817774,32.510495],
[-6.771080,32.396766],
[-6.726980,32.283037],
[-6.685519,32.169308],
[-6.646736,32.055579],
[-6.610671,31.941850],
[-6.577358,31.828121],
[-6.546830,31.714392],
[-6.519119,31.600663],
[-6.494251,31.486934],
[-6.472250,31.373205],
[-6.453138,31.259476],
[-6.436935,31.145747],
[-6.423656,31.032018],
[-6.413314,30.918289],
[-6.405920,30.804560],
[-6.401480,30.690831],
[-6.400000,30.577102],
[-6.401480,30.463373],
[-6.405920,30.349644],
[-6.413314,30.235915],
[-6.423656,30.122186],
[-6.436935,30.008457],
[-6.453138,29.894728],
[-6.472250,29.780999],
[-6.494251,29.667270],
[-6.519119,29.553541],
[-6.546830,29.439812],
[-6.577358,29.326083],
[-6.610671,29.212354],
[-6.646736,29.098625],
[-6.685519,28.984896],
[-6.726980,28.871167],
[-6.771080,28.757438],
[-6.817774,28.643709],
[-6.867016,28.529980],
[-6.918758,28.416251],
[-6.972949,28.302522],
[-7.029535,28.188793],
[-7.088460,28.075064],
[-7.149667,27.961335],
[-7.213094,27.847606],
[-7.278680,27.733877],
[-7.346359,27.620148],
[-7.416064,27.506419],
[-7.487728,27.392690],
[-7.561279,27.278961],
[-7.636644,27.165232],
[-7.713750,27.051503],
[-7.792520,26.937774],
[-7.872876,26.824045],
[-7.954739,26.710316],
[-8.038029,26.596587],
[-8.122662,26.482858],
[-8.208556,26.369130],
[-8.295626,26.255401],
[-8.383786,26.141672],
[-8.472949,26.027943],
[-8.563027,25.914214],
[-8.653930,25.800485],
[-8.745570,25.686756],
[-8.837856,25.573027],
[-8.930697,25.459298],
[-9.024000,25.345569],
[-9.117675,25.231840],
[-9.211628,25.118111],
[-9.305768,25.004382],
[-9.400000,24.890653],
[-9.494232,24.776924],
[-9.588372,24.663195],
[-9.682325,24.549466],
[-9.776000,24.435737],
[-9.869303,24.322008],
[-9.962144,24.208279],
[-10.054430,24.094550],
[-10.146070,23.980821],
[-10.236973,23.867092],
[-10.327051,23.753363],
[-10.416214,23.639634],
[-10.504374,23.525905],
[-10.591444,23.412176],
[-10.677338,23.298447],
[-10.761971,23.184718],
[-10.845261,23.070989],
[-10.927124,22.957260],
[-11.007480,22.843531],
[-11.086250,22.729802],
[-11.163356,22.616073],
[-11.238721,22.502344],
[-11.312272,22.388615],
[-11.383936,22.274886],
[-11.453641,22.161157],
[-11.521320,22.047428],
[-11.586906,21.933699],
[-11.650333,21.819970],
[-11.711540,21.706241],
[-11.770465,21.592512],
[-11.827051,21.478783],
[-11.881242,21.365054],
[-11.932984,21.251325],
[-11.982226,21.137596],
[-12.028920,21.023867],
[-12.073020,20.910138],
[-12.114481,20.796409],
[-12.153264,20.682680],
[-12.189329,20.568951],
[-12.222642,20.455222],
[-12.253170,20.341493],
[-12.280881,20.227765],
[-12.305749,20.114036],
[-12.327750,20.000307],
[-12.346862,19.886578],
[-12.363065,19.772849],
[-12.376344,19.659120],
[-12.386686,19.545391],
[-12.394080,19.431662],
[-12.398520,19.317933],
[-12.400000,19.204204],
[-12.398520,19.090475],
[-12.394080,18.976746],
[-12.386686,18.863017],
[-12.376344,18.749288],
[-12.363065,18.635559],
[-12.346862,18.521830],
[-12.327750,18.408101],
[-12.305749,18.294372],
[-12.280881,18.180643],
[-12.253170,18.066914],
[-12.222642,17.953185],
[-12.189329,17.839456],
[-12.153264,17.725727],
[-12.114481,17.611998],
[-12.073020,17.498269],
[-12.028920,17.384540],
[-11.982226,17.270811],
[-11.932984,17.157082],
[-11.881242,17.043353],
[-11.827051,16.929624],
[-11.770465,16.815895],
[-11.711540,16.702166],
[-11.650333,16.588437],
[-11.586906,16.474708],
[-11.521320,16.360979],
[-11.453641,16.247250],
[-11.383936,16.133521],
[-11.312272,16.019792],
[-11.238721,15.906063],
[-11.163356,15.792334],
[-11.086250,15.678605],
[-11.007480,15.564876],
[-10.927124,15.451147],
[-10.845261,15.337418],
[-10.761971,15.223689],
[-10.677338,15.109960],
[-10.591444,14.996231],
[-10.504374,14.882502],
[-10.416214,14.768773],
[-10.327051,14.655044],
[-10.236973,14.541315],
[-10.146070,14.427586],
[-10.054430,14.313857],
[-9.962144,14.200128],
[-9.869303,14.086399],
[-9.776000,13.972671],
[-9.682325,13.858942],
[-9.588372,13.745213],
[-9.494232,13.631484],
[-9.400000,13.517755],
[-9.305768,13.404026],
[-9.211628,13.290297],
[-9.117675,13.176568],
[-9.024000,13.062839],
[-8.930697,12.949110],
[-8.837856,12.835381],
[-8.745570,12.721652],
[-8.653930,12.607923],
[-8.563027,12.494194],
[-8.472949,12.380465],
[-8.383786,12.266736],
[-8.295626,12.153007],
[-8.208556,12.039278],
[-8.122662,11.925549],
[-8.038029,11.811820],
[-7.954739,11.698091],
[-7.872876,11.584362],
[-7.792520,11.470633],
[-7.713750,11.356904],
[-7.636644,11.243175],
[-7.561279,11.129446],
[-7.487728,11.015717],
[-7.416064,10.901988],
[-7.346359,10.788259],
[-7.278680,10.674530],
[-7.213094,10.560801],
[-7.149667,10.447072],
[-7.088460,10.333343],
[-7.029535,10.219614],
[-6.972949,10.105885],
[-6.918758,9.992156],
[-6.867016,9.878427],
[-6.817774,9.764698],
[-6.771080,9.650969],
[-6.726980,9.537240],
[-6.685519,9.423511],
[-6.646736,9.309782],
[-6.610671,9.196053],
[-6.577358,9.082324],
[-6.546830,8.968595],
[-6.519119,8.854866],
[-6.494251,8.741137],
[-6.472250,8.627408],
[-6.453138,8.513679],
[-6.436935,8.399950],
[-6.423656,8.286221],
[-6.413314,8.172492],
[-6.405920,8.058763],
[-6.401480,7.945034],
[-6.400000,7.831306],
[-6.401480,7.717577],
[-6.405920,7.603848],
[-6.413314,7.490119],
[-6.423656,7.376390],
[-6.436935,7.262661],
[-6.453138,7.148932],
[-6.472250,7.035203],
[-6.494251,6.921474],
[-6.519119,6.807745],
[-6.546830,6.694016],
[-6.577358,6.580287],
[-6.610671,6.466558],
[-6.646736,6.352829],
[-6.685519,6.239100],
[-6.726980,6.125371],
[-6.771080,6.011642],
[-6.817774,5.897913],
[-6.867016,5.784184],
[-6.918758,5.670455],
[-6.972949,5.556726],
[-7.029535,5.442997],
[-7.088460,5.329268],
[-7.149667,5.215539],
[-7.213094,5.101810],
[-7.278680,4.988081],
[-7.346359,4.874352],
[-7.416064,4.760623],
[-7.487728,4.646894],
[-7.561279,4.533165],
[-7.636644,4.419436],
[-7.713750,4.305707],
[-7.792520,4.191978],
[-7.872876,4.078249],
[-7.954739,3.964520],
[-8.038029,3.850791],
[-8.122662,3.737062],
[-8.208556,3.623333],
[-8.295626,3.509604],
[-8.383786,3.395875],
[-8.472949,3.282146],
[-8.563027,3.168417],
[-8.653930,3.054688],
[-8.745570,2.940959],
[-8.837856,2.827230],
[-8.930697,2.713501],
[-9.024000,2.599772],
[-9.117675,2.486043],
[-9.211628,2.372314],
[-9.305768,2.258585],
[-9.400000,2.144856],
[-9.494232,2.031127],
[-9.588372,1.917398],
[-9.682325,1.803669],
[-9.776000,1.689941],
[-9.869303,1.576212],
[-9.962144,1.462483],
[-10.054430,1.348754],
[-10.146070,1.235025],
[-10.236973,1.121296],
[-10.327051,1.007567],
[-10.416214,0.893838],
[-10.504374,0.780109],
[-10.591444,0.666380],
[-10.677338,0.552651],
[-10.761971,0.438922],
[-10.845261,0.325193],
[-10.927124,0.211464],
[-11.007480,0.097735],
[-11.086250,-0.015994],
[-11.163356,-0.129723],
[-11.238721,-0.243452],
[-11.312272,-0.357181],
[-11.377033,-0.789355],
[-11.406570,-1.419018],
[-11.397792,-2.052976],
[-11.350269,-2.688770],
[-11.263738,-3.323901],
[-11.138105,-3.955843],
[-10.973452,-4.582056],
[-10.770031,-5.199996],
[-10.528271,-5.807128],
[-10.248779,-6.400939],
[-9.932330,-6.978954],
[-9.579876,-7.538744],
[-9.192533,-8.077939],
[-8.771584,-8.594245],
[-8.318471,-9.085449],
[-7.834789,-9.549437],
[-7.322279,-9.984202],
[-6.782822,-10.387853],
[-6.218428,-10.758631],
[-5.631229,-11.094911],
[-5.023469,-11.395216],
[-4.397490,-11.658223],
[-3.755726,-11.882771],
[-3.100686,-12.067867],
[-2.434947,-12.212689],
[-1.761136,-12.316596],
[-1.081922,-12.379126]
];
