supermadboy/boxbert/(list of files, cad)

Other CAD files:
3d-print/mounts/aw9523-mount/archive/rejected-2026-10-09/aw9523_mount.scad
3d-print/mounts/aw9523-mount/archive/rejected-2026-10-09/aw9523_mount.stl
3d-print/mounts/feather-window-mount/archive/two-sided-superseded/cnc-pocket.dxf
3d-print/mounts/max98357-mount/max98357_mount.stl
3d-print/mounts/stepup-mount/archive/rejected-2026-10-09/stepup_mount.scad
3d-print/mounts/stepup-mount/archive/rejected-2026-10-09/stepup_mount.stl
