supermadboy/boxbert/3d-print/mounts/cnc-positionierung/boxbert-cnc-positionierung.pdf

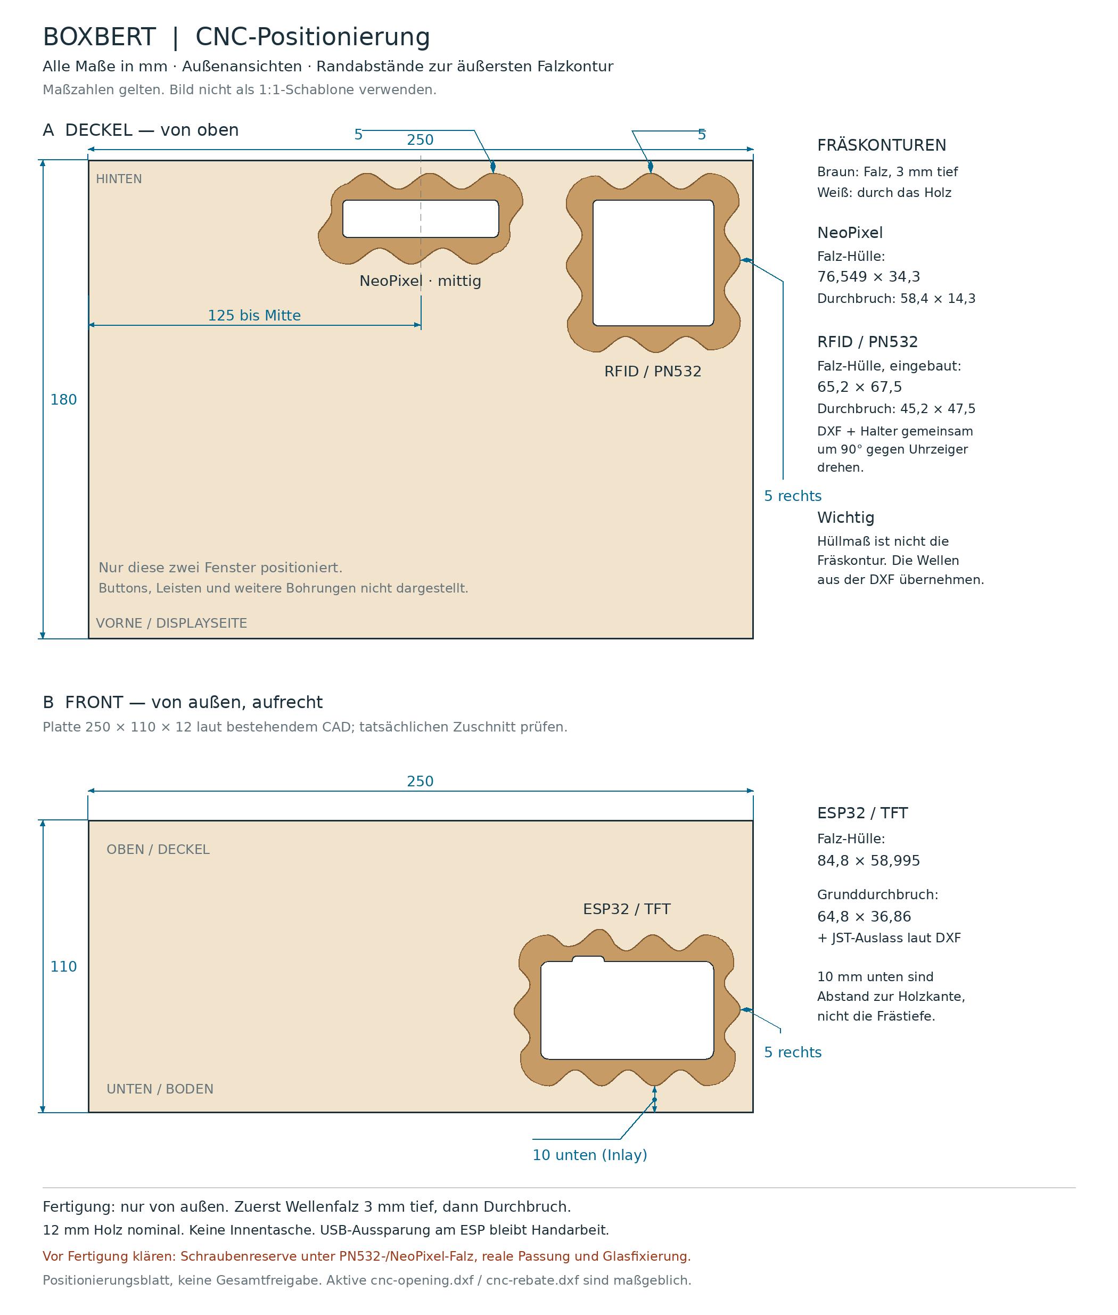
[picture p58: page 1]
