supermadboy/boxbert/3d-print/mounts/aw9523-mount/archive/rejected-2026-10-09/STATUS.md

# VERWORFEN — nicht drucken, keine Vorlage

Nutzer hat am 09.10.2026 den bisherigen AW9523-Mount verworfen und einen
kompletten Neustart beauftragt. Die übrigen Dateien dieses Ordners sind
unveränderte historische Kopien; deren README, Bilder und PASS-Prüfungen
sind keine aktuelle Freigabe. Insbesondere Freistich-Wand 0,61 mm und
Fasen-PCB-Darstellung nicht übernehmen. Aktueller Neuaufbau im übergeordneten
Mount-Ordner; siehe dessen README und docs/testprotokoll-aw9523-mount.md.
