supermadboy/boxbert/3d-print/mounts/akku-mount/iso-akku.png

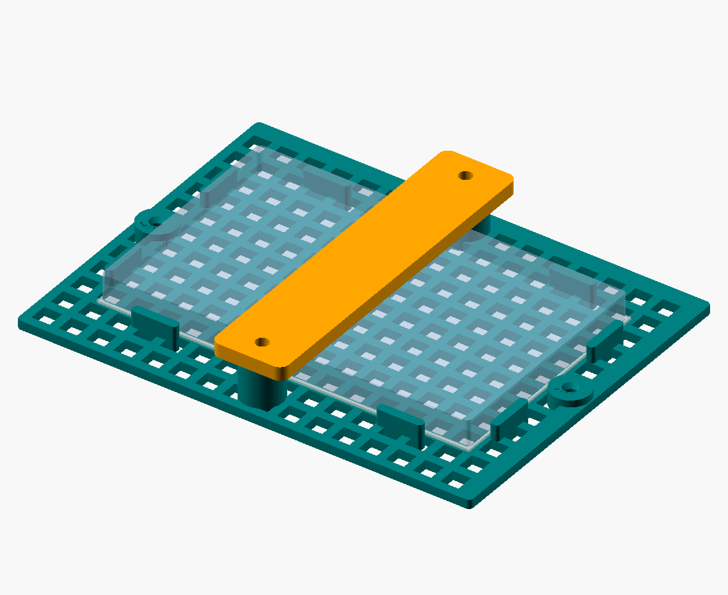
3d-print/mounts/akku-mount/iso-akku.png
