supermadboy/boxbert/3d-print/mounts/akku-mount/iso.png

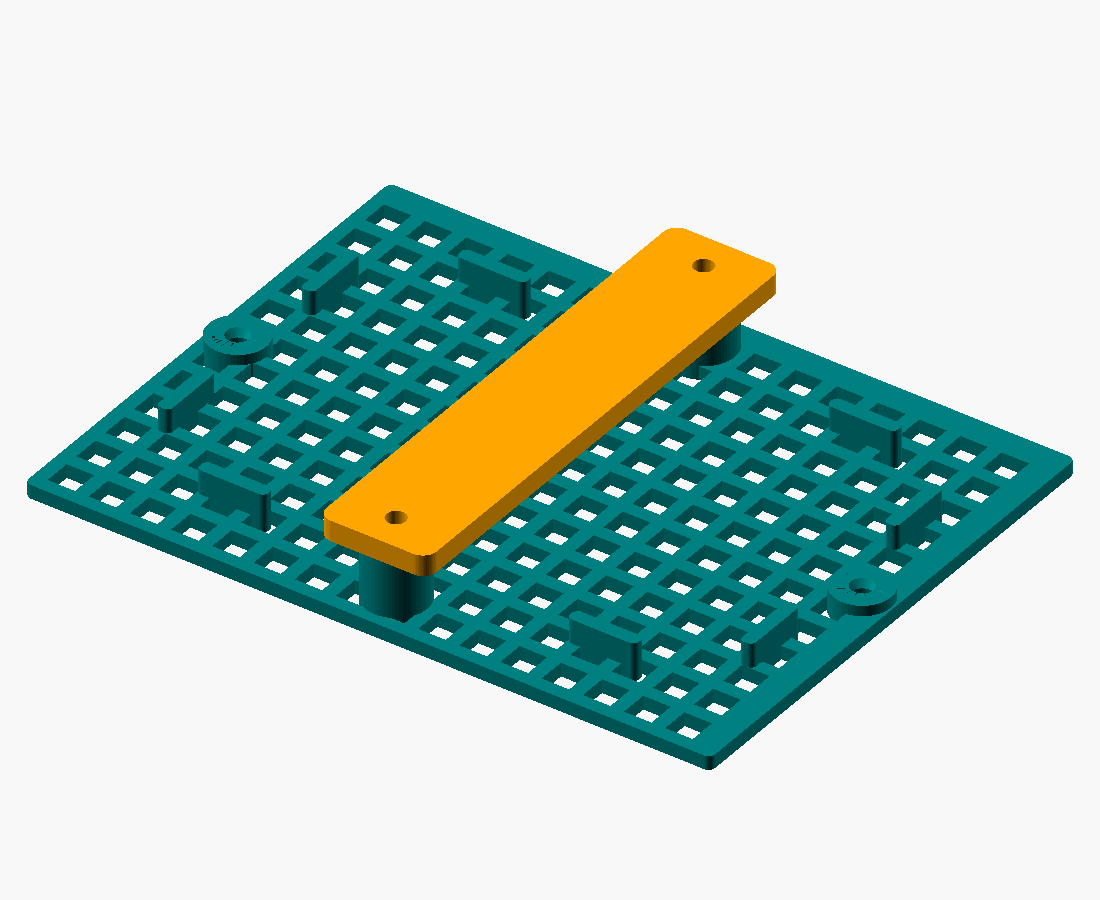
3d-print/mounts/akku-mount/iso.png
