supermadboy/boxbert/3d-print/mounts/akku-mount/side-akku.png

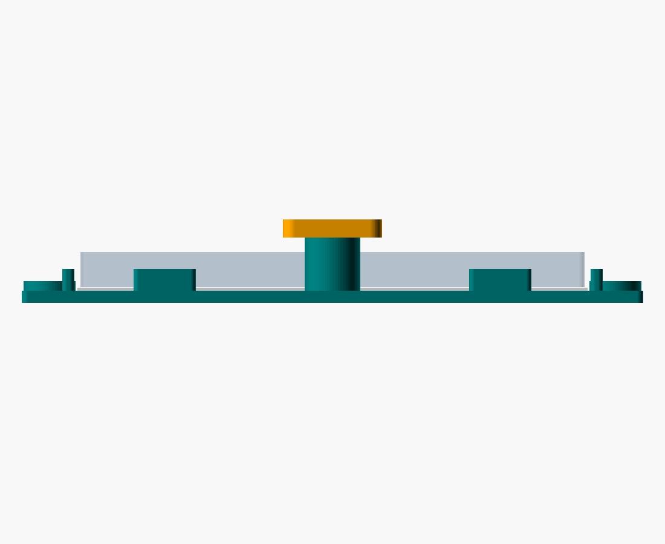
3d-print/mounts/akku-mount/side-akku.png
