supermadboy/boxbert/3d-print/mounts/akku-mount/top-akku.png

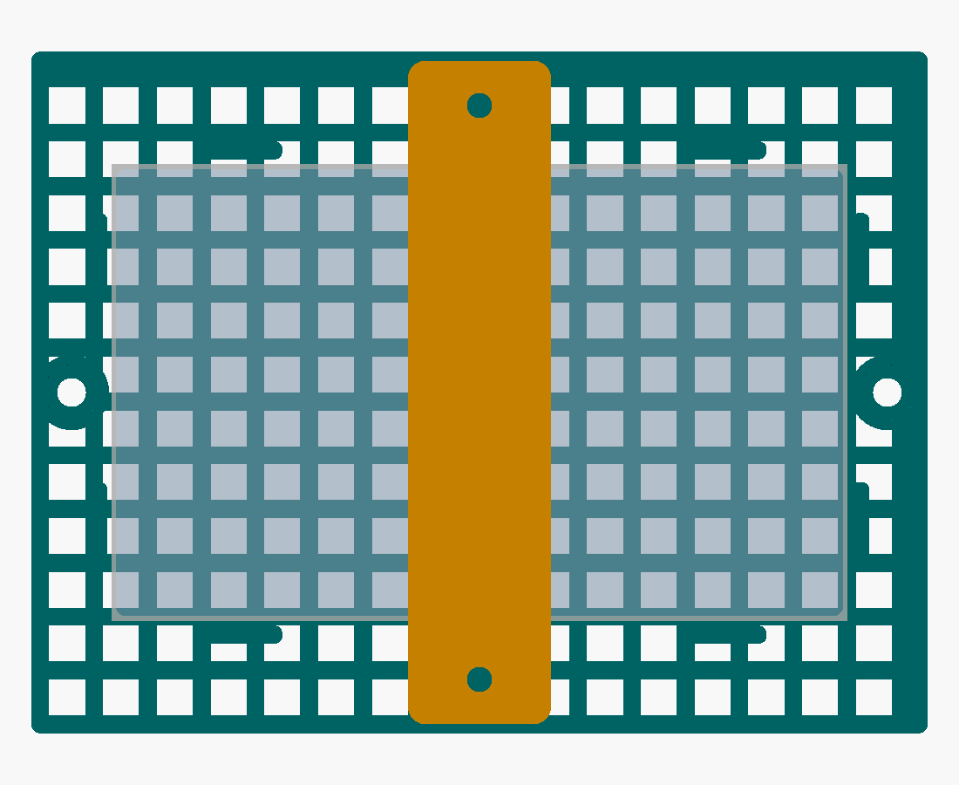
3d-print/mounts/akku-mount/top-akku.png
