supermadboy/boxbert/3d-print/mounts/akku-mount/top.png

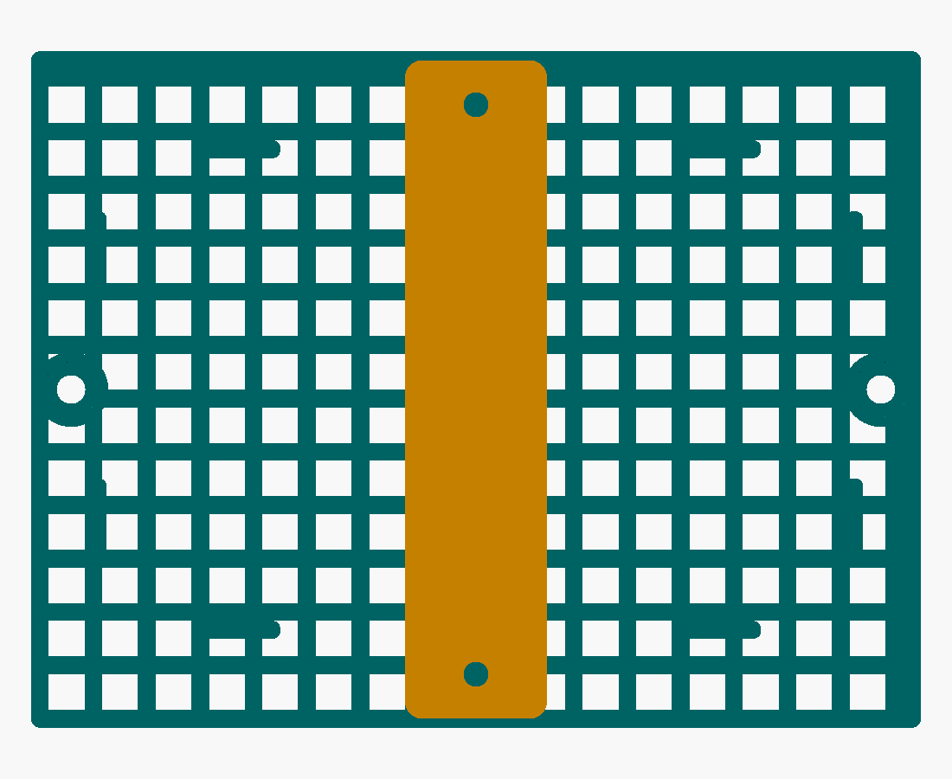
3d-print/mounts/akku-mount/top.png
