supermadboy/boxbert/3d-print/mounts/feather-window-mount/connections.png

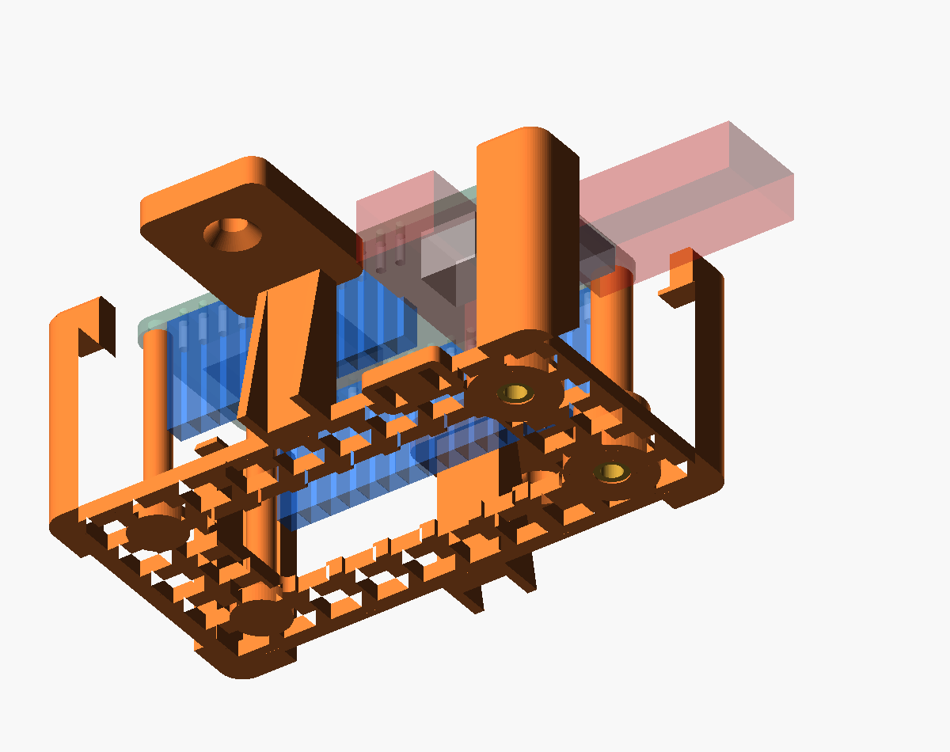
3d-print/mounts/feather-window-mount/connections.png
