supermadboy/boxbert/3d-print/mounts/feather-window-mount/exploded.png

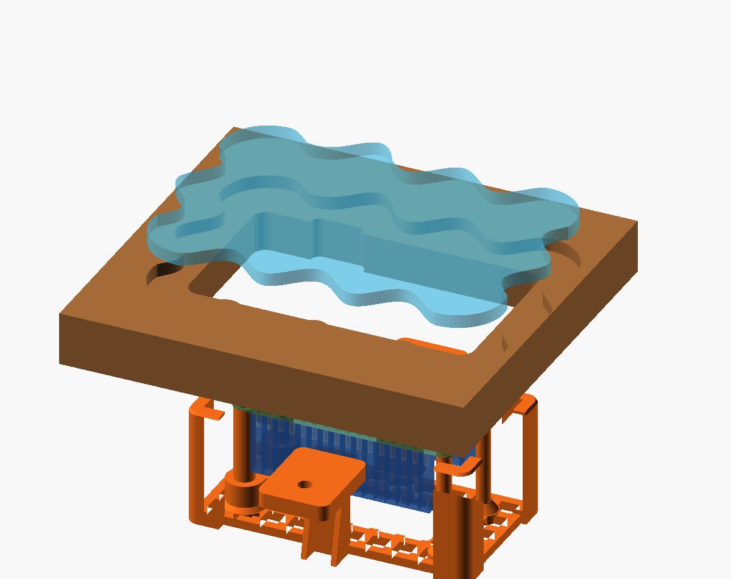
3d-print/mounts/feather-window-mount/exploded.png
