supermadboy/boxbert/3d-print/mounts/feather-window-mount/front-full.png

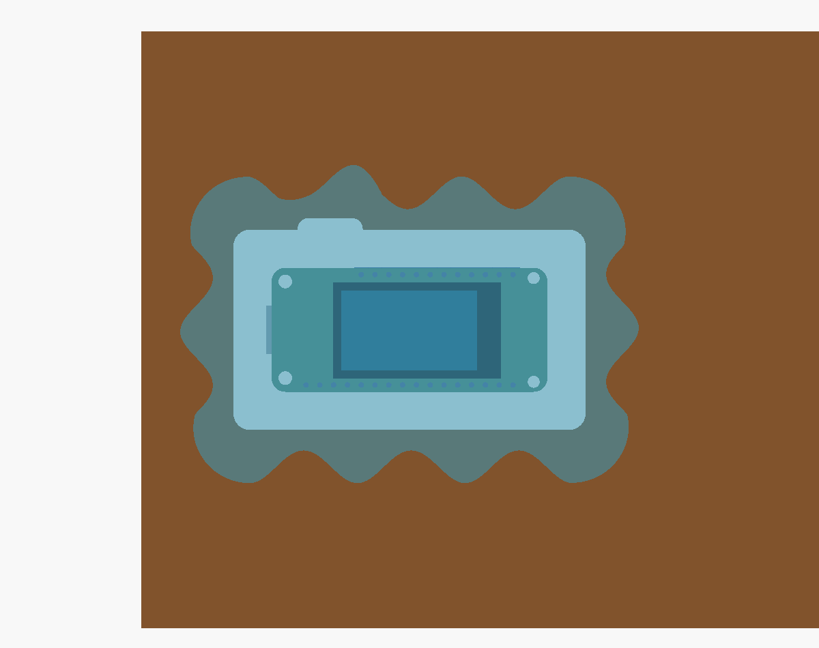
3d-print/mounts/feather-window-mount/front-full.png
