supermadboy/boxbert/3d-print/mounts/feather-window-mount/front-inner.png

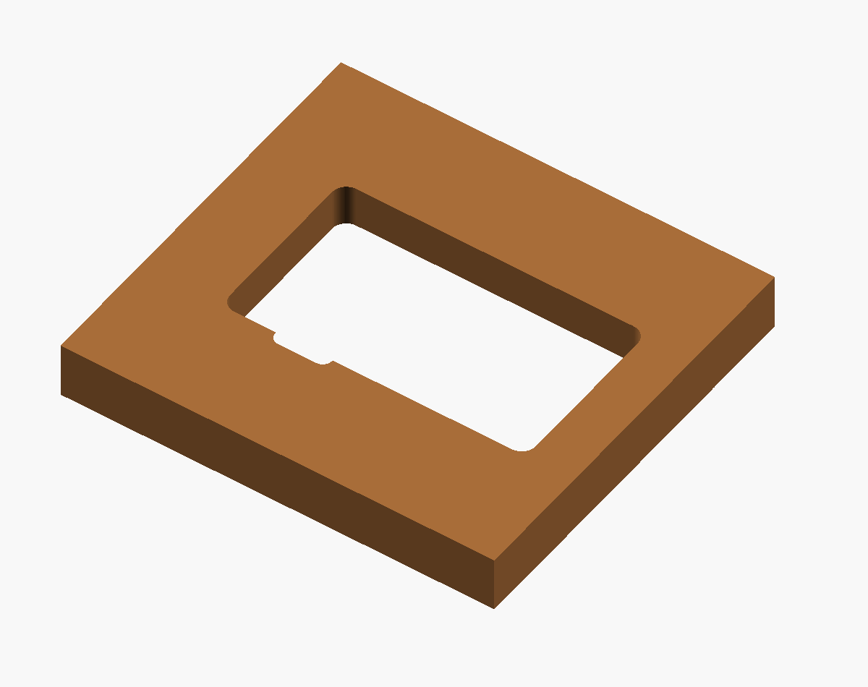
3d-print/mounts/feather-window-mount/front-inner.png
