supermadboy/boxbert/3d-print/mounts/feather-window-mount/height-side.png

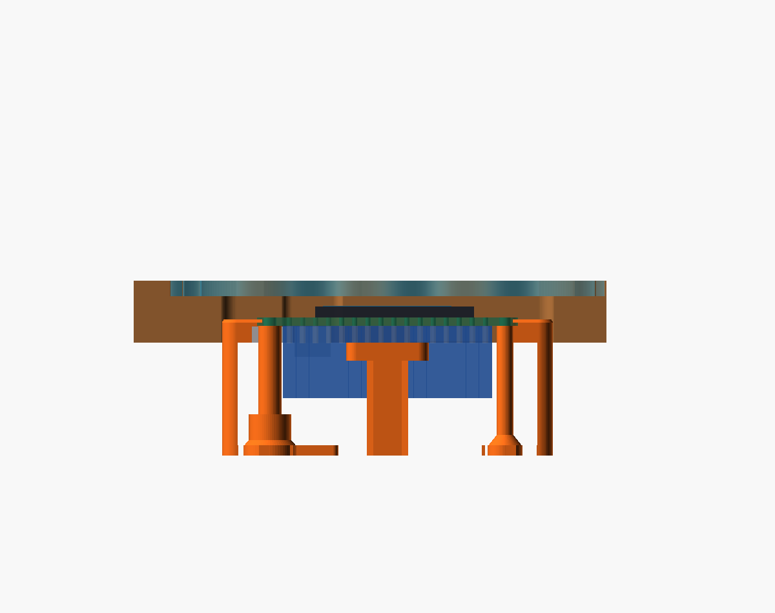
3d-print/mounts/feather-window-mount/height-side.png
