supermadboy/boxbert/3d-print/mounts/feather-window-mount/installation.png

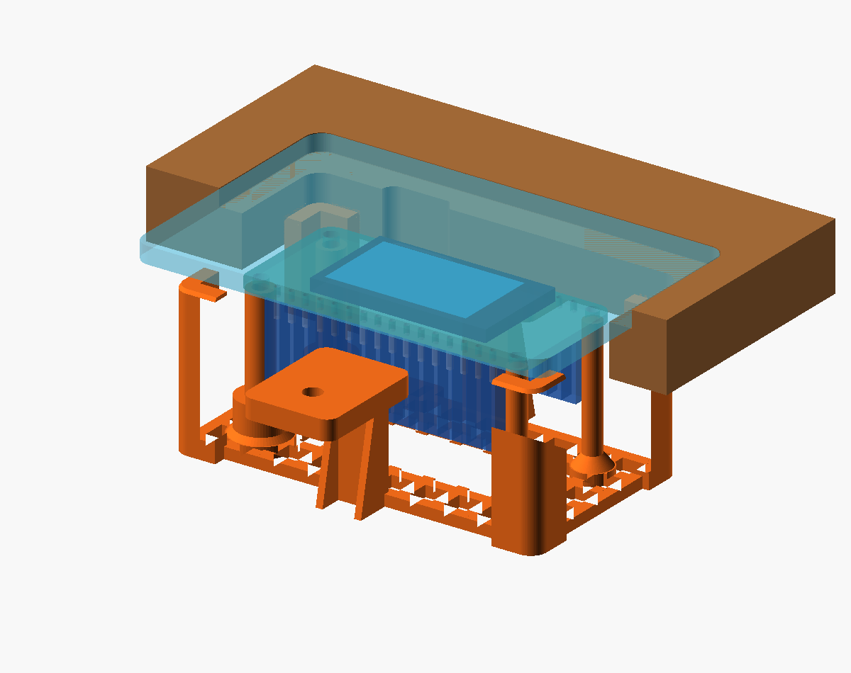
3d-print/mounts/feather-window-mount/installation.png
