supermadboy/boxbert/3d-print/mounts/feather-window-mount/iso-board.png

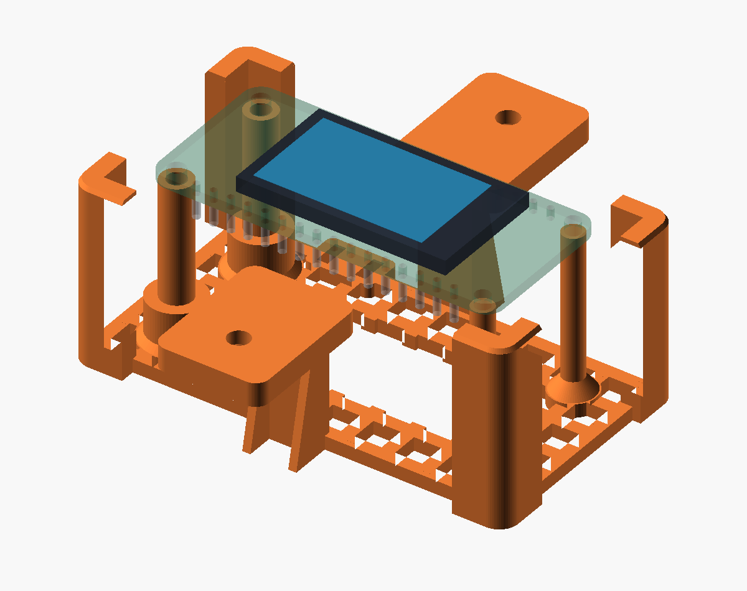
3d-print/mounts/feather-window-mount/iso-board.png
