supermadboy/boxbert/3d-print/mounts/feather-window-mount/iso.png

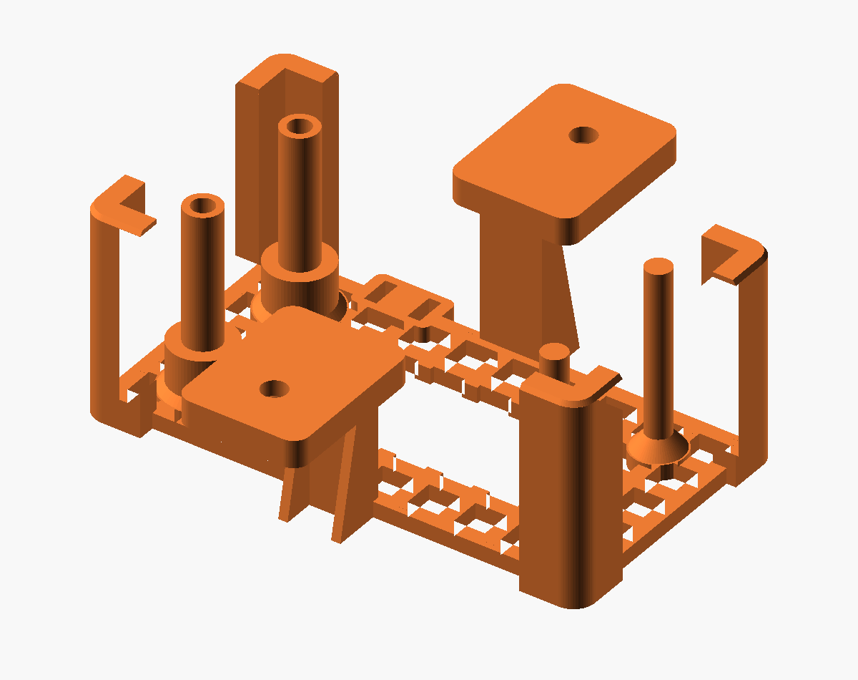
3d-print/mounts/feather-window-mount/iso.png
