supermadboy/boxbert/3d-print/mounts/feather-window-mount/seated-inside.png

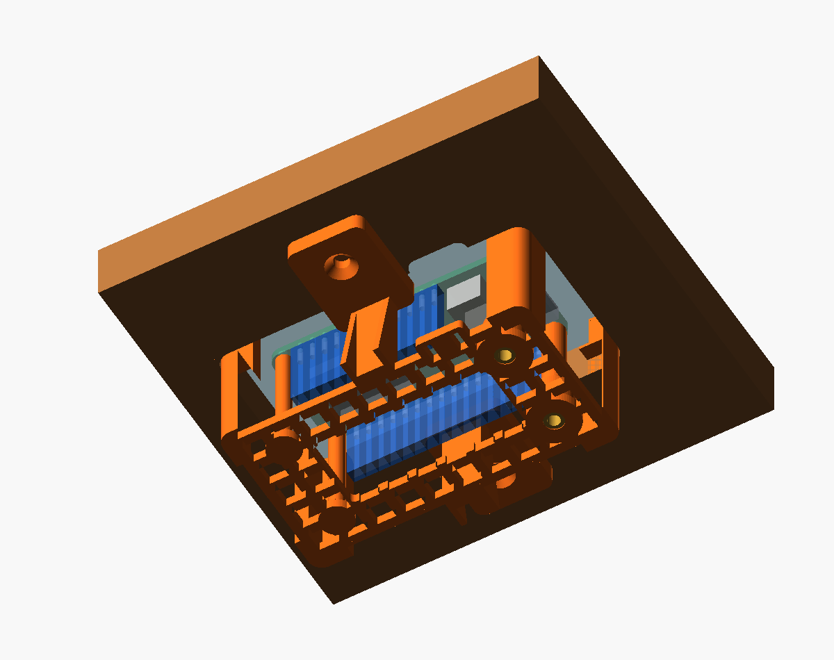
3d-print/mounts/feather-window-mount/seated-inside.png
