supermadboy/boxbert/3d-print/mounts/feather-window-mount/side-board.png

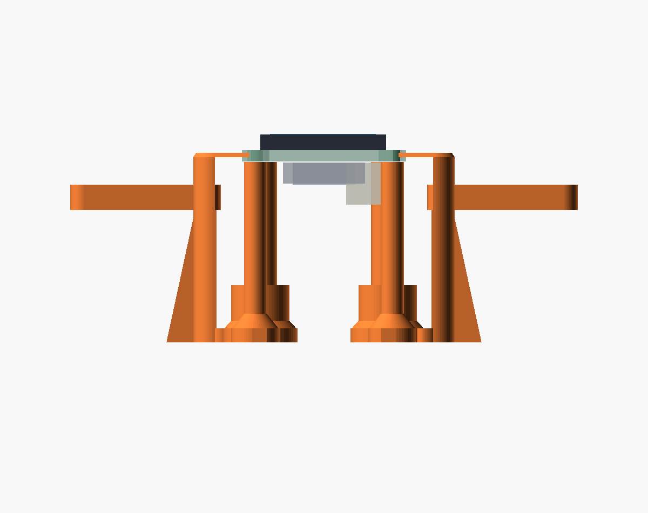
3d-print/mounts/feather-window-mount/side-board.png
