supermadboy/boxbert/3d-print/mounts/feather-window-mount/top-board.png

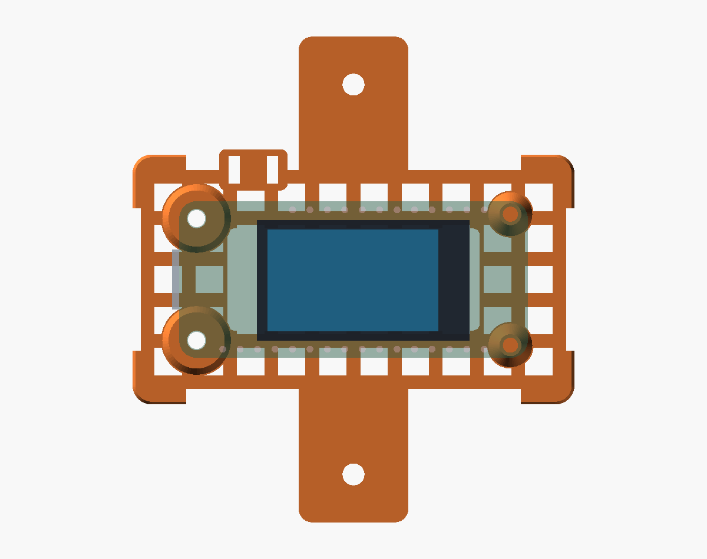
3d-print/mounts/feather-window-mount/top-board.png
