supermadboy/boxbert/3d-print/mounts/feather-window-mount/top.png

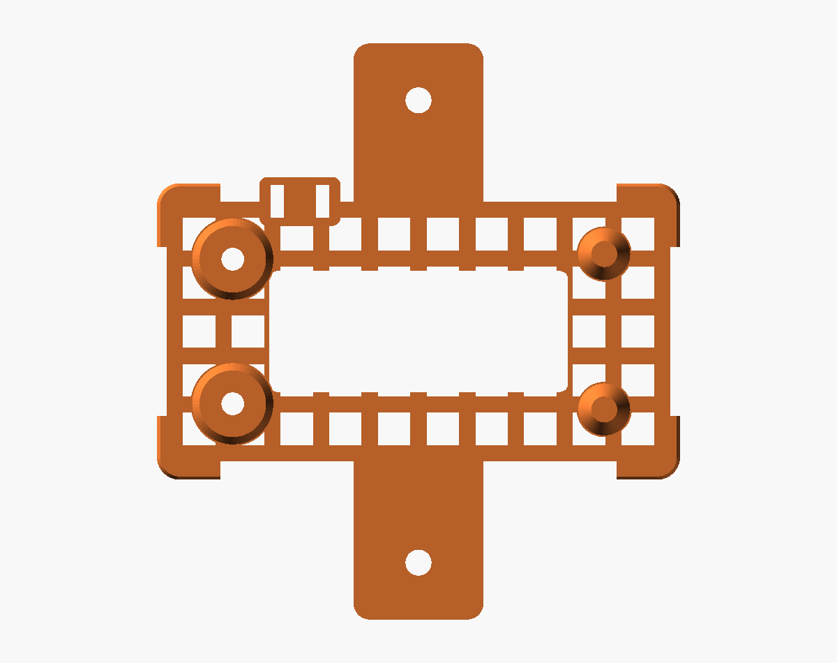
3d-print/mounts/feather-window-mount/top.png
