supermadboy/boxbert/3d-print/mounts/feather-window-mount/wave-iso.png

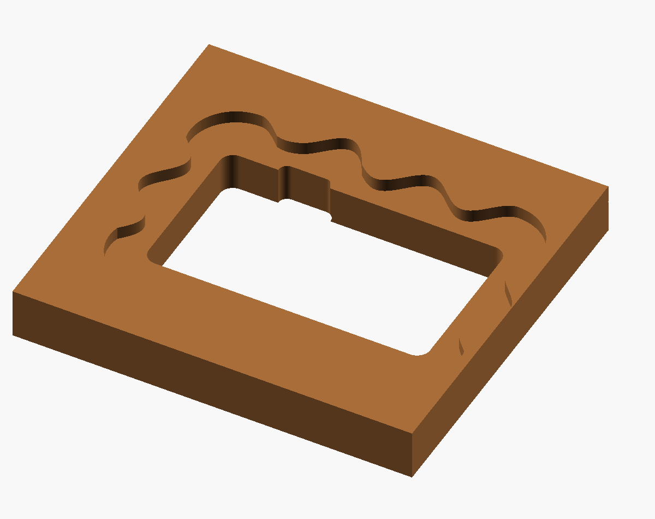
3d-print/mounts/feather-window-mount/wave-iso.png
