supermadboy/boxbert/3d-print/mounts/feather-window-mount/wave-top.png

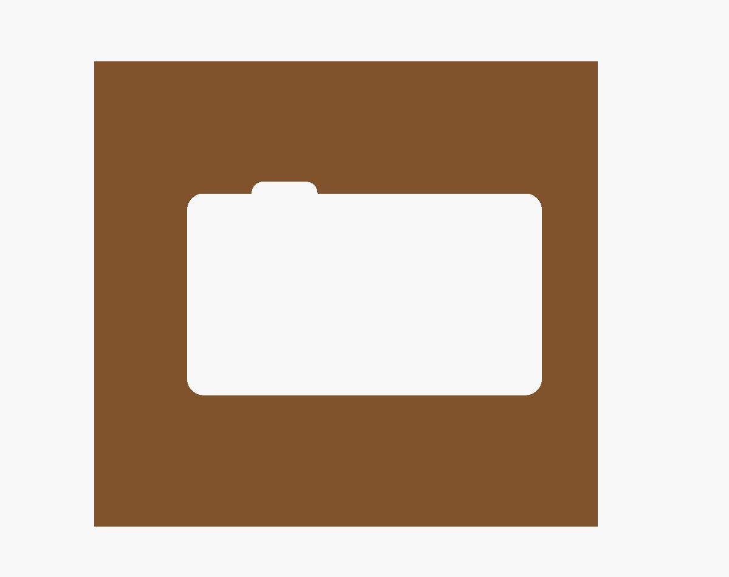
3d-print/mounts/feather-window-mount/wave-top.png
