supermadboy/boxbert/3d-print/mounts/neopixel-stick-mount/cnc-compare-raw.png

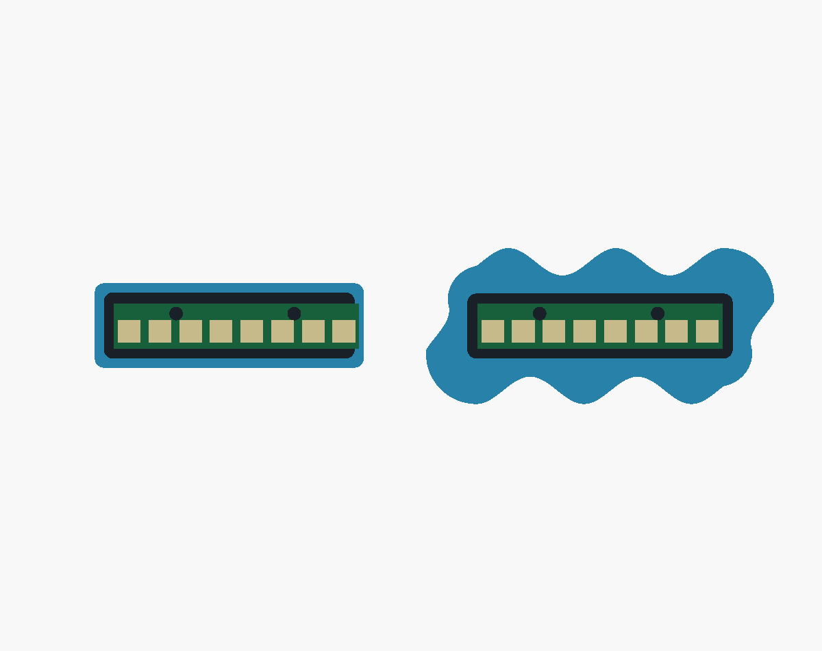
3d-print/mounts/neopixel-stick-mount/cnc-compare-raw.png
