supermadboy/boxbert/3d-print/mounts/neopixel-stick-mount/cnc-compare.png

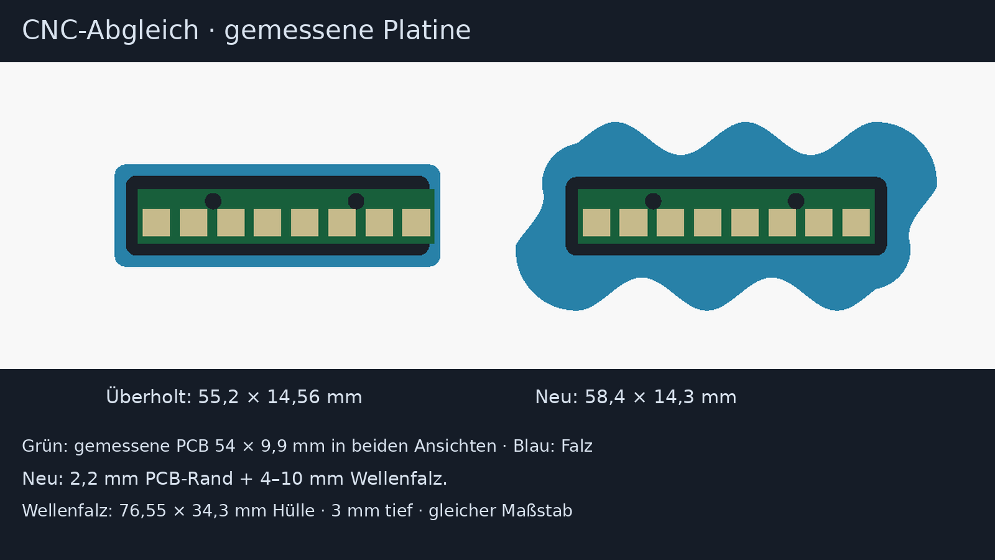
3d-print/mounts/neopixel-stick-mount/cnc-compare.png
