supermadboy/boxbert/3d-print/mounts/neopixel-stick-mount/exploded.png

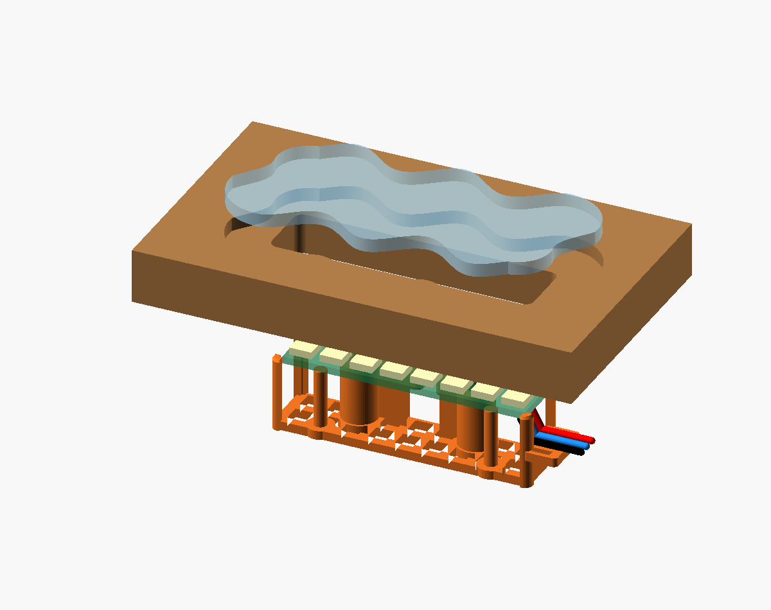
3d-print/mounts/neopixel-stick-mount/exploded.png
