supermadboy/boxbert/3d-print/mounts/neopixel-stick-mount/height-raw.png

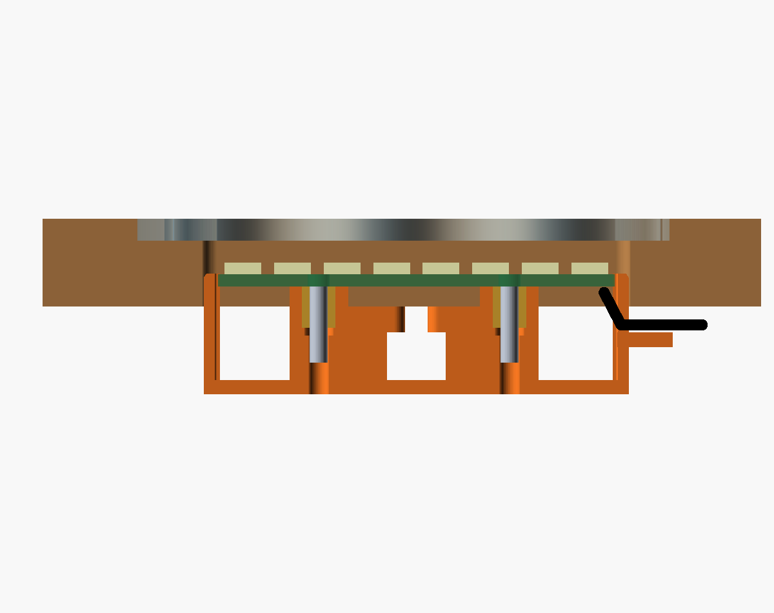
3d-print/mounts/neopixel-stick-mount/height-raw.png
