supermadboy/boxbert/3d-print/mounts/neopixel-stick-mount/height-side.png

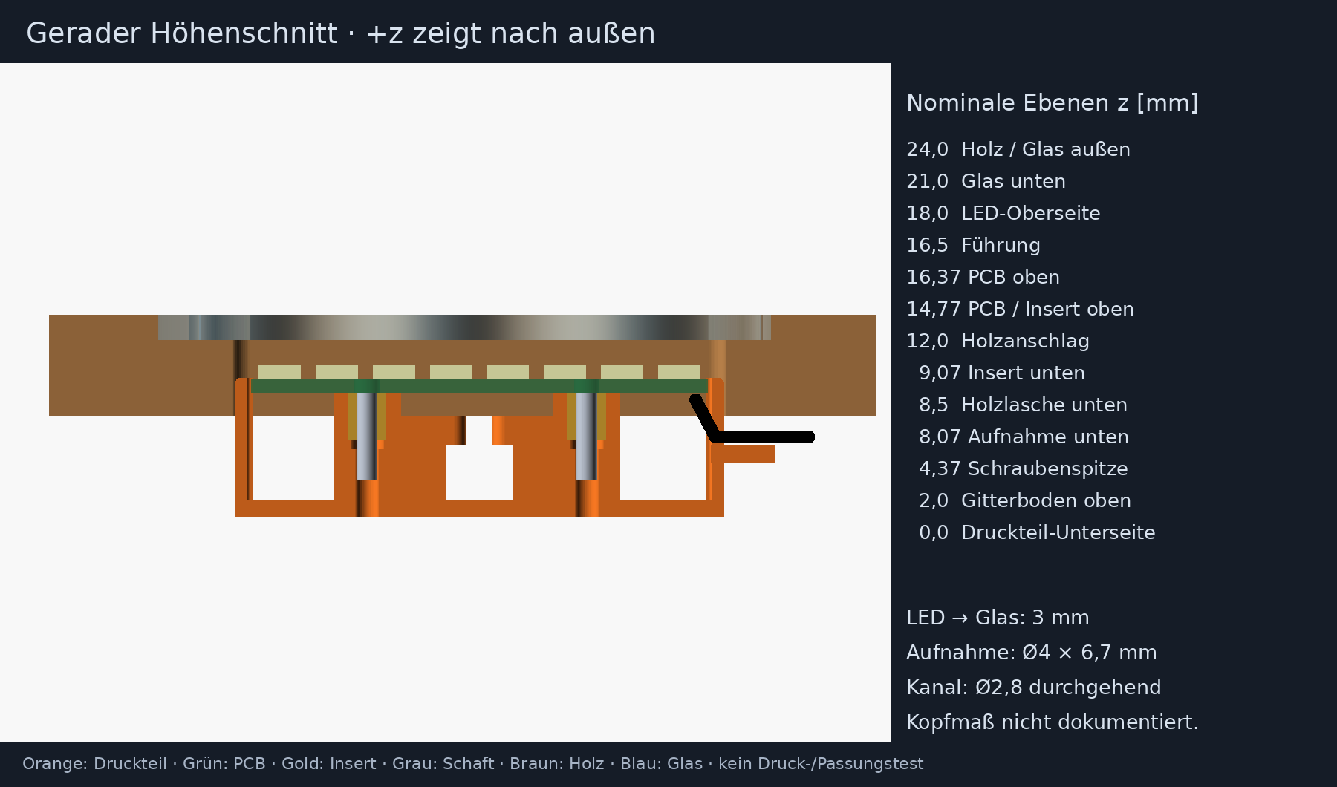
3d-print/mounts/neopixel-stick-mount/height-side.png
