supermadboy/boxbert/3d-print/mounts/neopixel-stick-mount/iso-board.png

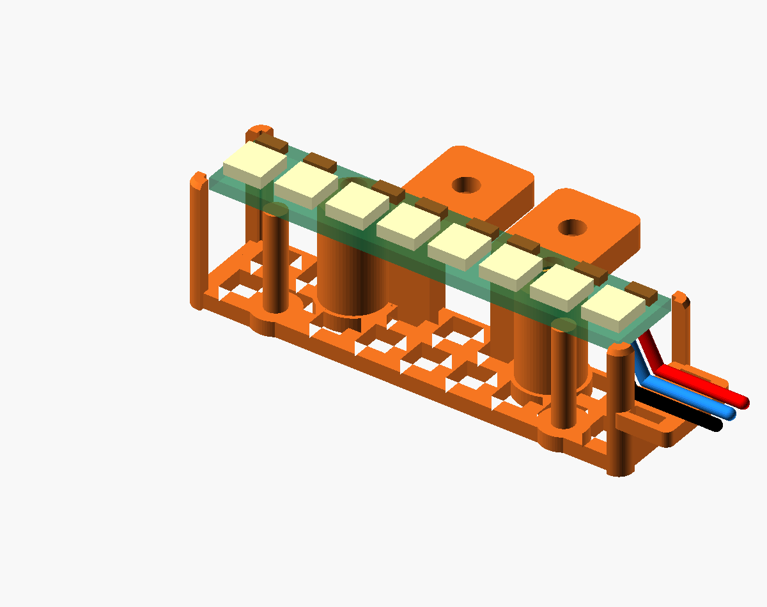
3d-print/mounts/neopixel-stick-mount/iso-board.png
