supermadboy/boxbert/3d-print/mounts/neopixel-stick-mount/outside.png

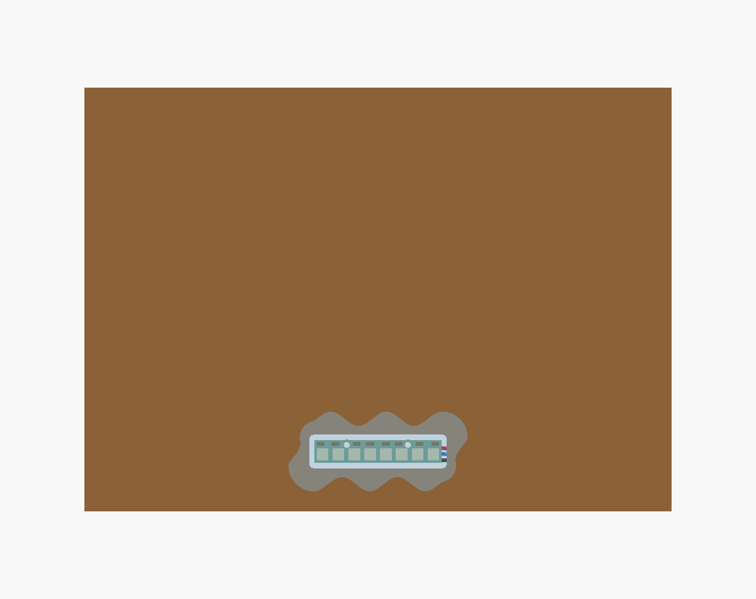
3d-print/mounts/neopixel-stick-mount/outside.png
