supermadboy/boxbert/3d-print/mounts/neopixel-stick-mount/seated-inside.png

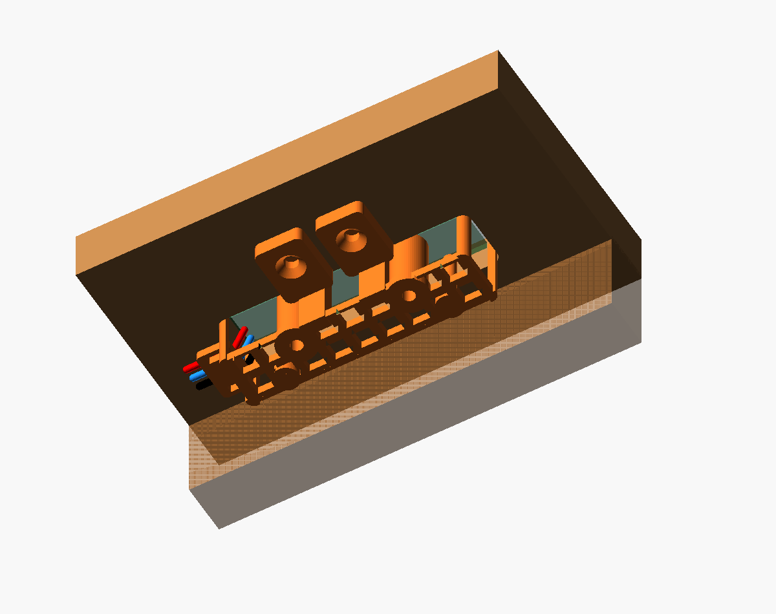
3d-print/mounts/neopixel-stick-mount/seated-inside.png
