supermadboy/boxbert/3d-print/mounts/neopixel-stick-mount/top-board.png

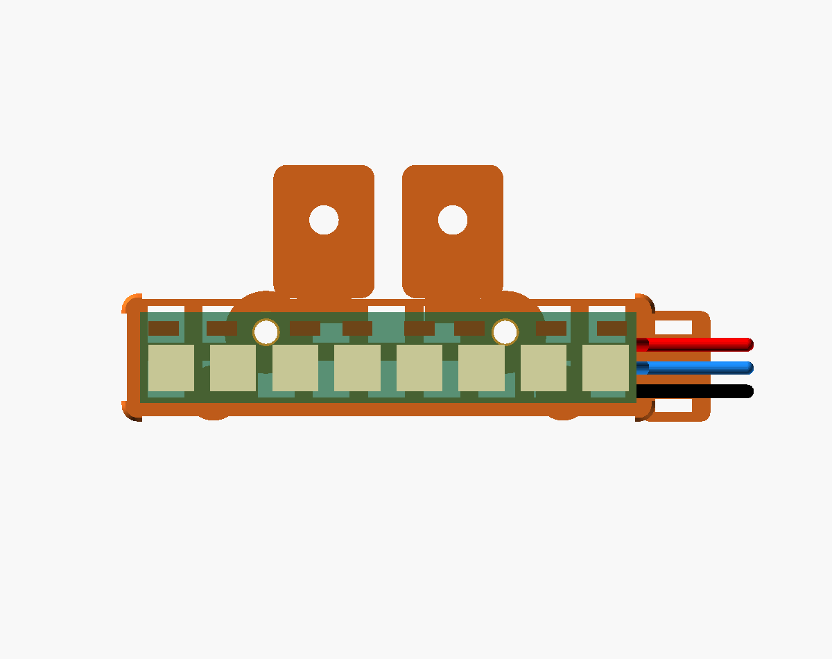
3d-print/mounts/neopixel-stick-mount/top-board.png
