supermadboy/boxbert/3d-print/mounts/neopixel-stick-mount/wave-iso.png

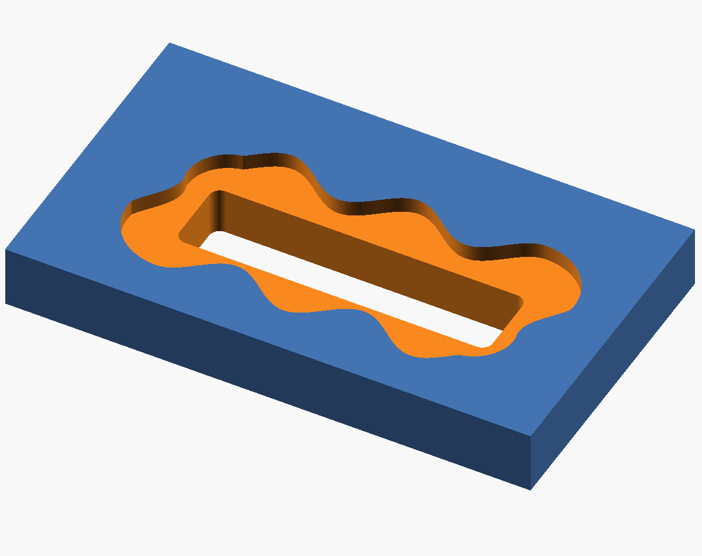
3d-print/mounts/neopixel-stick-mount/wave-iso.png
