supermadboy/boxbert/3d-print/mounts/neopixel-stick-mount/wave-top.png

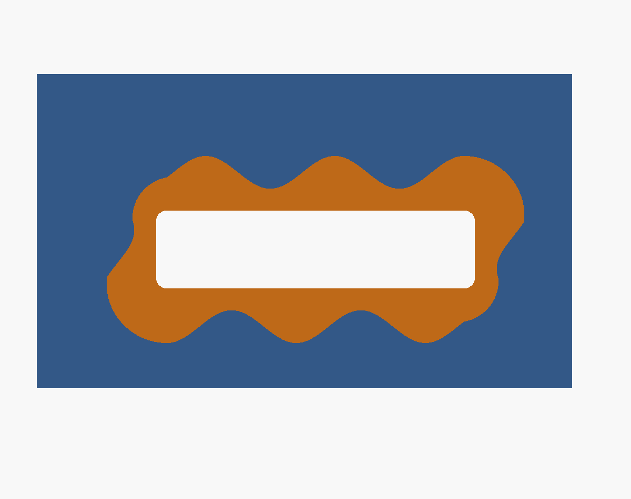
3d-print/mounts/neopixel-stick-mount/wave-top.png
