supermadboy/boxbert/3d-print/mounts/pn532-mount/exploded.png

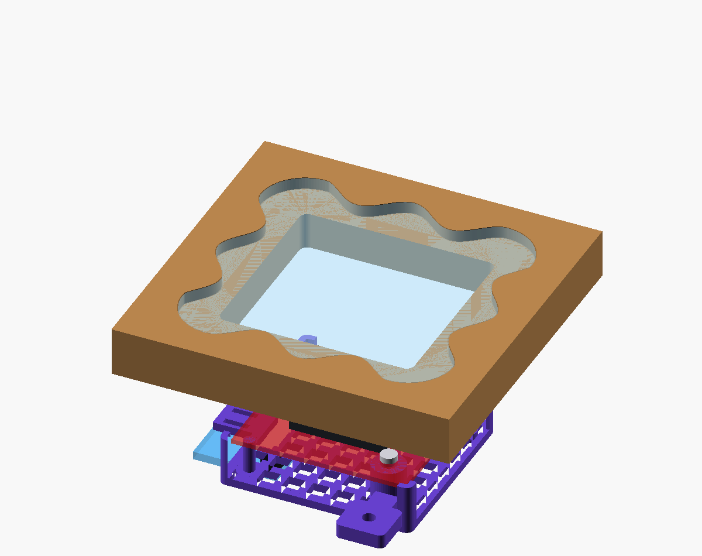
3d-print/mounts/pn532-mount/exploded.png
