supermadboy/boxbert/3d-print/mounts/pn532-mount/height-raw.png

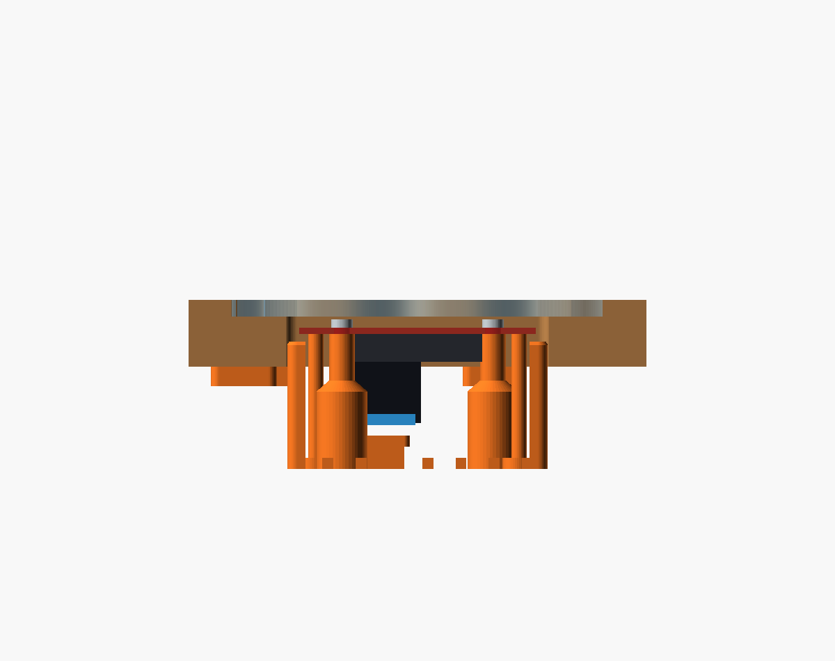
3d-print/mounts/pn532-mount/height-raw.png
