supermadboy/boxbert/3d-print/mounts/pn532-mount/height-side.png

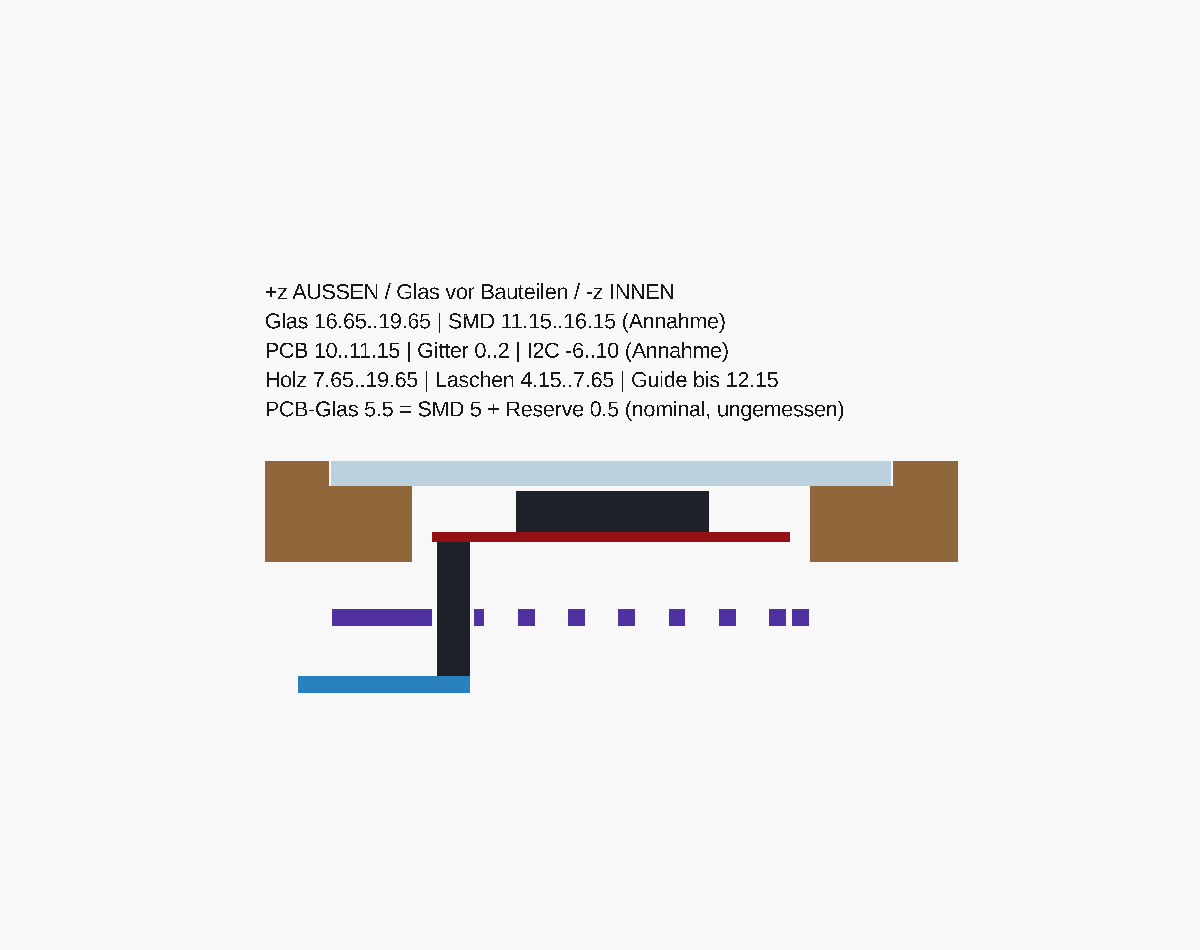
3d-print/mounts/pn532-mount/height-side.png
