supermadboy/boxbert/3d-print/mounts/pn532-mount/iso-board.png

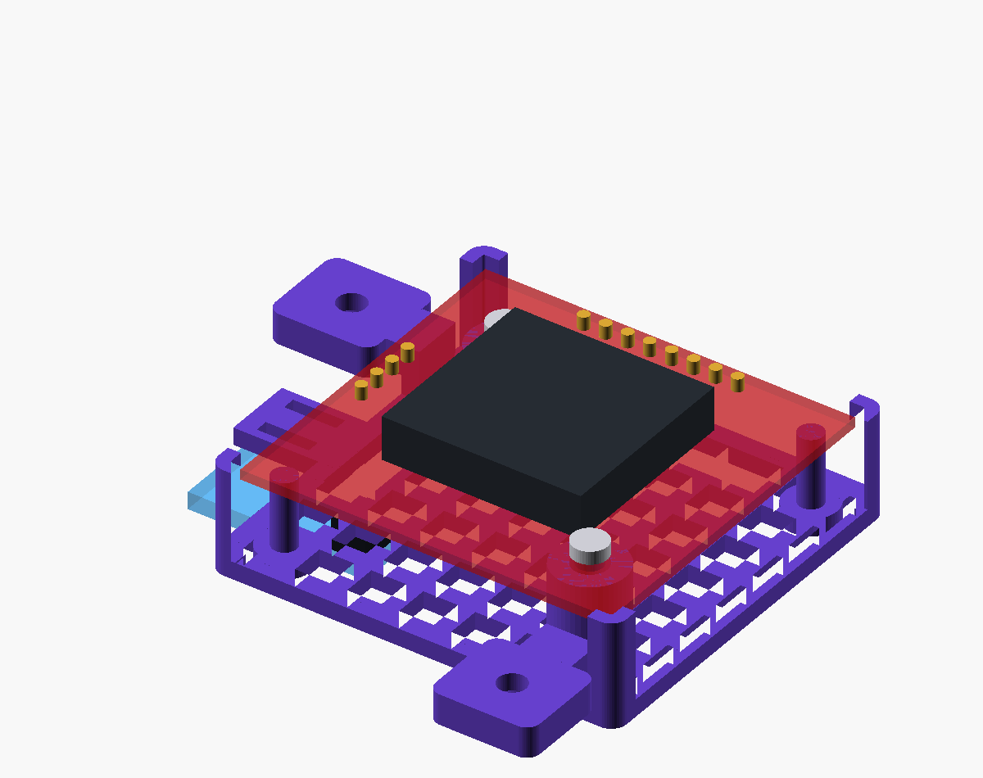
3d-print/mounts/pn532-mount/iso-board.png
