supermadboy/boxbert/3d-print/mounts/pn532-mount/iso.png

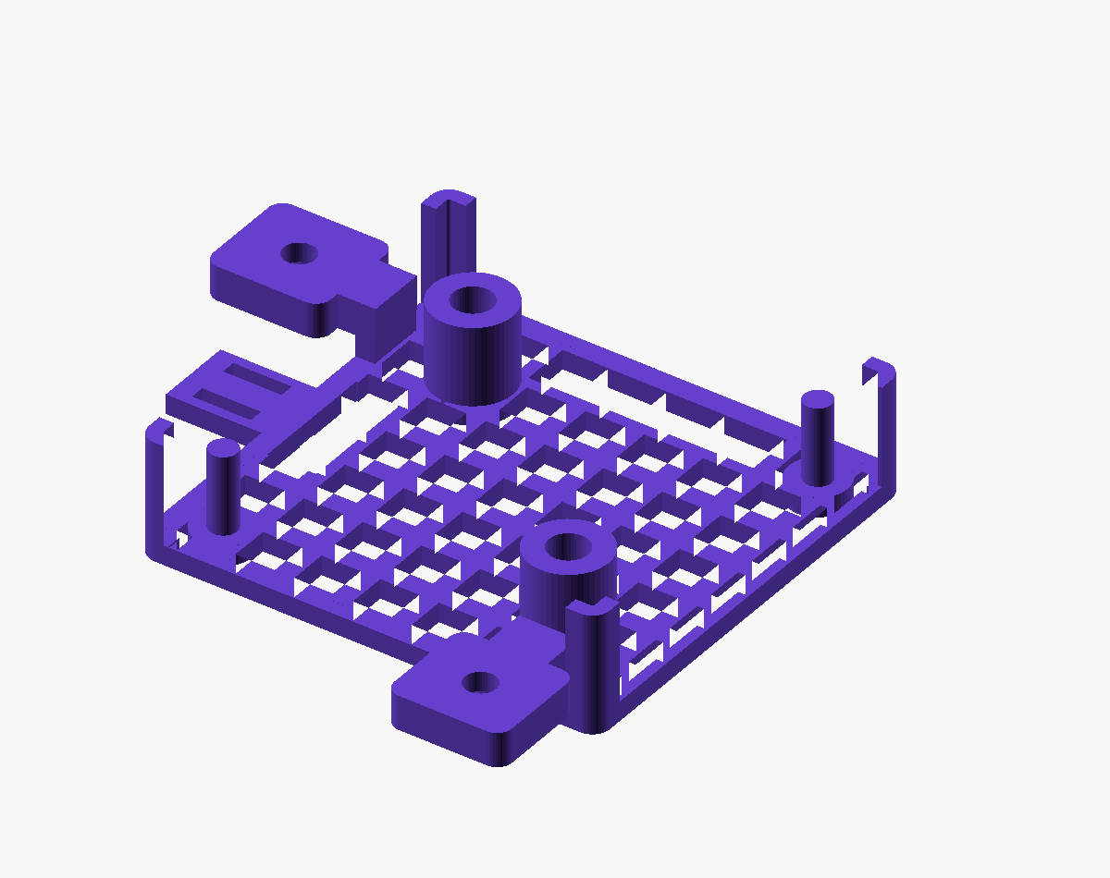
3d-print/mounts/pn532-mount/iso.png
