supermadboy/boxbert/3d-print/mounts/pn532-mount/outside.png

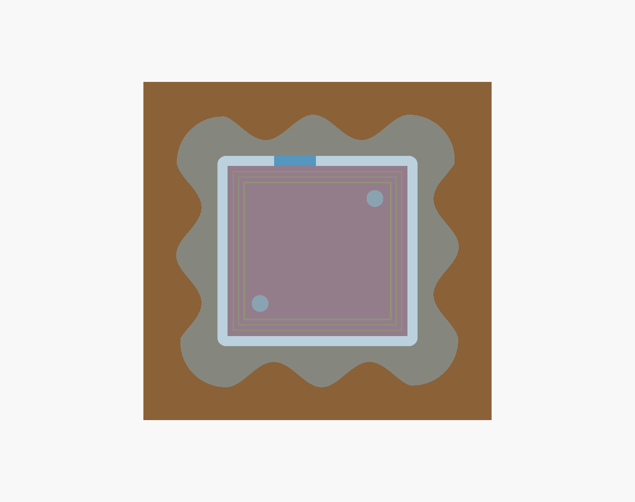
3d-print/mounts/pn532-mount/outside.png
