supermadboy/boxbert/3d-print/mounts/pn532-mount/seated-inside.png

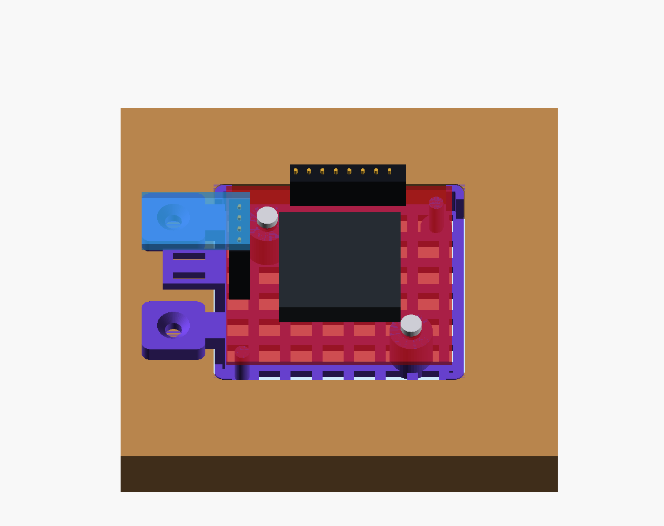
3d-print/mounts/pn532-mount/seated-inside.png
