supermadboy/boxbert/3d-print/mounts/pn532-mount/seated-outside.png

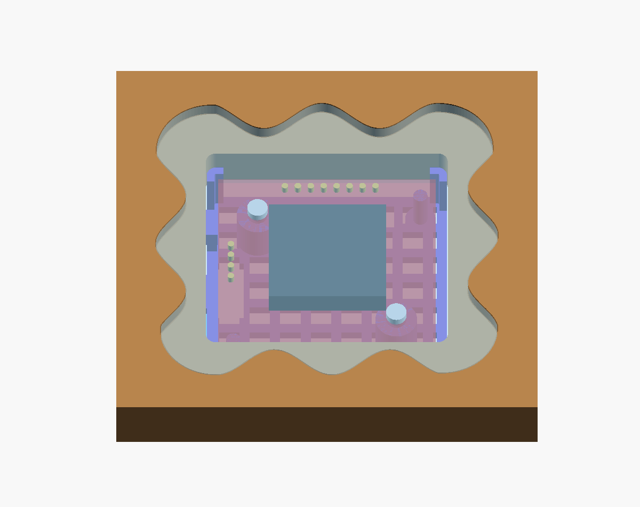
3d-print/mounts/pn532-mount/seated-outside.png
