supermadboy/boxbert/3d-print/mounts/pn532-mount/side-board.png

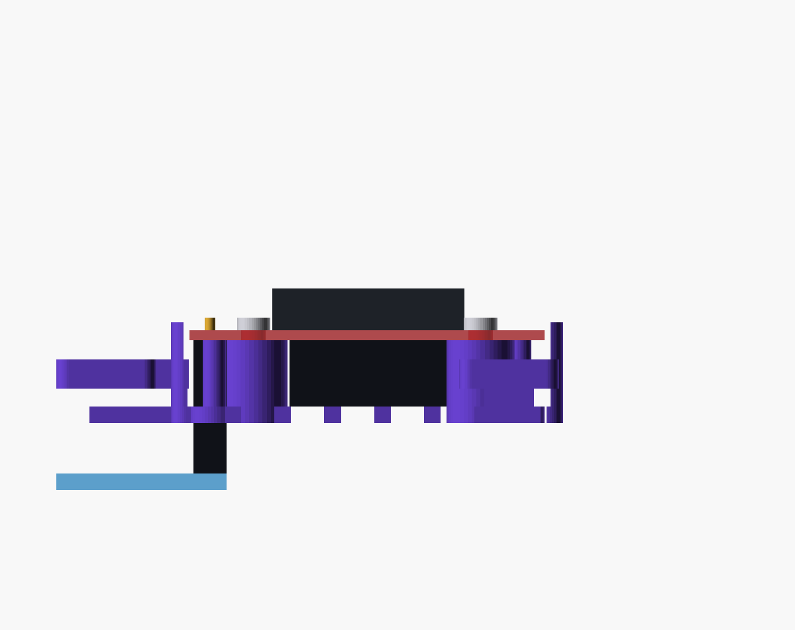
3d-print/mounts/pn532-mount/side-board.png
