supermadboy/boxbert/3d-print/mounts/pn532-mount/top-board.png

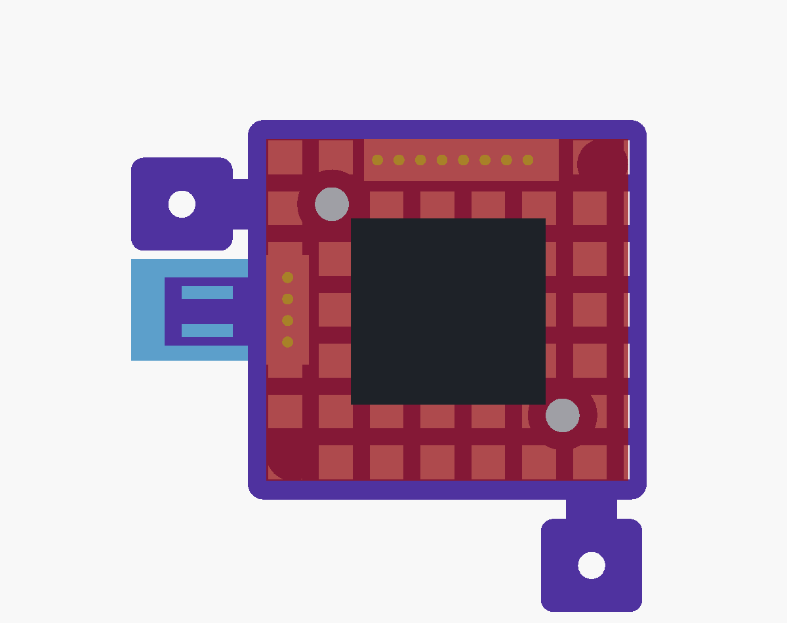
3d-print/mounts/pn532-mount/top-board.png
