supermadboy/boxbert/3d-print/mounts/pn532-mount/wave-iso.png

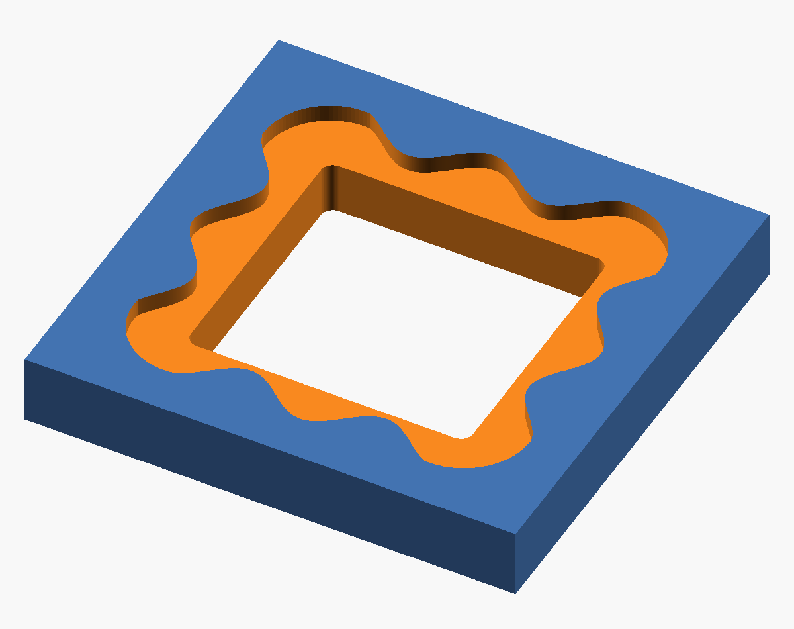
3d-print/mounts/pn532-mount/wave-iso.png
