supermadboy/boxbert/3d-print/mounts/pn532-mount/wave-preview/perspective.png

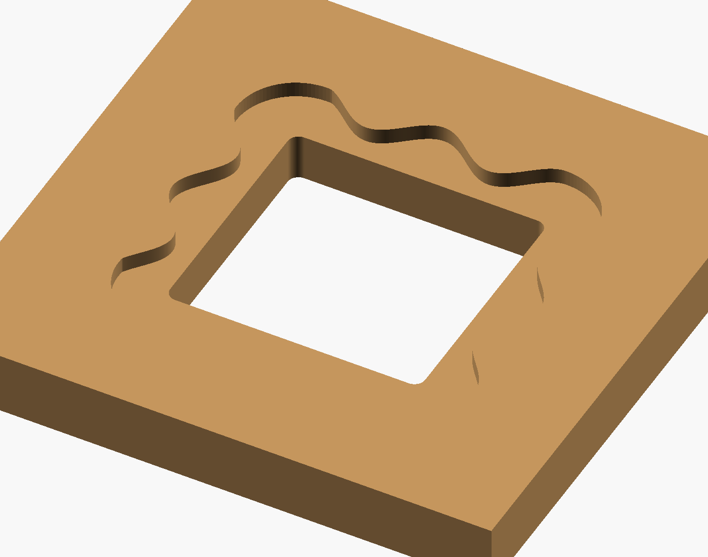
3d-print/mounts/pn532-mount/wave-preview/perspective.png
