supermadboy/boxbert/3d-print/mounts/pn532-mount/wave-preview/top.png

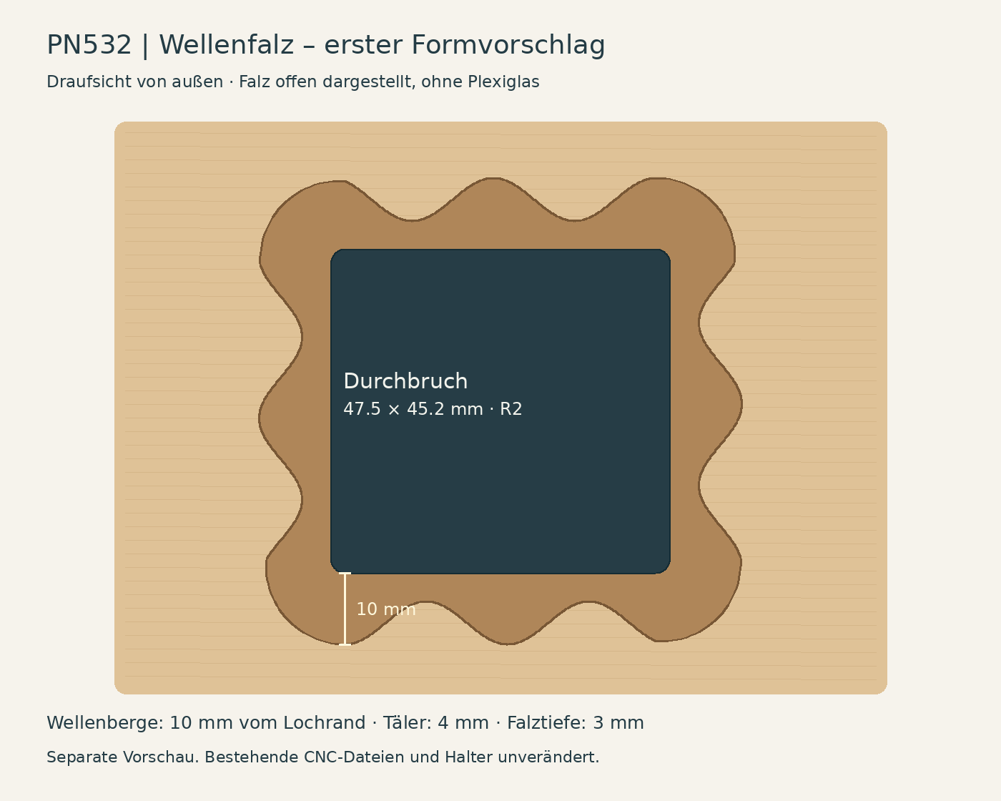
3d-print/mounts/pn532-mount/wave-preview/top.png
