supermadboy/boxbert/3d-print/mounts/pn532-mount/wave-top.png

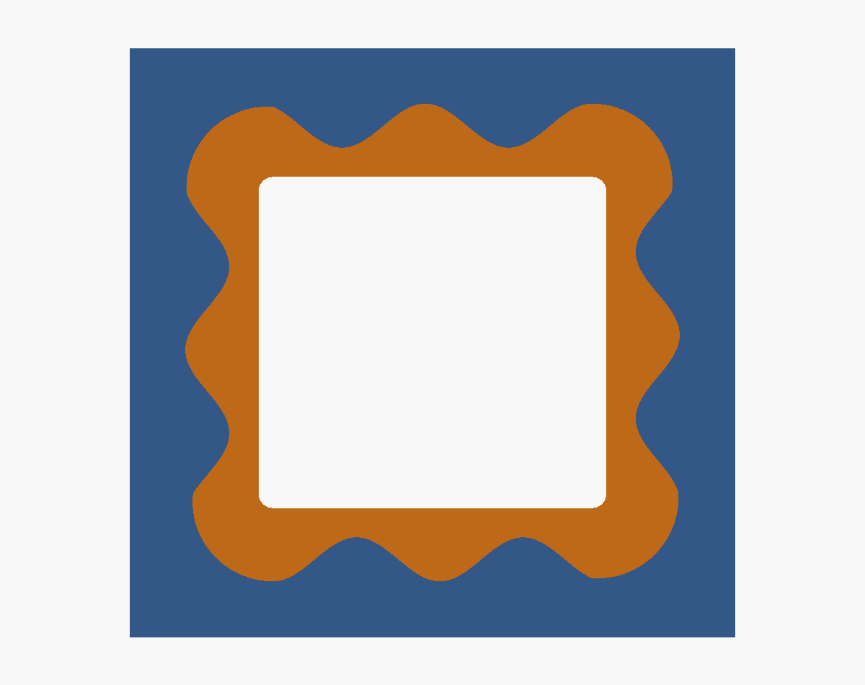
3d-print/mounts/pn532-mount/wave-top.png
