supermadboy/boxbert/3d-print/mounts/sd-mount/bottom.png

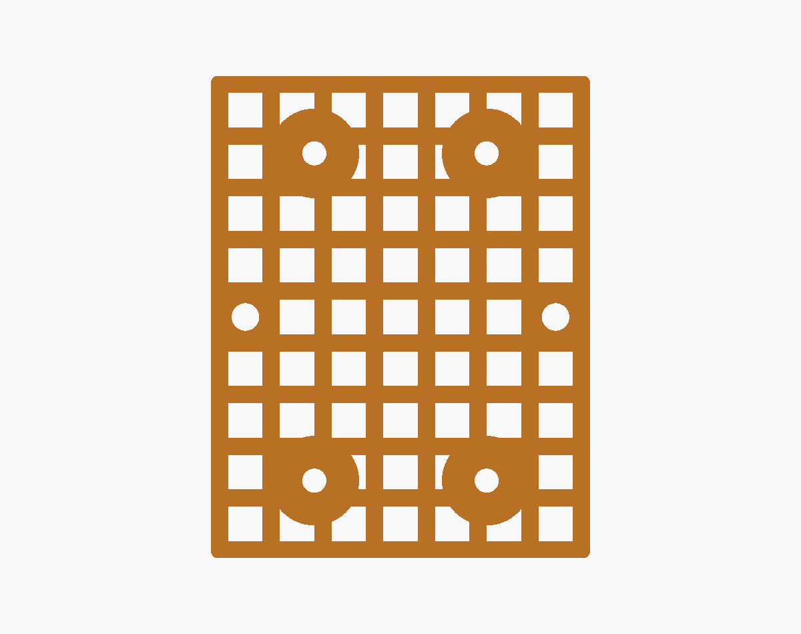
3d-print/mounts/sd-mount/bottom.png
