supermadboy/boxbert/3d-print/mounts/sd-mount/height-side.png

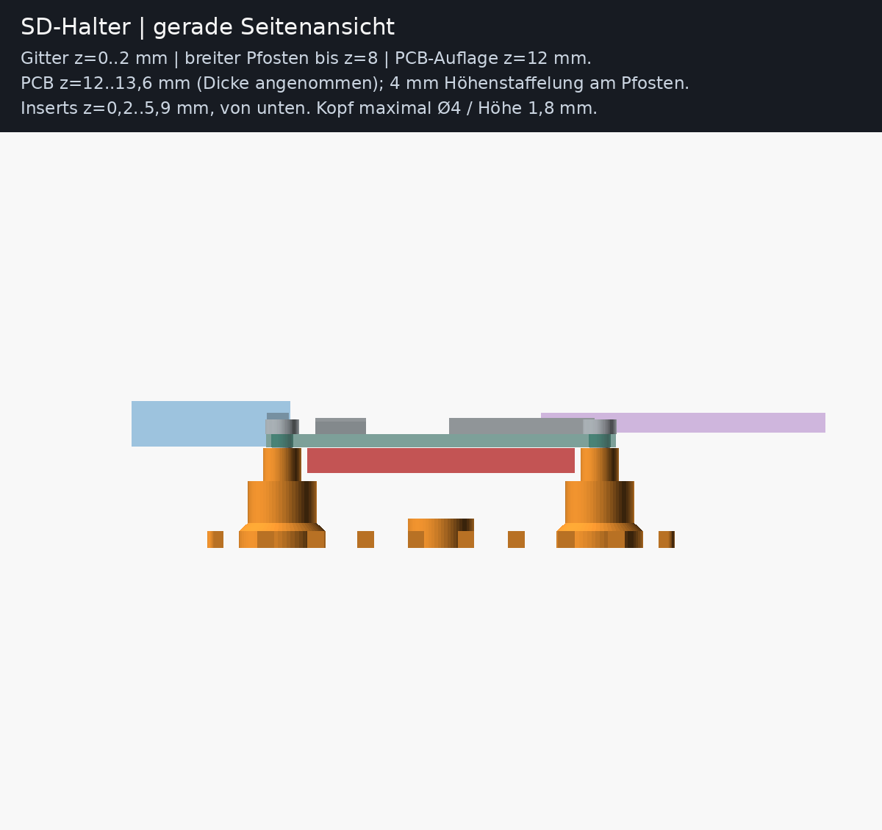
3d-print/mounts/sd-mount/height-side.png
