supermadboy/boxbert/3d-print/mounts/sd-mount/hole-template.png

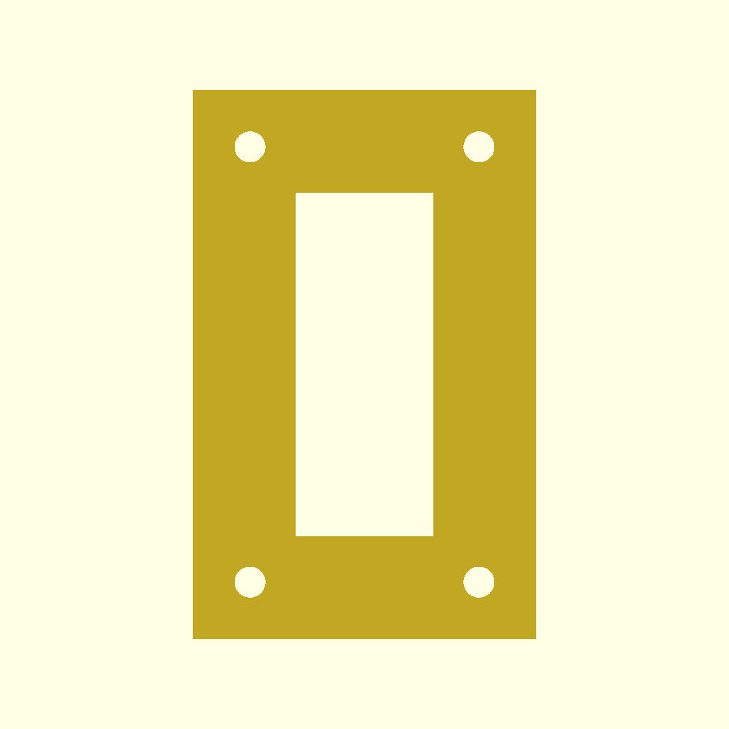
3d-print/mounts/sd-mount/hole-template.png
