supermadboy/boxbert/3d-print/mounts/sd-mount/iso-board.png

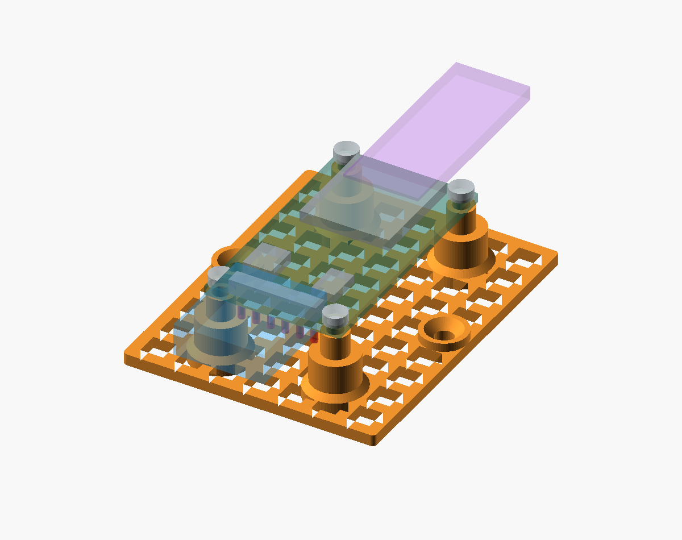
3d-print/mounts/sd-mount/iso-board.png
