supermadboy/boxbert/3d-print/mounts/sd-mount/iso.png

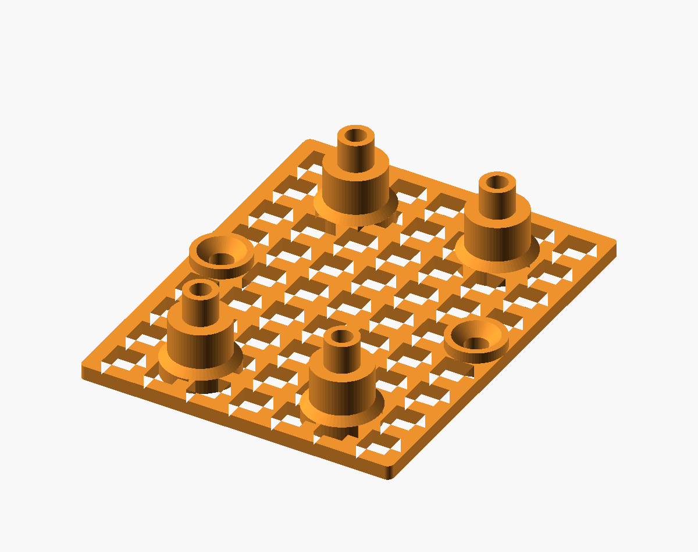
3d-print/mounts/sd-mount/iso.png
