supermadboy/boxbert/3d-print/mounts/sd-mount/side-board.png

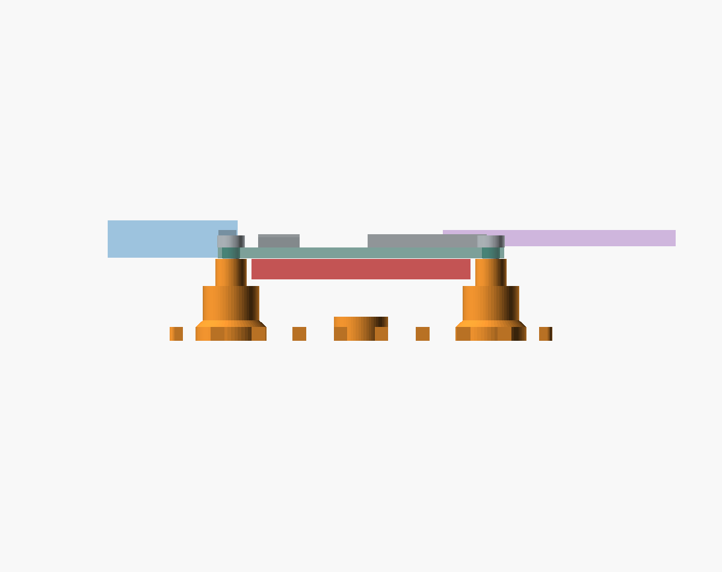
3d-print/mounts/sd-mount/side-board.png
