supermadboy/boxbert/3d-print/mounts/sd-mount/top-board.png

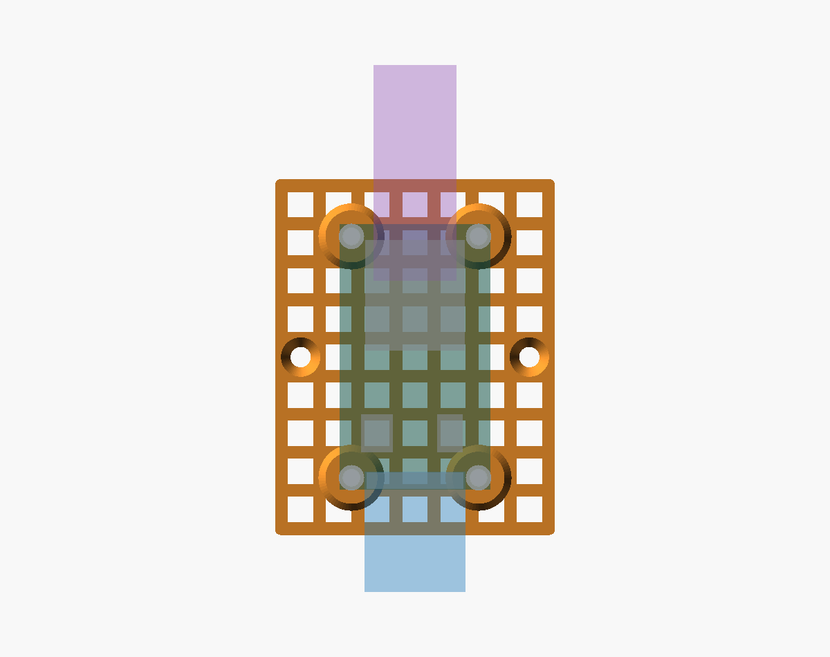
3d-print/mounts/sd-mount/top-board.png
