supermadboy/boxbert/3d-print/mounts/wellenfalz-uebersicht.png

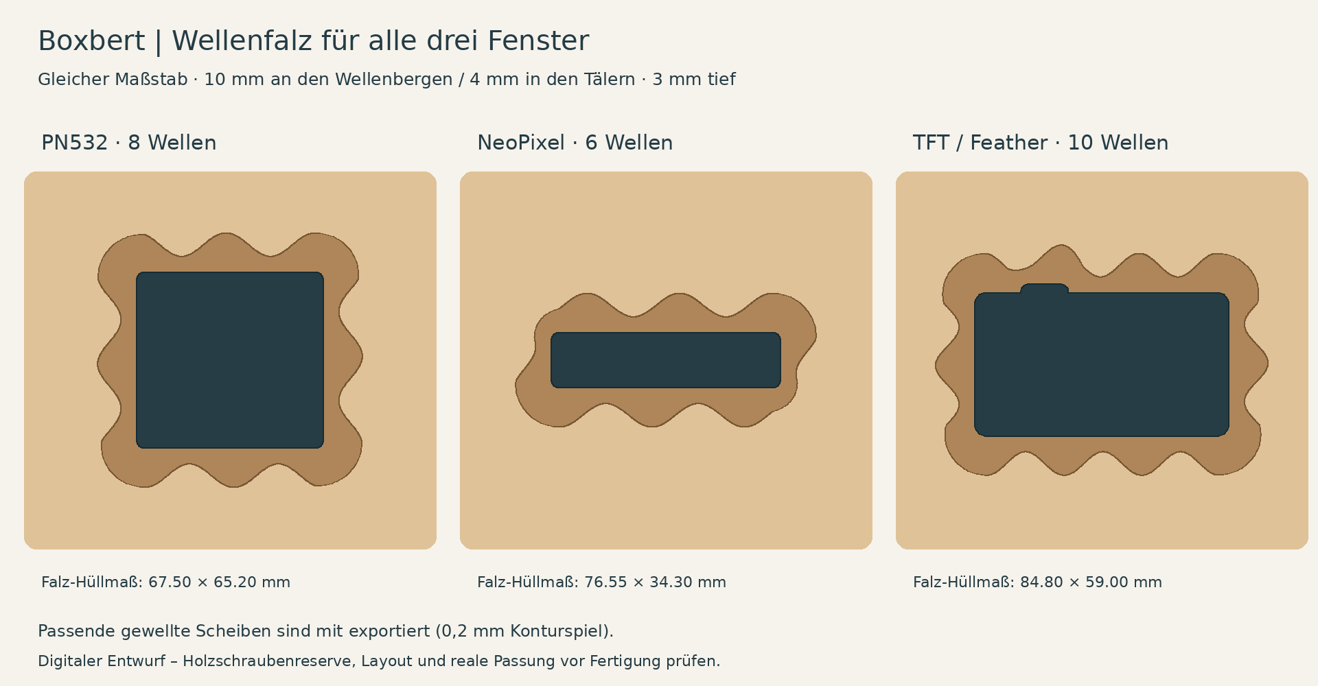
3d-print/mounts/wellenfalz-uebersicht.png
