supermadboy/boxbert/firmware/tests/README.md

# Aktive Breadboard-Referenzen

Historische Breadboard-Referenzen: **04.10.2026, Etappen0–5 bestanden.**
Kein Produktfirmware-Sammelsketch: jede Referenz hat begrenzten Testumfang.
**Aktueller Flash11.11.2026: `firmware/boxbert/` im Diagnose-/Inbetriebnahmeprofil.**
Weiterarbeit: `docs/uebergabe-endaufbau-2026-11-11.md`, aktuelle Pins ausschließlich
`hardware/pinout.md`. Alte Sketche haben teilweise andere Pins und dürfen nicht
ungeprüft auf den Endaufbau geflasht werden.

| Sketch | Zweck / Status |
|---|---|
| etappe0_tft | Board/TFT/WLAN-Scan, Etappe 0 — **Achtung:** nutzt `tft.init(240,135)`, laut Lib-Beispiel falsch (richtig: 135, 240); Abnahmebefund nur eingeschränkt gültig, `docs/findings.md` |
| etappe1_audio_led | I2S-/Testtonreferenz, Etappe 1 |
| etappe2_sd | SD-/Musikreferenz, Etappe 2 |
| etappe2_play | damalige SD-Wiedergabereferenz |
| etappe3_button | Button an IO5, Etappe 3 |
| etappe4_nfc_i2c | unveraenderte PN532-I2C-UID-Einzelreferenz, beide Tags neu reproduziert |
| etappe4_nfc_switch | bestaetigter Timeout-0-Wechselpfad, NFC-only |
| etappe4_tag_player | Etappe-4-Referenz, optimierter Hoertest bestaetigt; seit Etappe-5-Flash nicht mehr auf Board |
| etappe5_web_upload | Breadboard-Abnahme bestanden: WLAN-Station, Handy-Webseite, Dateiliste, Upload, NVS-Zuordnung der zwei bekannten Tags samt RESET-Test; Haertung offen, siehe `docs/testprotokoll-etappe5.md` |
| akku_fuel_gauge | liest onboard MAX17048 (Spannung/SoC/Laderate) am Serial-Monitor; kein NFC/SD/Audio. Werte nicht gesichert, nur Nutzerbestätigung — `docs/testprotokoll-akku.md` |
| etappe7_gesamtmonitor | **damals geflasht (07.10.2026), inzwischen ersetzt**: NFC-Player + TFT-Statusanzeige (Akku/Ladestatus/Lied/Volume/WLAN) + MAX17048-Eigen-Task mit Wire-Mutex, NFC-Timeout 250 ms (Abweichung zur Referenz, siehe Protokoll); kein Web-Upload. Nutzer: „funktioniert alles“ — `docs/testprotokoll-etappe7.md` |

## Endaufbau-Diagnosen11.11.2026

Alle gehören zum tatsächlichen Endaufbau, nicht zur alten Breadboard-Belegung.
Nutzer testet mit Akku+USB; vor Umverdrahten beide Versorgungen abtrennen.
PN532 fehlte bei den ersten Tests, ist inzwischen angeschlossen/Init geprüft;
externer Stick fehlt weiterhin. Umfang und echte Nutzerbestätigungen stehen in
`docs/testprotokoll-endaufbau-inputs.md` und im Gesamtfirmware-Protokoll.

| Sketch | Begrenzter Zweck |
|---|---|
| endaufbau_inputs | Unbekannte Signale passiv erfassen; erst Inputs, dann AW9523 auf0x58 identifiziert; keine unbekannten GPIOs treiben |
| endaufbau_sd | Root/acht Dateianfänge lesen, CS8/SCK36/MOSI35/MISO37; historische400-kHz-/4-MHz-Sketchvarianten, aktuell4MHz |
| endaufbau_audio | Leiser MP3-Decoder-/Hörtest beiVolume1, Stopp nach20s |
| endaufbau_audio_tft | SD+Audio+TFT gemeinsam, Nutzer bestätigt Bild und Ton |
| endaufbau_volume | ISR-Encoder15/14, Taste5, Volume0..6,0 stumm,20-s-Limit; vom Nutzer bestätigt |
| endaufbau_backup | Konfigslots/Legacy-Zuordnung nur lesen; Hostbackup privat außerhalb des Repos |
| endaufbau_nfc_probe | PN532 init-only mit IRQ12 als Eingang, kein Tag-Suchbefehl; PN532/Firmware1.6/SAM geprüft |
| endaufbau_nfc_uid | Eine Suche, v2 akzeptiert fertige Libraryantwort auch ohne nachträgliches IRQ-LOW; CHANGE-Observer zählt während Suche/Auslesen2LOW/2HIGH, UID Tag1 bestätigt; Karte durchgehend aufgelegt |
| endaufbau_nfc_pending | Liest genau eine bereits ausstehende Antwort ohne PN532-Init-/Suchbefehl, checksum-/bounds-geprüfter Parser; setzt erhaltenen Chipzustand voraus, kein allgemeiner UID-Starttest |
| endaufbau_ble_init | USB `b` initialisiert/advertisiert, `d` deinitialisiert; Init2.3.6 vs2.3.8 verglichen; aktueller Sketch enthält zusätzlich Scan-Response und Deinit-/Reinit-Test |

`endaufbau_volume/Quadrature.h` bleibt die getestete Diagnosekopie; produktive
ISR verwendet `firmware/runtime/Quadrature.h`. Erfolgslogs gehören immer zur
angegebenen Sketch-/Library-/Buildvariante, nicht automatisch zum jüngsten Quellstand.

## Etappe4 — historisch gültiger Breadboard-Stand

**Nicht aktuelle Endaufbau-Verdrahtung:** damals SD-CS10, heute CS8.
Die historischen Referenzsketche bleiben unverändert.

PN532 I2C IO3/IO4, VCC 3V3, DIP 1 ON / 2 OFF, 100 kHz; SD SPI
IO36/35/37, CS IO10, VCC USB-5V, im Player 4 MHz; MAX98357A I2S
DIN IO16/BCLK IO17/LRC IO18, VIN USB-5V, SD 3V3, GAIN offen.
Alle Pins aus `hardware/pinout.md`. **Nur USB, Akku ab; vor Umstecken
USB trennen.** HSU-TXD/SDA hatte 4,1 V: nicht direkt an Feather-GPIO.

Der Einzeltest bleibt unveraendert; fuer Wechsel/Integration den
bestaetigten Timeout-0-Pfad verwenden. Im Player blockiert er nur die
NFC-Task, Events gehen per Queue an den Audio-Hauptloop. Erfolgspause
200 ms, Volume 6/21. Gleiche UID ohne zwischenzeitlich andere UID
startet nicht erneut. Kein Tag-Schreiben/Boot-Lied/Fallback/WLAN.

Abnahme ist ein Breadboard-Meilenstein, nicht 20-Wechsel-/Minutenlast-
oder Produktnachweis. Spaetere Haertung in `To-Do.md`; genaue Chronologie,
Messwerte, Nutzerbestaetigungen in `docs/testprotokoll-etappe4.md`.
Host-Test unter `firmware/host-tests/tag_map_test.cpp`.

## Toolchain / Build

arduino-cli 1.5.1, esp32-Core 3.3.12, Adafruit PN532 1.3.4,
BusIO 1.17.4, ESP32-audioI2S 4.0.0. SPI/SD/Wire aus dem Core.
FQBN `esp32:esp32:adafruit_feather_esp32s3_reversetft`, Board-Defaults
mit QSPI-PSRAM, **kein PSRAM=opi**. Reproduzierbarer Compile-/Upload-
Befehl in `docs/dev-setup.md`; nach Compile-Fehler nie altes Binary flashen.

## Historie statt aktiver Diagnosen

- `firmware/archive/etappe4_diagnostics/`: alte SPI-/HSU-/Inventory-
  Experimente als .ino.txt, Status in dortigem README.
- `firmware/archive/etappe4_tag_music/`: verworfener kombinierter Sketch,
  keine Vorlage fuer neue Firmware.
- `firmware/archive/etappe4_tag_player_v1/`: erfolgreicher v1 vor
  Optimierung sowie die beiden Timing-Vergleichsstaende.
- `docs/archive/pinout-etappe4-legacy.md`: verworfene Pinplaene,
  **keine aktuelle Verkabelungsanleitung**.
