supermadboy/boxbert/docs/cad/neopixel-stick/measurement-2026-10-21/README.md

# Nutzer-Messabgleich 21.10.2026

Quelle: Nutzerangaben im Chat zur CNC-/Druckfinalisierung; Foto aus
`~/Downloads/PXL_20261021_175716386.jpg`, hier unverändert gesichert.
Kein Maß aus dem perspektivischen Foto abgeleitet.

- PCB 54 × 9,9 × 1,6 mm.
- PCB-Unterseite bis LED-Oberseite 3,23 mm → LED-Aufbauhöhe 1,63 mm.
- Zwei Bohrungen Ø3 mm.
- Rechtes Loch: rechter Lochrand bis rechtes PCB-Ende 12,8 mm.
- Freier Abstand zwischen den Löchern 23 mm, ausdrücklich bestätigt.
- Lochrand bis nahe lange PCB-Kante 0,7 mm.
- Daraus Mittelpunkte bei (13,7;7,7) und (39,7;7,7), Koordinaten:
  x nach rechts, y zur hinteren Lochreihe; Abstand 26 mm.
- Foto bestätigt die Anordnung an der hinteren Deckelkante, nicht deren
  exakte Lage oder Abstände zu Wänden/Leisten. Keine DIN-Netzidentifikation
  aus dem Foto; Beschriftung beim Verdrahten prüfen.
- Nach zunächst gewünschtem Erhalt der Stiftleiste entscheidet der Nutzer
  ausdrücklich für direkt angelötete Kabel. Auftrag zur Umsetzung bestätigt.
  Stiftleiste muss daher vor Montage entfernt werden; noch nicht geschehen.
- Anschließende Nutzerkorrektur zu den beiden Holz-Schraublaschen: zunächst
  „nach unten“, dann ausdrücklich präzisiert **„auf dem Foto nach links“**.
  Beide auf die Lochreihenseite / zur Deckelmitte, lokal+Y versetzt; ersetzt
  die bisherige Anordnung auf der anderen langen Seite. Kein neues Maß oder
  neuer gemessener Wandabstand daraus abgeleitet.
- Nächste Nutzerkorrektur: „kabel falsche seite, die muessen auf die andere“.
  Kabelausgang und Zugentlastung daher auf die andere kurze Seite (+x/rechts
  im Modell) verlegt, ohne die Holzlaschen erneut zu verändern. Keine
  elektrische Pad-/DIN-Belegung aus dieser mechanischen Vorgabe abgeleitet.

LED-/SMD-XY, Padkoordinaten, Lot-/Kabelhüllen, Schrauben, Muttern und
Deckel-/Glasdicken wurden nicht gemessen. Die Vorschau nutzt für Bauteil-XY
weiterhin angepasste Referenzkoordinaten; kein Original-PCB-Nachweis.
Die ursprünglichen Adafruit-Quelldaten bleiben historische Referenz und
belegen NICHT die Maße des gelieferten Moduls.
