supermadboy/boxbert/docs/cad/neopixel-stick/measurement-2026-10-21/PXL_20261021_175716386.jpg

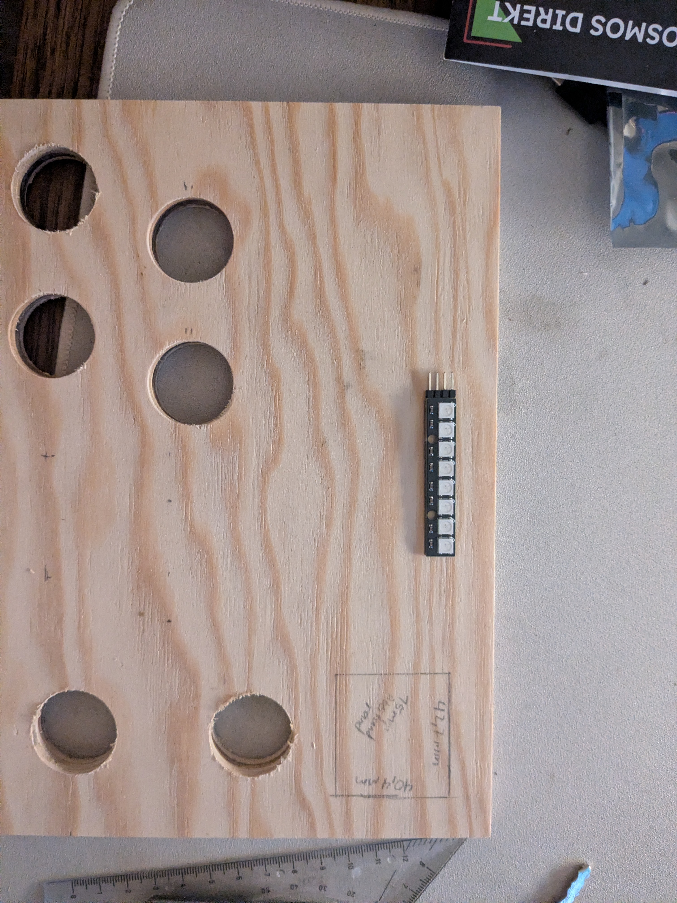
docs/cad/neopixel-stick/measurement-2026-10-21/PXL_20261021_175716386.jpg
