supermadboy/boxbert/firmware/boxbert/UnicodeNfcData.h

#pragma once
#include <cstdint>
// Generated from Python unicodedata 15.0.0; canonical NFC data, not fabricated mappings.
namespace boxbert::integrated::unicode {
struct Decomposition {uint32_t cp,a,b;};
inline constexpr Decomposition decompositions[]={
{0xc0,0x41,0x300},
{0xc1,0x41,0x301},
{0xc2,0x41,0x302},
{0xc3,0x41,0x303},
{0xc4,0x41,0x308},
{0xc5,0x41,0x30a},
{0xc7,0x43,0x327},
{0xc8,0x45,0x300},
{0xc9,0x45,0x301},
{0xca,0x45,0x302},
{0xcb,0x45,0x308},
{0xcc,0x49,0x300},
{0xcd,0x49,0x301},
{0xce,0x49,0x302},
{0xcf,0x49,0x308},
{0xd1,0x4e,0x303},
{0xd2,0x4f,0x300},
{0xd3,0x4f,0x301},
{0xd4,0x4f,0x302},
{0xd5,0x4f,0x303},
{0xd6,0x4f,0x308},
{0xd9,0x55,0x300},
{0xda,0x55,0x301},
{0xdb,0x55,0x302},
{0xdc,0x55,0x308},
{0xdd,0x59,0x301},
{0xe0,0x61,0x300},
{0xe1,0x61,0x301},
{0xe2,0x61,0x302},
{0xe3,0x61,0x303},
{0xe4,0x61,0x308},
{0xe5,0x61,0x30a},
{0xe7,0x63,0x327},
{0xe8,0x65,0x300},
{0xe9,0x65,0x301},
{0xea,0x65,0x302},
{0xeb,0x65,0x308},
{0xec,0x69,0x300},
{0xed,0x69,0x301},
{0xee,0x69,0x302},
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
};
struct Combining {uint32_t cp;uint8_t value;};
inline constexpr Combining classes[]={
{0x300,230},
{0x301,230},
{0x302,230},
{0x303,230},
{0x304,230},
{0x305,230},
{0x306,230},
{0x307,230},
{0x308,230},
{0x309,230},
{0x30a,230},
{0x30b,230},
{0x30c,230},
{0x30d,230},
{0x30e,230},
{0x30f,230},
{0x310,230},
{0x311,230},
{0x312,230},
{0x313,230},
{0x314,230},
{0x315,232},
{0x316,220},
{0x317,220},
{0x318,220},
{0x319,220},
{0x31a,232},
{0x31b,216},
{0x31c,220},
{0x31d,220},
{0x31e,220},
{0x31f,220},
{0x320,220},
{0x321,202},
{0x322,202},
{0x323,220},
{0x324,220},
{0x325,220},
{0x326,220},
{0x327,202},
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
};
struct Composition {uint32_t a,b,cp;};
inline constexpr Composition compositions[]={
{0x3c,0x338,0x226e},
{0x3d,0x338,0x2260},
{0x3e,0x338,0x226f},
{0x41,0x300,0xc0},
{0x41,0x301,0xc1},
{0x41,0x302,0xc2},
{0x41,0x303,0xc3},
{0x41,0x304,0x100},
{0x41,0x306,0x102},
{0x41,0x307,0x226},
{0x41,0x308,0xc4},
{0x41,0x309,0x1ea2},
{0x41,0x30a,0xc5},
{0x41,0x30c,0x1cd},
{0x41,0x30f,0x200},
{0x41,0x311,0x202},
{0x41,0x323,0x1ea0},
{0x41,0x325,0x1e00},
{0x41,0x328,0x104},
{0x42,0x307,0x1e02},
{0x42,0x323,0x1e04},
{0x42,0x331,0x1e06},
{0x43,0x301,0x106},
{0x43,0x302,0x108},
{0x43,0x307,0x10a},
{0x43,0x30c,0x10c},
{0x43,0x327,0xc7},
{0x44,0x307,0x1e0a},
{0x44,0x30c,0x10e},
{0x44,0x323,0x1e0c},
{0x44,0x327,0x1e10},
{0x44,0x32d,0x1e12},
{0x44,0x331,0x1e0e},
{0x45,0x300,0xc8},
{0x45,0x301,0xc9},
{0x45,0x302,0xca},
{0x45,0x303,0x1ebc},
{0x45,0x304,0x112},
{0x45,0x306,0x114},
{0x45,0x307,0x116},
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
};
}
