supermadboy/boxbert/firmware/tests/endaufbau_volume/endaufbau_volume.ino

// Endaufbau encoder volume diagnostic 2026-11-11, based on audio+TFT.
// Temporary cap 6/21; no configuration writes; held button must be released first.
// TFT init checked against library example and docs/findings.md (135,240).
// SD verified CS8/SCK36/MOSI35/MISO37 at 4 MHz; I2S user checked DIN16/BCLK17/LRC18.
// Library API checked against installed audioI2S 4.0.0 examples/I2Saudio_SD.
// User-confirmed encoder switch IO5. Volume 1/21, manual start, max 20 s.
#include <Arduino.h>
#include <Audio.h>
#include <SPI.h>
#include <SD.h>
#include <Adafruit_GFX.h>
#include <Adafruit_ST7789.h>
#include <driver/gpio.h>
#include "Quadrature.h"
Audio audio;
Adafruit_ST7789 tft(&SPI,TFT_CS,TFT_DC,TFT_RST);
uint32_t frames=0;
void drawDisplay();
String song;
bool sdReady=false,audioReady=false,active=false;
uint32_t started=0;
uint8_t Volume=1;
bool buttonArmed=false;
portMUX_TYPE encoderMux=portMUX_INITIALIZER_UNLOCKED;
volatile int encoderEdges=0;
volatile uint8_t encoderState=3;
void IRAM_ATTR encoderEdge(){
 portENTER_CRITICAL_ISR(&encoderMux);
 uint8_t current=(gpio_get_level(GPIO_NUM_15)<<1)|gpio_get_level(GPIO_NUM_14);
 encoderEdges+=volume_diag::transition(encoderState,current);
 encoderState=current;
 portEXIT_CRITICAL_ISR(&encoderMux);
}
void updateVolume(){
 portENTER_CRITICAL(&encoderMux);
 int steps=encoderEdges/4;
 encoderEdges-=steps*4;
 portEXIT_CRITICAL(&encoderMux);
 if(!steps)return;
 uint8_t next=volume_diag::boundedVolume(Volume,steps);
 if(next!=Volume){
  Volume=next;audio.setVolume(Volume);
  Serial.printf("VOLUME steps=%d requested=%u actual=%u cap=6/21\n",steps,Volume,audio.getVolume());
 }
}
void status(){
 Serial.printf("[STATUS %lu] VOLUME-DIAG v1 SD=%d PSRAM=%d I2S=%d active=%d running=%d time=%lu volume=%u file=%s\n",(unsigned long)millis(),sdReady,psramFound(),audioReady,active,audio.isRunning(),(unsigned long)audio.getAudioCurrentTime(),Volume,song.c_str());
 Serial.printf("TFT frames=%lu size=%dx%d\n",(unsigned long)frames,tft.width(),tft.height());
}
void audioInfo(Audio::msg_t m){
 if(m.e==Audio::evt_vu||m.e==Audio::evt_spectrum)return;
 Serial.printf("[audio] %s: %s\n",m.s?m.s:"?",m.msg?m.msg:"");
}
void setup(){
 Serial.begin(115200);
 pinMode(9,INPUT); // no active boost-EN control
 pinMode(5,INPUT_PULLUP);
 pinMode(15,INPUT_PULLUP);pinMode(14,INPUT_PULLUP);
 encoderState=(digitalRead(15)<<1)|digitalRead(14);
 attachInterrupt(digitalPinToInterrupt(15),encoderEdge,CHANGE);
 attachInterrupt(digitalPinToInterrupt(14),encoderEdge,CHANGE);
 pinMode(TFT_BACKLITE,OUTPUT);digitalWrite(TFT_BACKLITE,LOW);
 pinMode(TFT_CS,OUTPUT);digitalWrite(TFT_CS,HIGH);
 pinMode(8,OUTPUT);digitalWrite(8,HIGH);
 uint32_t wait=millis();while(!Serial&&millis()-wait<2000)delay(10);
 Serial.println("Boxbert VOLUME-DIAG v1; turn CW louder/CCW quieter; volume 0..6/21; max 20s");
 SPI.begin(36,37,35,8);
 tft.init(135,240);tft.setRotation(1);tft.fillScreen(ST77XX_BLACK);
 tft.setTextWrap(false);
 tft.drawRect(0,0,240,135,ST77XX_GREEN);
 tft.fillRect(0,0,5,5,ST77XX_RED);tft.fillRect(235,0,5,5,ST77XX_GREEN);
 tft.fillRect(0,130,5,5,ST77XX_BLUE);tft.fillRect(235,130,5,5,ST77XX_WHITE);
 tft.setTextColor(ST77XX_WHITE);tft.setTextSize(2);tft.setCursor(8,8);tft.print("Lautstaerke Test");
 digitalWrite(TFT_BACKLITE,HIGH);
 sdReady=SD.begin(8,SPI,4000000)&&SD.cardType()!=CARD_NONE;
 if(sdReady){
  File root=SD.open("/",FILE_READ);
  if(root&&root.isDirectory()){
   for(;;){File f=root.openNextFile(FILE_READ);if(!f)break;
    String name=f.name(),lower=name;lower.toLowerCase();
    bool match=!f.isDirectory()&&f.size()>0&&lower.endsWith(".mp3");
    if(match){song=name.startsWith("/")?name:"/"+name;f.close();break;}f.close();
   }
  }
  root.close();
 }
 Audio::audio_info_callback=audioInfo;
 audioReady=psramFound()&&audio.setPinout(17,18,16);
 audio.setVolume(Volume);
 status();
}
void drawDisplay(){
 tft.fillRect(6,34,228,90,ST77XX_BLACK);
 tft.setTextSize(1);tft.setTextColor(sdReady?ST77XX_GREEN:ST77XX_RED);tft.setCursor(8,36);
 tft.printf("SD: %s | PSRAM: %s",sdReady?"OK":"FEHLER",psramFound()?"OK":"FEHLER");
 tft.setTextColor(ST77XX_WHITE);tft.setCursor(8,53);tft.print(song.substring(0,36));
 tft.setTextSize(2);tft.setCursor(8,71);
 tft.setTextColor(audio.isRunning()?ST77XX_GREEN:ST77XX_YELLOW);
 tft.printf("%s %lus",audio.isRunning()?"SPIELT":"BEREIT",(unsigned long)audio.getAudioCurrentTime());
 tft.setTextSize(1);tft.setTextColor(ST77XX_WHITE);tft.setCursor(8,96);tft.printf("Vol %u/21 | Testlimit 6 | %s",Volume,Volume?"":"STUMM");
 tft.setCursor(8,112);tft.printf("Bild %lu | max. 20s",(unsigned long)++frames);
}
void loop(){
 if(audioReady)audio.loop();
 if(audioReady)updateVolume();
 uint32_t now=millis();
 static bool candidate=true,stable=true;
 static uint32_t changed=0,lastStatus=0;
 bool value=digitalRead(5);
 if(value&&!buttonArmed){buttonArmed=true;candidate=stable=true;changed=now;}
 if(value!=candidate){candidate=value;changed=now;}
 if(value!=stable&&uint32_t(now-changed)>=30){
  stable=value;
  if(!value&&buttonArmed){
   if(active){audio.stopSong();active=false;Serial.println("Manual STOP");}
   else if(sdReady&&audioReady&&!song.isEmpty()){
    audio.setVolume(Volume);active=audio.connecttoFS(SD,song.c_str());started=millis();
    Serial.printf("Manual START connect=%d volume=%u file=%s\n",active,Volume,song.c_str());
   }else Serial.println("Not ready: SD/I2S/MP3 missing");
  }
 }
 if(active&&uint32_t(millis()-started)>=20000){audio.stopSong();active=false;Serial.println("20-second limit: STOP");}
 static uint32_t lastDraw=0;
 if(uint32_t(now-lastDraw)>=250){lastDraw=now;drawDisplay();}
 if(uint32_t(now-lastStatus)>=5000){lastStatus=now;status();}
 delay(1);
}
