supermadboy/boxbert/firmware/tests/etappe5_web_upload/Secrets.example.h

#pragma once
// Copy to Secrets.h in this directory. Secrets.h is git-ignored.
// Use an existing, trusted 2.4 GHz WLAN; never commit real credentials.
#define BOXBERT_WIFI_SSID "YOUR_WIFI_NAME"
#define BOXBERT_WIFI_PASSWORD "YOUR_WIFI_PASSWORD"
#define BOXBERT_WEB_PASSWORD "CHOOSE_A_LONG_UNIQUE_PASSWORD"
