supermadboy/boxbert/(commit log)

2026-10-01 Boxbert aus ai-habibi herausgelöst — Initialstand
    BOM, Pinout, Entscheidungen, Preisvergleich, Bestellliste,
    Breadboard-Testplan, Kernwerte, Datenblätter (Berry-Base-Bestellung
    27.09.2026). 3d-print/, firmware/, app/ noch leere Platzhalter.
2026-10-02 Etappe 0 bestanden: Dev-Setup (arduino-cli, uucp, native USB) + TFT-Test-Sketch
    WiFiScan + TFT laufen; Protokoll in docs/dev-setup.md.
2026-10-02 Etappe 1 bestanden: I2S + MAX98357A-Klon am Breadboard
    - Sketch v2 mit i2s.setPins() — v1 lief ohne setPins() gruen durch und
    blieb stumm (GPIO-Matrix nicht verbunden), siehe Protokoll
    - Klon-Modul: andere Pinreihenfolge als ADA3006 (VIN/GND/SD/GAIN/DIN/BCLK/LRC),
    SD an 3V3 erzeugt Mono-Modus (Datenblatt-Schwellwerte)
    - Hoertest AMP 10-32000 vermessen; Software-Deckel MAX_AMP ~6000-8000
    wegen EN 71-1 (85 dB(A) Spielzeug) vereinbart
    - docs/findings.md + kernwerte.md + Fehler-Checkliste in AGENTS.md ergaenzt
2026-10-02 Etappe 2 bestanden: SD-Karte am SPI-Bus + mp3-Wiedergabe
    - etappe2_sd: Dateiliste; etappe2_play: ESP32-audioI2S v4, PSRAM-Default
    (QSPI) — manuelles opi-Build kompiliert, aber PSRAM-Mismatch bricht
    connecttoFS()
    - Volume-Skala vermessen: 6 leise-schoen, 21 max; Firmware-Deckel spaeter ~10
    - Protokoll: docs/testprotokoll-etappe2.md
2026-10-02 Etappe 3: Button-Test-Sketch (IO5 -> subbasesoft.mp3)
    Button an IO5 (INPUT_PULLUP, andere Seite GND), fallende Flanke mit
    20-ms-Entprellen, bricht den Boot-Loop (arcade-music-loop.mp3) ab und
    spielt subbasesoft.mp3. NeoPixel zeigt Status (blau=Boot, gruen=laeuft).
    Volume per Hoertest von 6 auf 12 erhoeht.
2026-10-02 Etappe 3 bestanden: Button an IO5 loest Wiedergabe aus
    Testprotokoll mit Messwerten (20-ms-Entprellen ohne Doppel-Trigger,
    Volume-Hoertest 6 -> 12, Pups 2,9 s). To-Do.md abgehakt, naechste
    Etappe ist 4 (PN532 am geteilten SPI-Bus).
2026-10-04 feat: Etappe 4 mit I2C-Tag-Player abschliessen
    Neuen Zwei-Tag-/SD-/I2S-Player mit NFC-Task, exaktem UID-Mapping und Host-Test sichern. SD-Takt und NFC-Pause separat optimieren; gemessene Startzeiten und bestaetigten Nutzer-Hoertest dokumentieren.
    Aktive Referenzen von historischen SPI-/HSU-/Inventory-Diagnosen trennen, Pinplan und Hauptdokumentation auf I2C aktualisieren. Breadboard-Abnahme abschliessen, nicht durchgefuehrte Dauer-/Produkthaertung als spaetere Aufgaben erhalten.
2026-10-04 docs: Hardwarebestand und sichere Ausbauanleitungen bereinigen
    BOM und Entscheidungen auf vorhandene Teile aktualisieren, alte Auswahlplaene archivieren und Quellenzustaendigkeiten fuer Agenten festlegen.
    AW9523-VIN/LED-Modi und getrennte Power-Rails anhand Herstellerquellen klaeren. Nicht freigegebene LED-/Sleep-Schaltungen, fehlende Button-Tests und akustische Bewertung explizit als offen dokumentieren; keine Normgarantie aus Volume/MAX_AMP ableiten.
2026-10-07 feat: Etappe-6-Breadboard-Sketches AW9523 und NeoPixel
    Separate Test-Sketches zum Etappe-6-Teilprogramm: AW9523-I2C-Scan (0x58),
    AW9523-Diagnose (Register-Map-Fehlversuch dokumentiert), AW9523-Taster
    an A0 mit externem 10-k-Pull-up, NeoPixel-Stick Minimal-Rot (8 Pixel).
    Jeder Sketch ein begrenzter Testumfang, Referenzen bleiben unangetastet.
2026-10-07 docs: Etappe-6-Testprotokoll mit Rohlogs
    Breadboard-Teilprogramm bestanden: AW9523-Scan/Taster, NeoPixel
    Minimal-Rot, DT44L12 an 5 V klar sichtbar, Boost isoliert (EN/True
    Disconnect/5,2 V unbelastet). Rohlogs in docs/serial/ mit Datum.
    Ausgeschlossene Reste und offene Punkte im Protokoll.
2026-10-07 docs: Etappe-6-Status in Fahrplan, Findings und Kernwerten
    Breadboard-Teilprogramm als bestanden mit Ausnahmen eingetragen
    (breadboard-testing). Findings: Register-Map nicht aus dem Gedaechtnis
    (INTENABLE0/GCR statt INPUT0/LEDMODE gelesen), LED klemmt Eingangspin
    unter Pull-up, Breakout hat 17 VIN-Pads. Kernwerte: DT44L12 leuchtet
    an 5 V klar sichtbar (Nutzer, 07.10.2026), Strom noch ungemessen.
2026-10-07 docs: Rails-Feinplanung im Power-Plan konkretisieren
    Rail-Tabelle je Verbraucher (Versorgung, Abschaltung, Grenzen),
    Optionsentscheidung A (PN532-Abschaltung: IO7-Rail vs. P-Kanal-MOSFET)
    und B (Boost-EN: IO39 ist kein RTC-GPIO, Empfehlung IO9 mit
    rtc_gpio_hold_en). Offene elektrische Pruefungen vor Umsetzung
    (AW9523-Portgrenzen, LED-Stroeme, Rueckspeisung, Gesamt-Sleep-Strom).
    Rail-Merksatz ergaenzt: BAT = Energiequelle, 3V3 = Logik, Boost-Ausgang
    = Leistung; Boost-Eingang künftig direkt an der Akku-JST-Buchse
    abgreifen, nicht ueber den BAT-Header-Pin.
2026-10-07 feat: Ersten Akku-Anschluss bestanden und Fuel-Gauge-Test-Sketch
    LiPo 3000 mAh (Soldered SOL-333286) erstmalig angeschlossen: Polung
    vorher gegen Feather-JST geprueft, laeuft an USB + Akku, laedt, bleibt
    kuehl (Nutzer, 07.10.2026). Separater Test-Sketch akku_fuel_gauge liest
    den onboard MAX17048 (Spannung/SoC/Laderate, Adafruit MAX1704X 1.0.3,
    I2C SDA=IO3/SCL=IO4 gegengeprueft). Keine Rohwerte gesichert — nur
    Nutzerbeobachtung; offene Punkte im Protokoll. Referenztabelle in
    firmware/tests aktualisiert: Board laeuft aktuell auf dem Gauge-Sketch,
    nicht auf dem Etappe-4-Player.
2026-10-07 feat: Etappe-7-Gesamtmonitor mit TFT-Statusanzeige
    Integrations-Test: NFC-Tag-Player (Logik aus etappe4_tag_player) plus
    TFT-Anzeige (Akku %, Ladestatus, Spannung, WLAN SSID/IP, aktuelles Lied,
    Volume, STARTS/ERR/uptime), onboard MAX17048 im eigenen Task mit
    Wire-Mutex (PN532 und Gauge teilen SDA=IO3/SCL=IO4), WLAN-STA wie
    Etappe 5 (Secrets.h git-ignored). Bewusste Abweichungen dokumentiert:
    NFC-Timeout 250 ms statt 0 (damit Gauge an den Bus kann), kein Web-
    Upload (separat bestanden in Etappe 5). TFT-Init korrigiert: init(135,
    240) statt (240, 135) — siehe Lib-Beispiel und docs/findings.md.
2026-10-07 docs: Etappe-7-Protokoll und TFT-Init-Finding
    Protokoll mit Umfang, dokumentierten Abweichungen (NFC-Timeout 250 ms,
    Wire-Mutex, keine Fehlertrennung im Monitorbetrieb) und offenen Punkten
    (Tagwechsel unter Gauge-Last, Akku-only, Gauge-Gegenpruefung). Finding:
    tft.init(135, 240) statt (240, 135) — GRAM-Offsets nur damit korrekt;
    Etappe-0-Referenz betroffen, Abnahmebefund 'TFT ok' nur eingeschraenkt
    gueltig (docs/findings.md, Abschnitt TFT). Referenztabelle und To-Do
    aktualisiert.
2026-10-07 docs: Rails-Entscheidungen — PN532 bleibt an 3V3, Boost-EN auf IO9
    Nutzerentscheidung 07.10.2026: Option A (PN532-Abschaltung) verworfen,
    PN532 dauerhaft am 3V3-Header; bekannte Folge dokumentiert (Standby
    10–13 mA, Schlaf-Laufzeit ~10–12 Tage bei 3000 mAh, Hauptschalter als
    Null-Strom-Weg). Option B1 angenommen: Boost-EN an IO9 (RTC-faehig,
    rtc_gpio_hold_en), Verifikationstest im Rail-Zusammenbau. Auto-Sleep
    nach 5 min ohne Interaktion definiert; Wake-Quellen offen (Tag weckt
    nicht aus Deep Sleep — Button-Wake empfohlen, IRQ-Variante spaeter).
2026-10-07 docs: Wake-Strategie Hybrid — Button-Wake jetzt, PN532-IRQ auf IO11 spaeter
    Nutzerentscheidung 07.10.2026: Wake im Deep Sleep vorerst nur per
    Wake-Button (IO5/IO6), IO11 als RTC-GPIO reserviert fuer die spaetere
    PN532-IRQ-Erweiterung (Low-Power-Card-Detection, dann weckt das Tag
    direkt). pinout.md aktualisiert (IO11 nicht als Wake-Button belegen),
    Etappe-8-Planung in To-Do aufgenommen.
2026-10-07 docs: Verkabelungsplan fuer den Endaufbau + pinout auf Boost-EN IO9 korrigiert
    Neu: hardware/verkabelung-endaufbau.md — Rails, Feather-Header-Gesamt-
    belegung, PN532/AW9523-Portplan, NeoPixel, Speaker, Werkstatt-Tipps und
    Abnahme-Reihenfolge; bestätigt/geplant/offen sauber getrennt (LED-Rail-
    Portgrenzen und Boost-Lasttests bleiben offen). pinout.md: Boost-EN-
    Zeile auf IO9 korrigiert (Decision B1, IO39 ist kein RTC-GPIO), frei-
    Zeile angepasst.
2026-10-07 docs: Verkabelungsplan erweitert — alle Schalter angeschlossen
    Nutzerwunsch: alle Buttons, beide Kippschalter und Encoder verdrahten.
    Port-Budget geloest durch 3 Eingaenge an freie Feather-GPIOs: IO38
    (Kippschalter 2), IO39 (AB24OL-Button 1), IO13 (AB24OL-Button 2, Onboard-
    LED-Quirk dokumentiert). AW9523-Belegung: 9 Schalter + 6 LED-Kathoden =
    15/16 Ports, P17 Reserve. Encoder-Abschnitt ergaenzt (A/B/SW IO15/14/12,
    Pull-ups nach 3V3, Modul-VCC 3V3 wegen Pegel).
2026-10-07 docs: Keine Button-LEDs — NeoPixel uebernimmt alle visuellen Signale
    Nutzerentscheidung 07.10.2026: 44-mm-/30-mm-LED-Einheiten bleiben
    unverbunden, 5-V-LED-Rail entfaellt (damit auch der offene AW9523-LED-
    Portgrenzen-Test). AW9523-Belegung: nur 9 Schalter, P11–P17 frei.
    Abnahme-Reihenfolge ohne LED-Rail-Schritt angepasst.
2026-10-07 docs: Pin-Gesamtuebersicht Feather/AW9523 im Verkabelungsplan gesichert
    Fazit ergaenzt: Feather zu 100% belegt (IO11 reserviert PN532-IRQ),
    Erweiterungen nur noch ueber AW9523; Amp SD/Mode-Pin-Hinweis (3V3) und
    Warnung vor unverifiziertem DB-Pad. AGENTS offene 44-mm-LED-Frage
    geschlossen: keine Button-LEDs, NeoPixel uebernimmt visuelle Signale.
2026-10-09 docs: Gehäusekonzept festhalten und ersten Mount-Entwurf verwerfen
2026-10-10 cad: Step-Up-Gittermount mit Senkkopfaufnahme neu aufbauen
2026-10-10 cad: AW9523-Mount mit gestuften Pfosten neu entwerfen
2026-10-10 cad: Akkuhalter mit Gitterbasis und Schraubbuegel vorschlagen
2026-10-10 cad: HW-125-Lochschablone zur SD-Mount-Vorbereitung erstellen
2026-10-10 cad: MAX98357A-Mount entwerfen und ADA3006-Identifikation korrigieren
2026-10-10 cad: Feather-Fenstermount mit Anschlussfreiraum erstellen
2026-10-10 docs: Mount-Entscheidungen, Bauteilmechanik und CAD-Uebergabe festhalten
2026-10-10 Beschlossenen Lautsprechereinbau für die Gehäuseplanung festhalten
2026-10-10 Kabelführung und Verdrillen als Aufbau-Merkhilfe festhalten
2026-10-10 Ideen einzeln pro Session besprechbar und dauerhaft nachvollziehbar machen
2026-10-10 Freigegebene Spiel- und Einschlafideen für spätere Besprechungen sichern
2026-10-10 SD-Firmware-Archiv als spätere Option erhalten und Besprechung abschließen
2026-10-10 Funkmodi festhalten, damit Bedienung und Machbarkeitsprüfung getrennt bleiben
2026-10-10 Funkarchitektur und Speichergrenzen klären, bevor die PWA gebaut wird
2026-10-11 Boxbert-Bedienung mit grafischen Sounds und verständlichen Tag-Namen erproben
2026-10-11 Boxbert ohne Scrollsuche bedienen und LED-Effekte unabhängig kombinieren
2026-10-11 Figurenintros direkt aufnehmen statt aus der Bibliothek zu wählen
2026-10-11 Figurenintros mit sichtbarer Dauer und klarer Sprachaufnahmebedienung abschließen
2026-10-15 Steckzugang auf die Vormontage des Feather-Trägers begrenzen
2026-10-15 Frontseitigen Reset-Taster bei der Glasprüfung berücksichtigen
2026-10-15 Außenfräsung und 2-mm-TFT-Abstand als Mount-Referenz festhalten
2026-10-15 NeoPixel-Mount vor falschen Lochmaßen schützen und Quellen sichern
2026-10-15 Rückseitenfoto klärt die NeoPixel-Einbaurichtung
2026-10-15 Schraubenspiel und Gewindereserve im NeoPixel-Halter berücksichtigen
2026-10-15 NeoPixel-Ausschnitt ohne Änderung der Einbautiefe enger fassen
2026-10-15 NFC-Lesefläche mit gemeinsam passendem Plexiglasfalz und Halter vorbereiten
2026-10-16 Fertigungslücken vor dem Drucken und Fräsen belegbar festhalten
2026-10-16 SD-Halter vervollständigen und Fertigung mit echten Exportprüfungen absichern
2026-10-16 TFT-Entwurf vor dem Endaufbau in der App beurteilbar machen
2026-10-16 TFT-Status wie am Handy zeigen und spätere Portierung vereinfachen
2026-10-16 TFT-Basis und Animation über mehrere Sessions belastbar vorbereiten
2026-10-17 TFT-Vorschau und Gerätebasis auf dieselben Pixel stützen
2026-10-18 V1-Abschluss festhalten und Geräteintegration von V2 entkoppeln
2026-10-18 Boxbert mit reproduzierbaren TFT-Frames beleben und V1 als Rückfall erhalten
2026-10-19 Gesamtgerät statt getrennter Demos mit BLE und WLAN bedienbar machen
2026-10-21 ESP-Fenster: Druck- und CNC-Dateistand für Fertigung festhalten
2026-10-21 PN532-Halter an Messwerte und Deckellayout anpassen
    I2C-Seite und Fotoorientierung korrigieren, Holzlaschen verlegen und gerade anbinden sowie den Gitterrand schließen. STL, Vorschauen, 19 digitale Prüfgruppen und historische Gegenproben sichern. Druck-/CNC-Merkblatt und offene reale Passungsprüfungen dokumentieren.
2026-10-21 NeoPixel-Halter und CNC an reale Maße und Kabelführung anpassen
2026-10-21 cad: adapt PN532 mount to M2.5 and retain NeoPixel M2
2026-10-23 Fensterpositionen für die CNC-Übergabe eindeutig bemaßen
2026-10-28 Deckel-Eingänge am Expander bündeln und Kabelbedarf festhalten
2026-11-06 PN532 an reale Einbaulage und von oben gesetzte Inserts anpassen
2026-11-06 Encoder-Taster auf IO11 legen und IO12 für RFID-Wake freihalten
2026-11-07 NeoPixel-Halter auf obere ruthex-Einsätze und offene Schraubenkanäle umstellen
    Ersetzt M2-Muttern durch vorhandene RX-M2,5×5,7 und bestätigte M2,5×12. Nur die beiden dünnen Schraubhälse erhalten die notwendige volle Insertwand; PCB-Ebene, Lochorte, mittlerer Bereich, Laschen, Kabelausgang und CNC bleiben erhalten.
    Echte STL-, Mesh-, CGAL-Durchgangs-/Wand-/Zugangs- und Formvergleichstests mit Gegenproben, 21 Einsetzlagen sowie gerenderte Ansichten geprüft. Reale Nutzer-Kopfprobe anerkannt, fehlende Kopfmaße und physische Restprüfungen getrennt dokumentiert.
2026-11-10 RFID-Elektronik zum Glas ausrichten und untere Lasche vom Button abrücken
2026-11-10 RFID-Fotokorrektur mit dauerhaften Quellen und Findings nachvollziehbar sichern
2026-11-10 Aktuelle RFID- und NeoPixel-Referenzen statt überholter CAD-Vorgaben laden
2026-11-11 feat(firmware): commission assembled Boxbert and add USB diagnostics
    Map measured end-build inputs, preserve the verified ISR volume path, and pin NimBLE 2.3.8 after reproducing the Core 3.3.12 init panic. Keep missing peripherals and unverified power/sleep controls disabled in a quiet commissioning profile.
    Add bounded USB playback/radio diagnostics, standalone fallback sketches, regression tests, raw device logs, and a complete session handoff. Record the unreproduced Dateifehler, earlier restart/repeated-start observations, low heap headroom, and outstanding physical/audio/network acceptance without claiming fixes.
2026-11-11 Step-Up-Abschaltung begründen und aktuellen Amp-Anschluss festhalten
2026-11-13 test(nfc): verify PN532 UID and IRQ on assembled hardware
    Record confirmed I2C/IRQ wiring, standalone init and one-shot UID probes, bounded pending-response parsing with sanitizer coverage, and GPIO12 edge observation. The card remained present throughout; no replacement, removal or wake claim.
    Restore the verified integrated commissioning image with NFC runtime still disabled. Keep handoff, actual device state and bus-mutex integration blockers current; a post-API IRQ HIGH snapshot alone was not a wiring fault.
2026-11-13 feat(nfc): integrate split I2C scanning without holding bus while idle
    Separate search TX, ACK, target readiness and bounded UID reads. Preserve pending commands until completion, fail closed without ambiguous retries, and add explicit pause/resume requests that park only at a clean boundary.
    Enable NFC in the quiet commissioning profile; flash and log physical Tag1-to-Arcade playback through EOF and encoder cap. Keep hearing/display, AW-under-tagless-wait, clean parking, Tag2 mapping and full network/power acceptance open. Update dated protocol and live handoff.
2026-11-13 feat(audio): raise commissioning volume cap to 12 with quiet boot
    Keep boot volume 1 and missing/power/sleep features unchanged. Extend actual encoder host coverage for mute/max limits and record the user's NFC music/TFT confirmation.
    Confirm clean NFC parking before flashing exact verified volume12 artifacts, then observe scanner/decoder restart at volume 1. Keep higher-level acoustic acceptance and other unperformed hardware/network tests open in the live handoff.
2026-11-13 feat(audio): enable requested full 0-21 volume range with quiet boot
    Keep boot volume 1 and other commissioning flags unchanged. Verify tests, clean NFC parking, source/artifact hashes and exact upload before observing actual encoder values through 21 while playback runs.
    Document source-configured boot versus first captured volume, user-controlled high levels and remaining acoustic safety acceptance. Update current build, logs, API contract and live handoff.
2026-11-13 docs: Nutzerabnahmen und echten BLE-Abbruch dokumentieren
    Bedienung und Kartenwechsel vom Nutzer bestätigt; HappyTune als Soll, tatsächlicher Fart-Iststand bleibt unverändert. Live-Webasset mit Hostingrepo und lokalem Build abgeglichen, ohne Veröffentlichung.
    Offenen BLE-Versuch nie geflasht und vollständig zurückgesetzt. Geschützte v21-Firmware bleibt aktuell. Abbruchursache und Phase offen, generischer Schreibfehlerzusatz ist kein SD-Schadensnachweis.
2026-11-13 diag(ble): geschuetzten Verbindungsaufbau gezielt protokollieren
    Controllergrund per Queue an Mainloop reichen; feste Labels fuer hello/auth/read, Response und lokale Drop-Ursachen ohne Nutzdaten oder Geheimnisse. Keine neuen Delays, Timeouts oder Bibliotheken. Quellvertraege pruefen Callback-Trennung, Datenschutz und Auth-Gate.
    Build depm3fts und Tests erfolgreich, noch nicht geflasht: NFC-Pause wartet auf Tag/Park3. Installierter v21-Stand unveraendert, Fehlerursache weiterhin offen.
2026-11-13 fix(ble): falschen Soforttimeout bei neuerem Aktivitaetsstempel verhindern
    Trace belegt zweimal hello -> Antwortbereit -> lokalen Timeout innerhalb 1ms vor Auth. Alter Loop-Zeitstempel minus frisches millis() unterlief. Halbintervallpruefung bewahrt echte 10s/30s-Deadlines und millis-Wrap; Produktionsregression erst RED dann GREEN, 20 native Programme bestanden.
    Nach Park3 exakt verifizierten Fixbuild prnsjyfe geflasht. Echter Androidversuch uebertraegt hello/auth1/read vollstaendig, auch weitere Strecke bei Decoderlauf. Weitere PWA-Nutzersicht und Persistenzabnahme offen. Keine Auth-/Bibliotheks-/Webdeploy-Aenderung; alter offener Testbuild bleibt verworfen.
2026-11-13 test(app): langsamen Introtransfer pruefen und PC-BLE-Grenze belegen
    Unveraenderter Produktcode besteht mehr als 30s virtuellen HTTP-Upload; Intro nutzt bereits Uploadbudget. Fruehere Vermutung widerlegt, keine blinde Timeoutanhebung. 69 App-Tests und Browserfixture gruen, kein Live-BLE-Uploadnachweis.
    Handybedienung bestaetigt, Button1-Gruen-Ziel noch nicht umverdrahtet/umgemappt. Vorhandener PC-Controller kann BR/EDR, aber kein LE; kein PC-GATT, Firmwareflash oder Webdeploy vorgenommen.
2026-11-13 fix(app): Uploaddisplay wachhalten und Introfortschritt sichtbar machen
    Best-effort Screen Wake Lock fuer echte Transfers; Warnungen und Visibility-Reacquire, sofortige Abortfreigabe, idempotentes Cleanup und spaete Grants abgesichert. Globaler Prozentfortschritt und Abbrechen auch im Zuordnungsreiter.
    Live-RX-Timeout nach unvollstaendiger Anfrage dokumentiert; Nutzer bestaetigt Display aus. 81 App-Tests, HTTP-/Demo-/HTTPS-Browserfaelle und beide Builds gruen. Android-Wake-Lock/Introabschluss noch offen; keine Timeouts, Button-IDs oder Firmware geaendert, kein Hostingdeploy.
2026-11-13 docs: freigegebene Webaktivierung und SSH-Zugangsgrenze festhalten
2026-11-14 docs: Vorfuehrwunsch sichern und fehlende SD vor Flash festhalten
2026-11-14 feat(firmware): explizite Vorfuehrzuordnung vorbereiten, Flashblocker sichern
    Lokales demo-songs kopiert gesunde Konfiguration, setzt nur Arcade/HappyTune und leises Volume1; keine Bootmigration. Native Parser-/Quellvertraege und Crosscompile gruen, Buildmanifest nach identischem Resume/24Sourcechecks dokumentiert.
    SD nach NutzerRESET wieder erkannt. Kein Flash und keine Mappingaenderung: NFC vor Flash nichtgeparkt, Nutzer weggegangen. Pause zurueckgenommen, letzterStand weiter Arcade/Fart, SD/config1,Volume1,NFC1/pause0. HappyTune aufTag2 ausdruecklich noch offen.
2026-11-14 docs(firmware): bestaetigten Vorfuehrflash Arcade und Pups nachweisen
    NFC-Park3,24Sourcechecks und Artefakthashes vor Upload bestaetigt. Exakter uluu6evy-Build nach App-Port-Reenumeration am Bootloader erfolgreich mit Hashverifikation geflasht. SD/config1,Rev150,Volume1,NFC1/pause0; USB9/10 oeffnen und decodieren Arcade/Fart, danachStop.
    Zuletzt klar benannte und bestaetigte Vorfuehrzuordnung Arcade/Pups erhalten. demo-songs bewusst NICHT ausgefuehrt. Neuer physischerTag-/Hoertest nicht behauptet; Web-/Introcheckpoint und offener SD-Startfehler erhalten.
